Merophy/enzyme/README.md

# enzyme
Enzymes are proteins that help speed up metabolism, or the chemical reactions in our bodies. They build some substances and break others down. All living things have enzymes.
