Merophy/enzyme/kiCad-solids/BallGridArray/CLG484.step

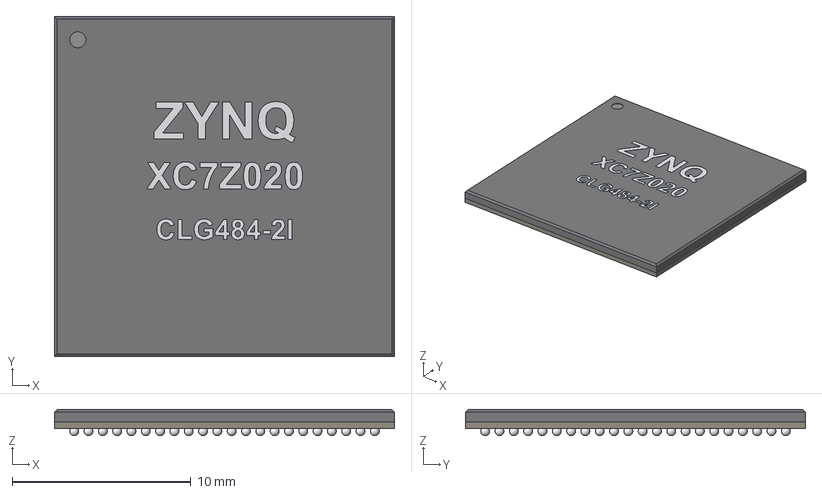
[picture p1: CAD file, 2026-10-07]
kiCad-solids/BallGridArray/CLG484.step
19.0 x 19.0 x 1.47 mm
Substrate
Pin1
Balls
Marking
