Merophy/enzyme/kiCad-solids/Bar/Copper_20x2.5x0.8mm.step

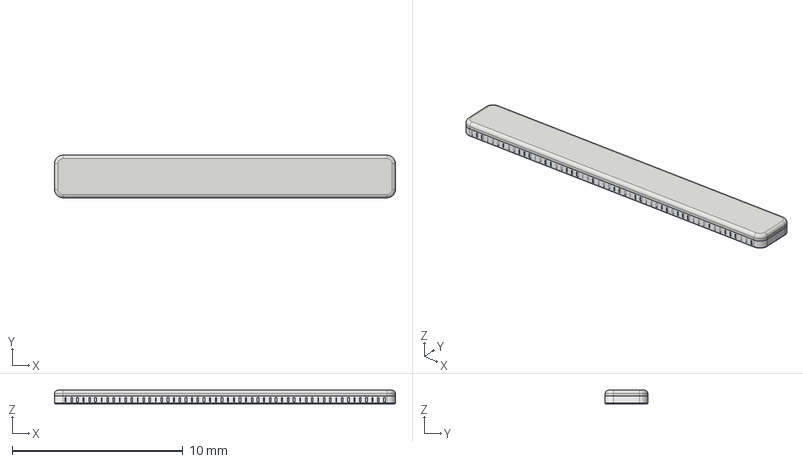
[picture p2: CAD file, 2026-10-09]
kiCad-solids/Bar/Copper_20x2.5x0.8mm.step
20.0 x 2.50 x 0.8 mm
TinTop
TinCut
