Merophy/enzyme/kiCad-solids/Batteries/9VDuracellBattery.step

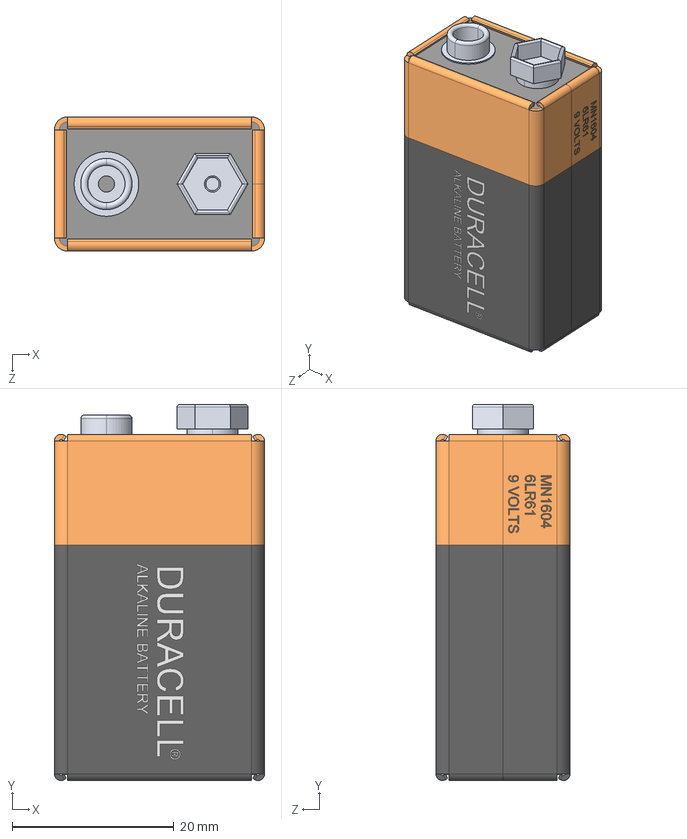
[picture p3: CAD file, 2024-03-21]
kiCad-solids/Batteries/9VDuracellBattery.step
26.0 x 46.5 x 16.6 mm
