Merophy/enzyme/kiCad-solids/Capacitors/C-0201-0603.step

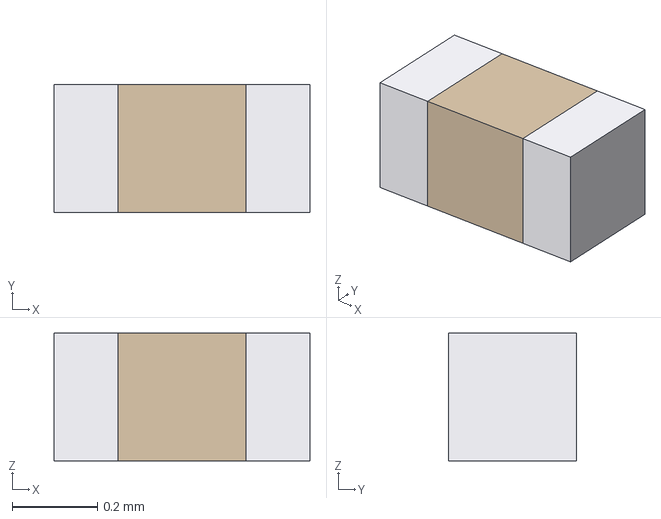
[picture p4: CAD file, 2026-10-22]
kiCad-solids/Capacitors/C-0201-0603.step
0.6 x 0.3 x 0.3 mm
MLCC
Terminals
