Merophy/enzyme/kiCad-solids/Connectors/SMTSO4260.step

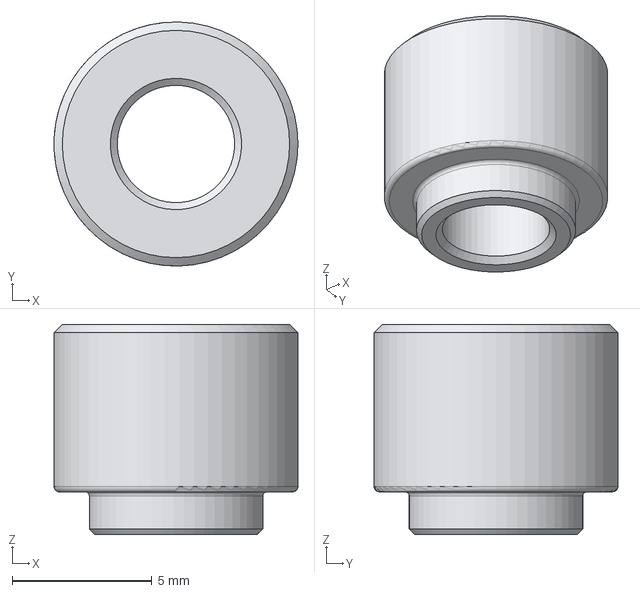
[picture p5: CAD file, 2026-10-24]
kiCad-solids/Connectors/SMTSO4260.step
8.74 x 8.74 x 7.53 mm
