Merophy/enzyme/kiCad-solids/Crystals/Oscillator_SMD_3.2x2.5mm.step

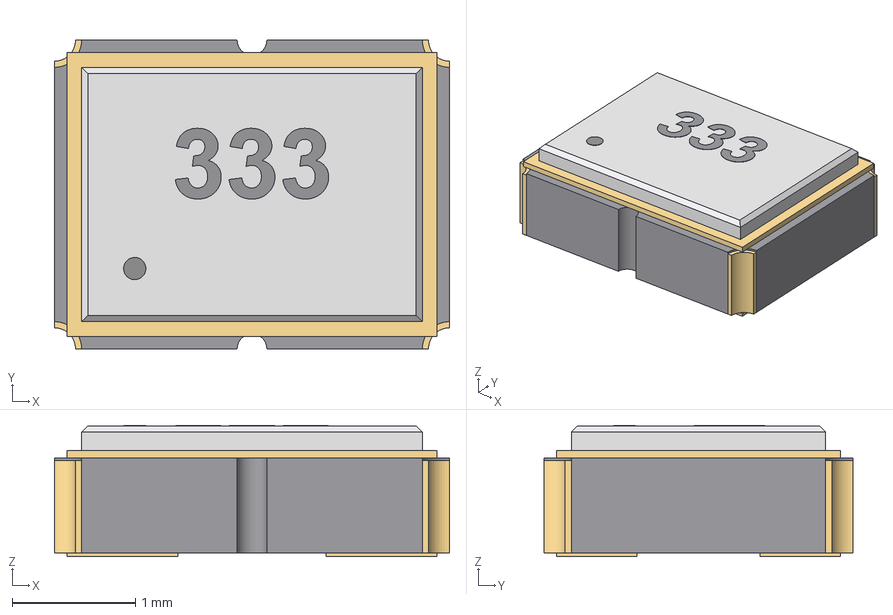
[picture p6: CAD file, 2026-10-09]
kiCad-solids/Crystals/Oscillator_SMD_3.2x2.5mm.step
3.20 x 2.50 x 1.06 mm
Ceramic
Gold
Lid
Pin1
Ink
