Merophy/enzyme/kiCad-solids/Diodes/SOD-523.step

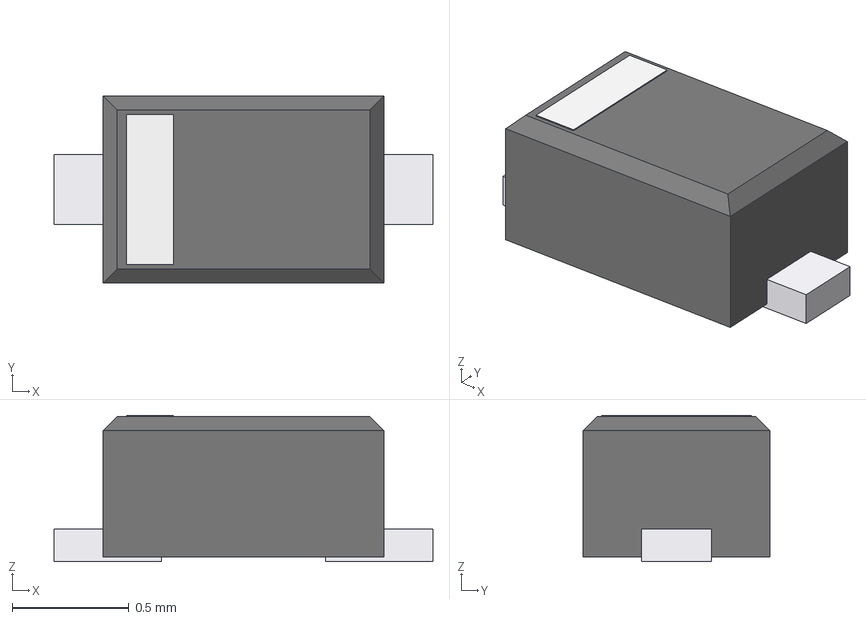
[picture p7: CAD file, 2026-09-24]
kiCad-solids/Diodes/SOD-523.step
1.62 x 0.8 x 0.625 mm
Band
Pin1
Pin2
