Merophy/enzyme/kiCad-solids/DualFlat/PG-TSNP-7-11.step

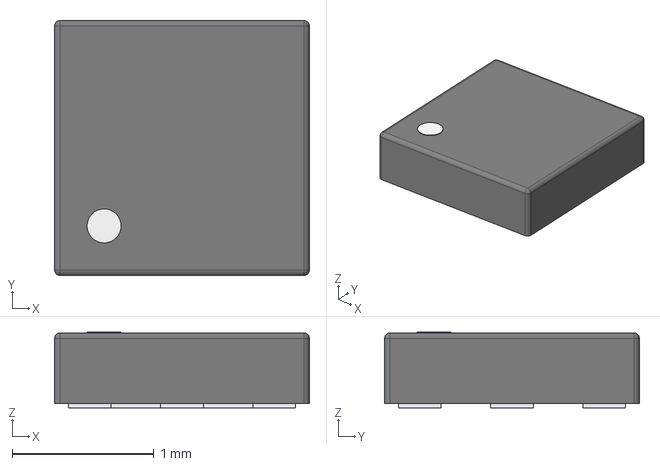
[picture p8: CAD file, 2026-10-24]
kiCad-solids/DualFlat/PG-TSNP-7-11.step
1.80 x 1.80 x 0.535 mm
