Merophy/enzyme/kiCad-solids/Electromechanic/TF-01A.step

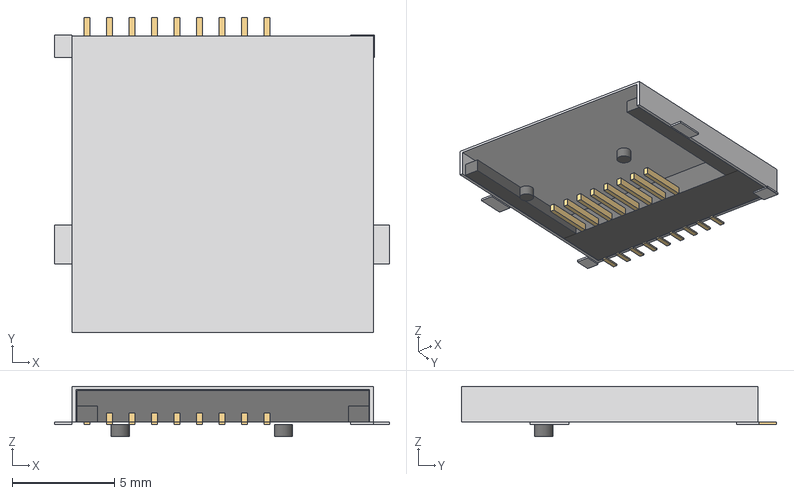
[picture p9: CAD file, 2026-10-22]
kiCad-solids/Electromechanic/TF-01A.step
16.4 x 15.4 x 2.45 mm
Lid
Gold
