Merophy/enzyme/kiCad-solids/Filters/FL-3.2x1.6x1.6mm.step

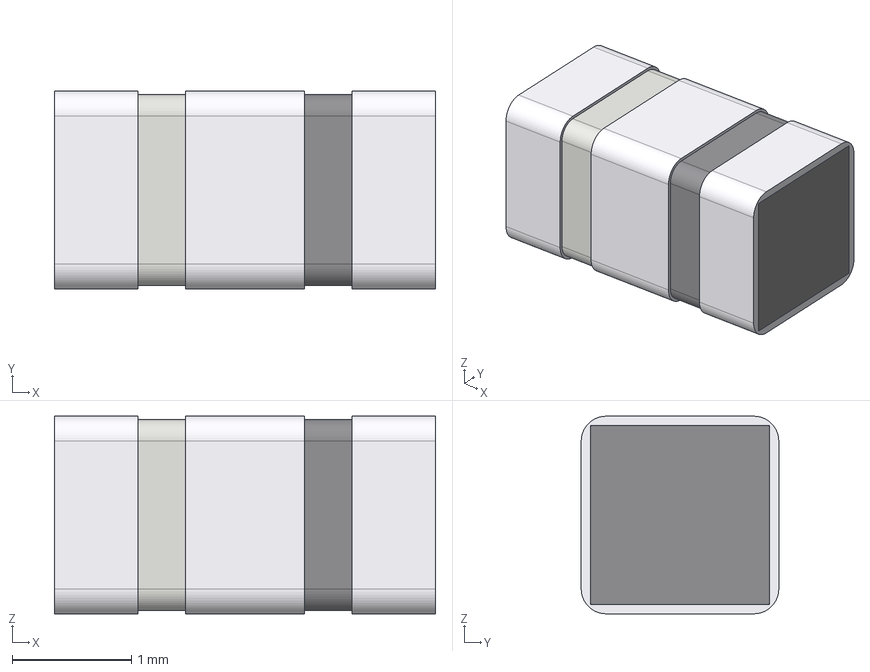
[picture p10: CAD file, 2026-10-22]
kiCad-solids/Filters/FL-3.2x1.6x1.6mm.step
3.20 x 1.66 x 1.66 mm
CeramicLight
Ferrite
Leads
