Merophy/enzyme/kiCad-solids/Inductors/HX5008NL.step

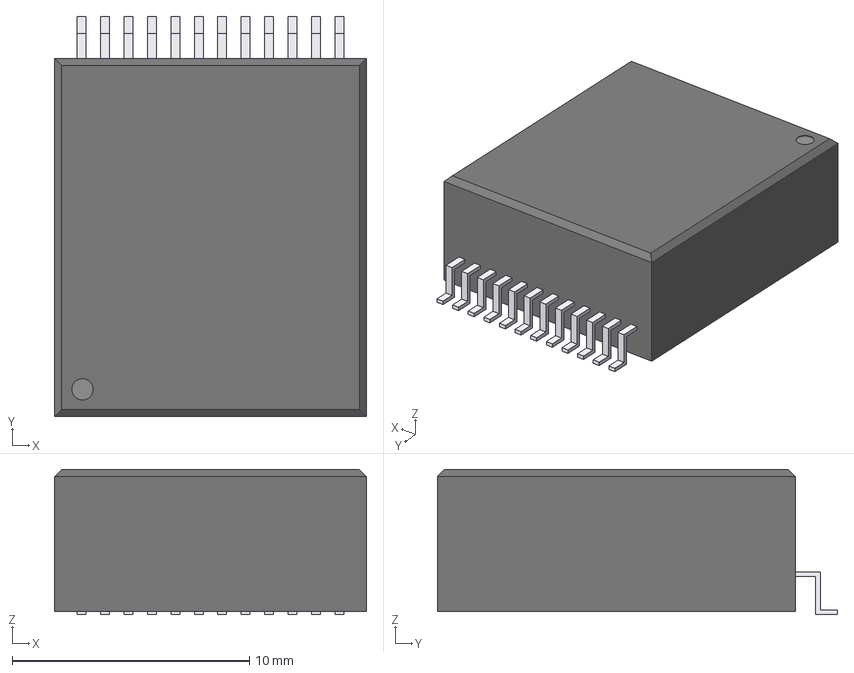
[picture p11: CAD file, 2026-10-22]
kiCad-solids/Inductors/HX5008NL.step
13.2 x 16.9 x 6.12 mm
Leads
Pin1
