Merophy/enzyme/kiCad-solids/LandGridArray/LGA-33_7x7mm.step

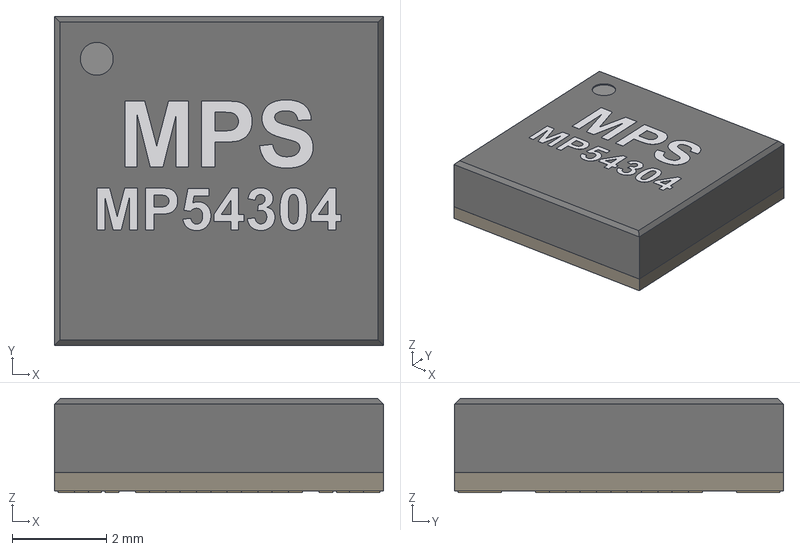
[picture p12: CAD file, 2026-10-09]
kiCad-solids/LandGridArray/LGA-33_7x7mm.step
7.00 x 7.00 x 2.00 mm
Substrate
Gold
Pin1
Marking
