Merophy/enzyme/kiCad-solids/Mechanic/M3_LowHead.step

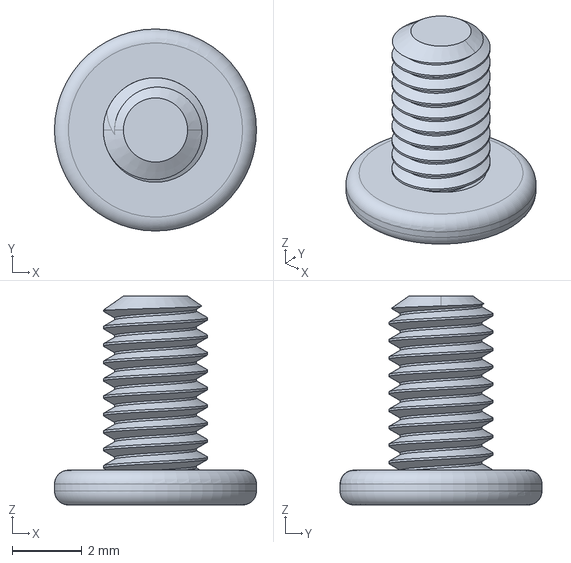
[picture p13: CAD file, 2025-07-31]
kiCad-solids/Mechanic/M3_LowHead.step
5.80 x 5.80 x 6.00 mm
