Merophy/enzyme/kiCad-solids/Modules/MS4525DO.step

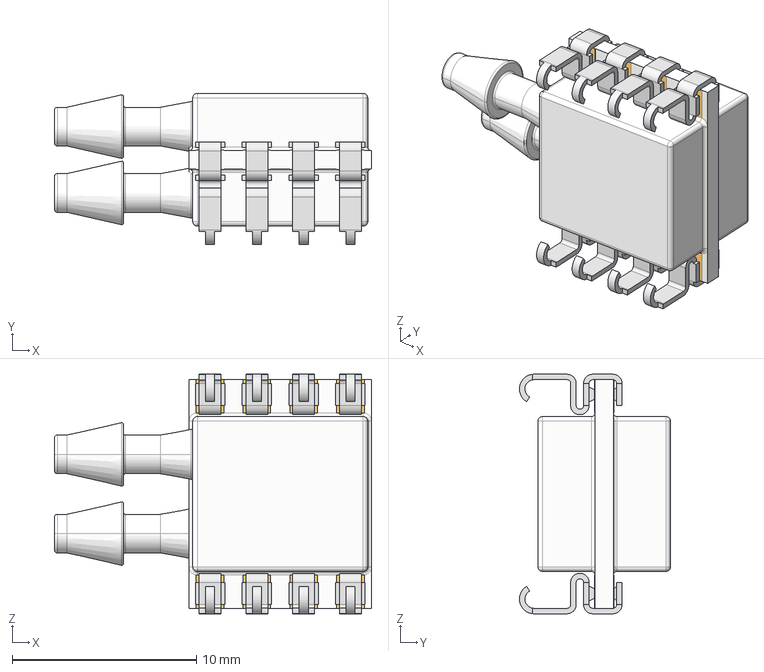
[picture p14: CAD file, 2025-08-16]
kiCad-solids/Modules/MS4525DO.step
17.2 x 8.20 x 13.0 mm
