Merophy/enzyme/kiCad-solids/QuadFlat/VQFN-14-EP_3.5x3.5mm_RGY.step

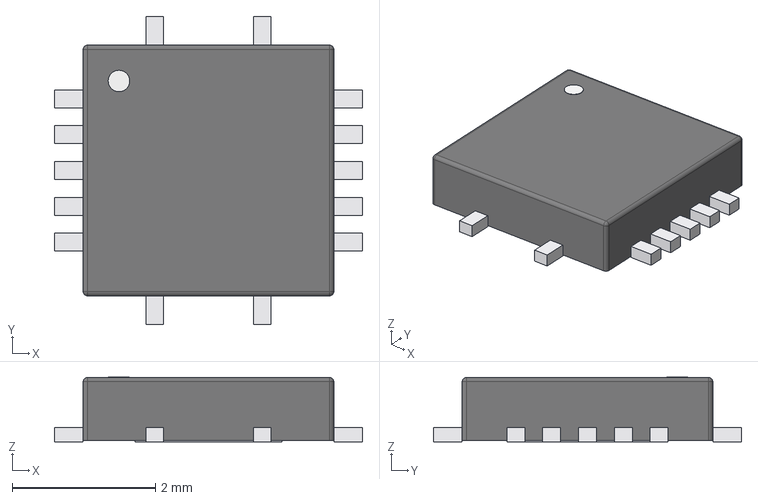
[picture p15: CAD file, 2026-10-29]
kiCad-solids/QuadFlat/VQFN-14-EP_3.5x3.5mm_RGY.step
4.30 x 4.30 x 0.905 mm
