Merophy/enzyme/kiCad-solids/Radio/TAOGLAS_PA.25A.step

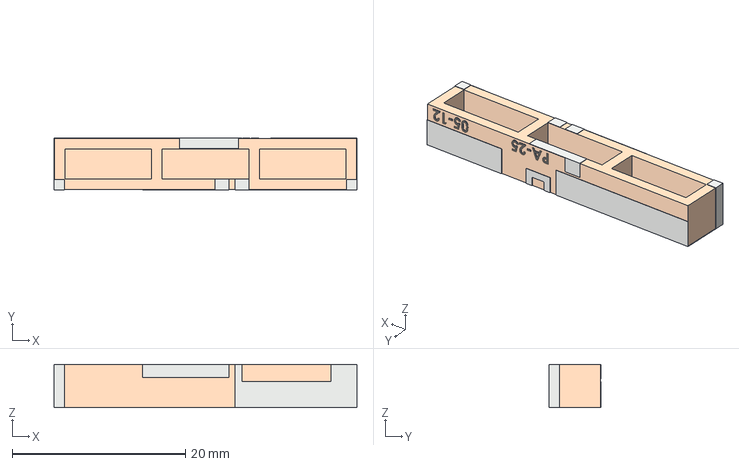
[picture p16: CAD file, 2022-10-01]
kiCad-solids/Radio/TAOGLAS_PA.25A.step
35.0 x 6.00 x 5.00 mm
