Merophy/enzyme/kiCad-solids/Resistors/R-0612-1632.step

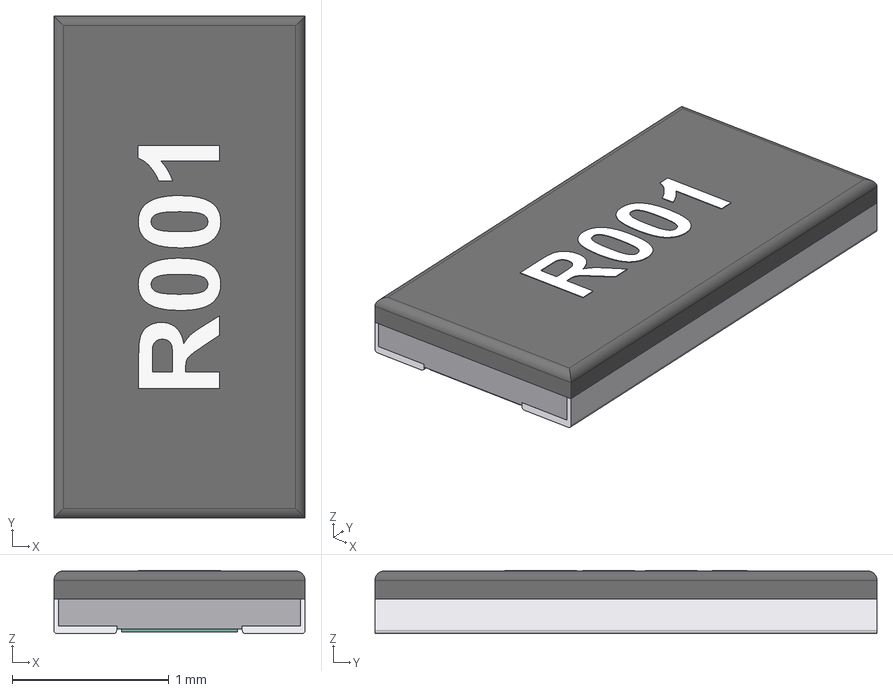
[picture p17: CAD file, 2026-10-07]
kiCad-solids/Resistors/R-0612-1632.step
1.60 x 3.20 x 0.404 mm
Epoxy
Alloy
Coating
Pin1
Pin2
Marking
