Merophy/enzyme/kiCad-solids/SmallOutline/SOT-563.step

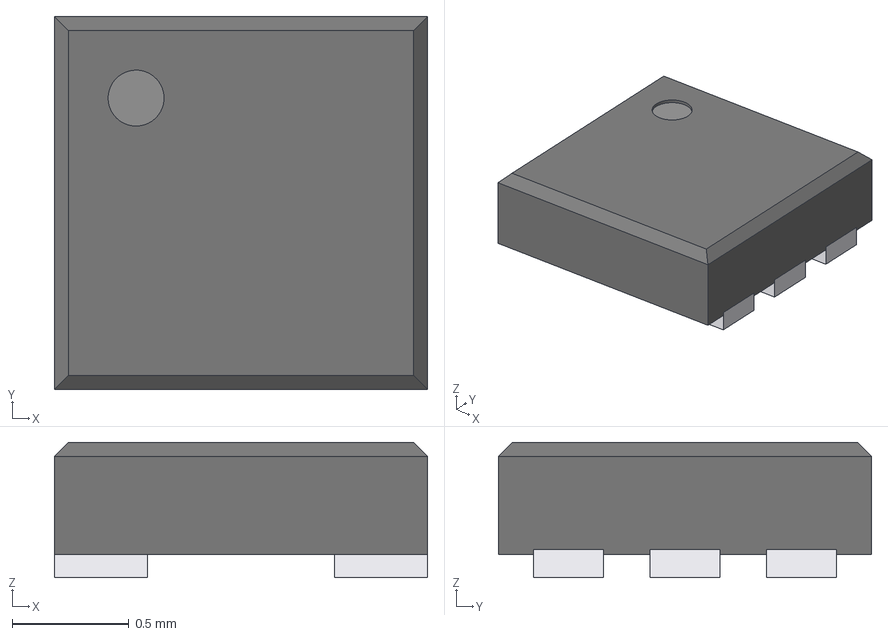
[picture p18: CAD file, 2026-10-16]
kiCad-solids/SmallOutline/SOT-563.step
1.60 x 1.60 x 0.58 mm
Leads
Pin1
