Merophy/enzyme/kiCad-solids/BallGridArray/TFBGA265_14X14.step

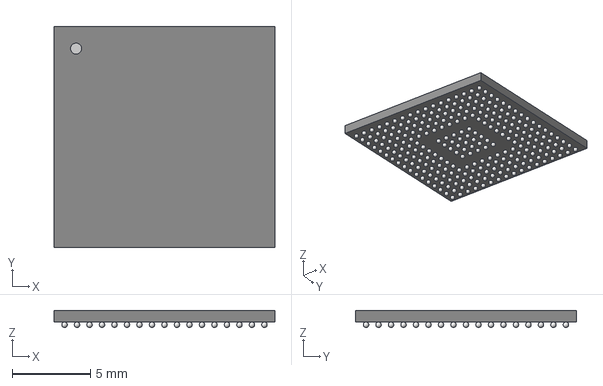
[picture p19: CAD file, 2026-01-16]
kiCad-solids/BallGridArray/TFBGA265_14X14.step
14.1 x 14.1 x 1.09 mm
