Merophy/enzyme/kiCad-solids/Bar/Copper_17x3x2.8mm.step

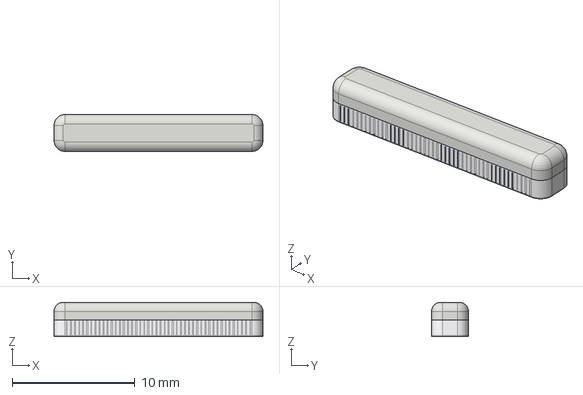
[picture p20: CAD file, 2026-10-09]
kiCad-solids/Bar/Copper_17x3x2.8mm.step
17.0 x 3.00 x 2.80 mm
TinTop
TinCut
