Merophy/enzyme/kiCad-solids/Batteries/MS621FE.step

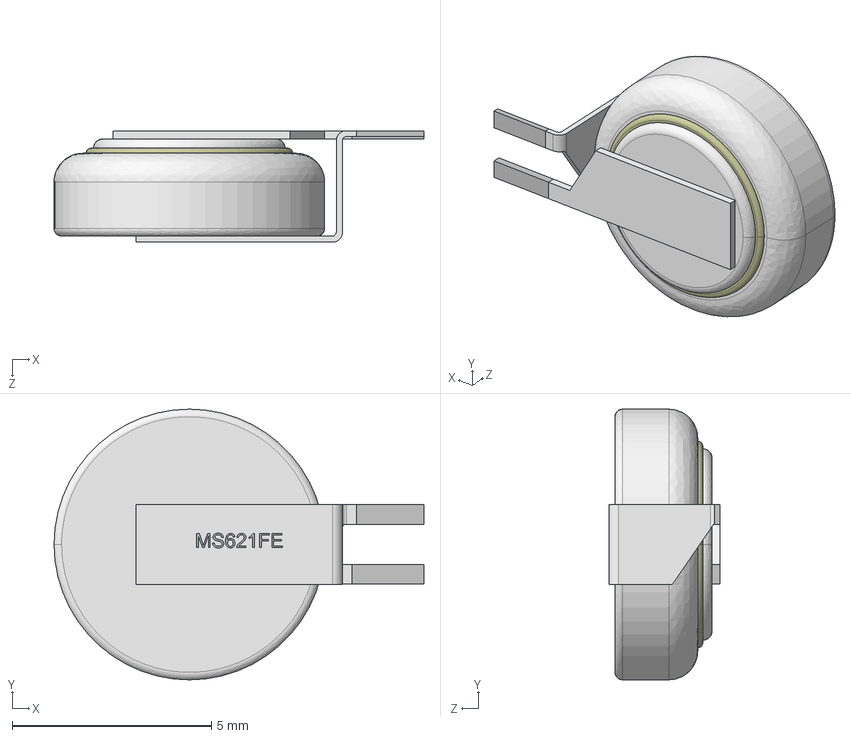
[picture p21: CAD file, 2022-10-01]
kiCad-solids/Batteries/MS621FE.step
9.29 x 6.80 x 2.80 mm
