Merophy/enzyme/kiCad-solids/Capacitors/CP-3528.step

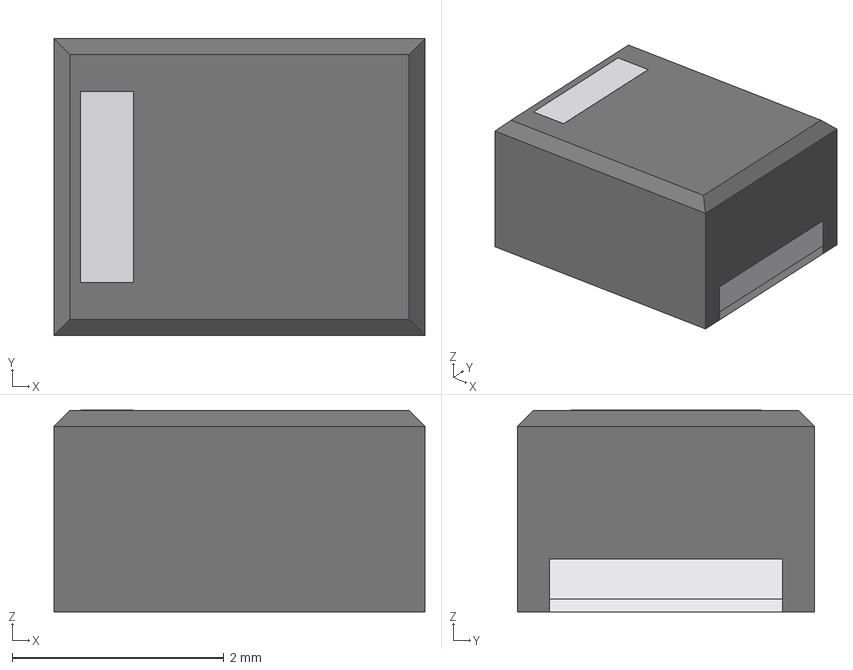
[picture p22: CAD file, 2026-10-22]
kiCad-solids/Capacitors/CP-3528.step
3.50 x 2.80 x 1.90 mm
Leads
Marking
