Merophy/enzyme/kiCad-solids/Crystals/Xtal_SMD_3215.step

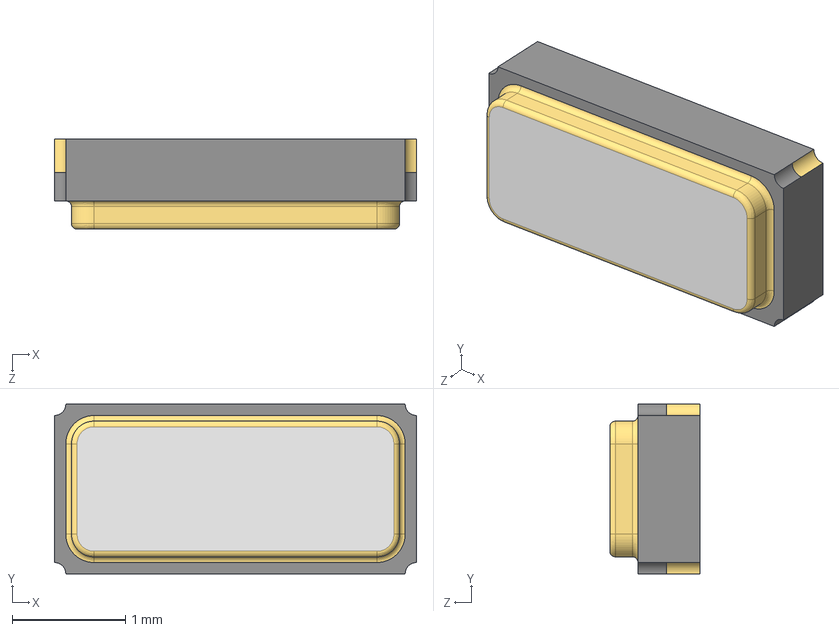
[picture p23: CAD file, 2026-01-16]
kiCad-solids/Crystals/Xtal_SMD_3215.step
3.20 x 1.50 x 0.8 mm
