Merophy/enzyme/kiCad-solids/Diodes/LED-2835.step

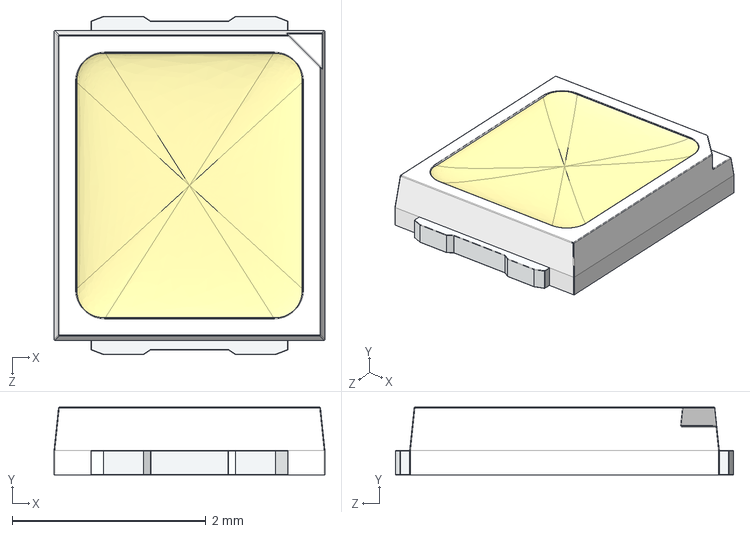
[picture p24: CAD file, 2025-07-24]
kiCad-solids/Diodes/LED-2835.step
2.80 x 0.7 x 3.50 mm
