Merophy/enzyme/kiCad-solids/DualFlat/WSON-10-EP_3x3mm_DSC.step

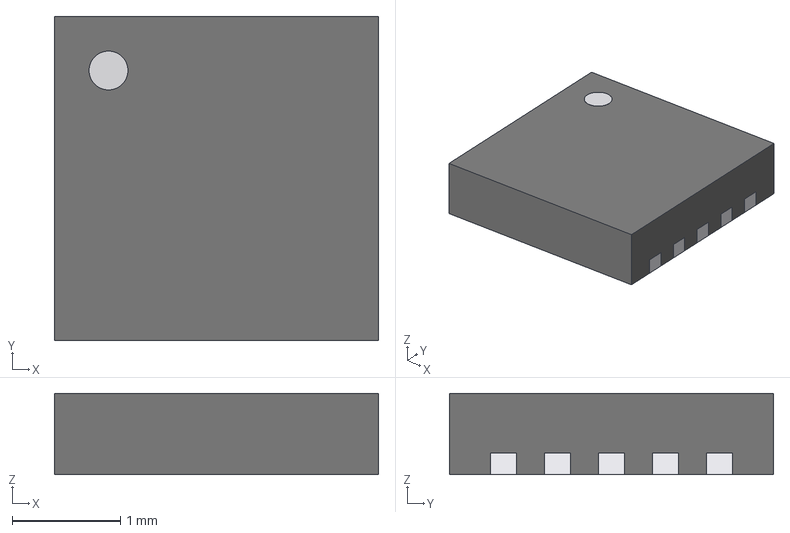
[picture p25: CAD file, 2026-10-22]
kiCad-solids/DualFlat/WSON-10-EP_3x3mm_DSC.step
3.00 x 3.00 x 0.751 mm
Leads
Marking
