Merophy/enzyme/kiCad-solids/Electromechanic/RS08U111Z001.STEP

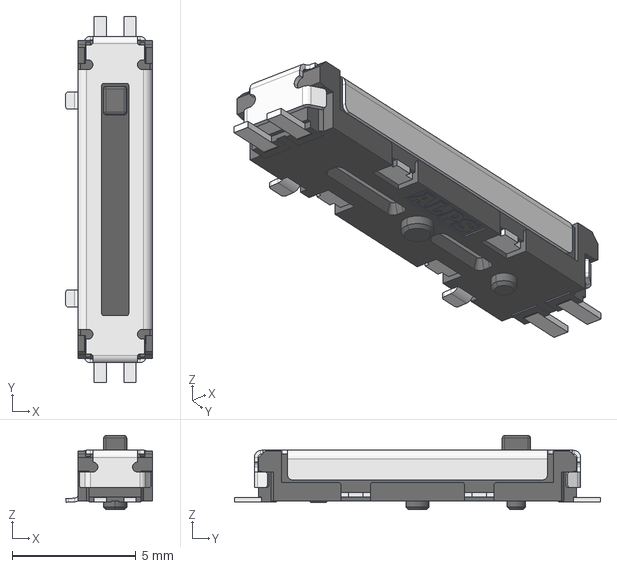
[picture p26: CAD file, 2025-05-27]
kiCad-solids/Electromechanic/RS08U111Z001.STEP
3.50 x 14.8 x 3.00 mm
