Merophy/enzyme/kiCad-solids/Inductors/L-2.5x2.0x1.2mm.step

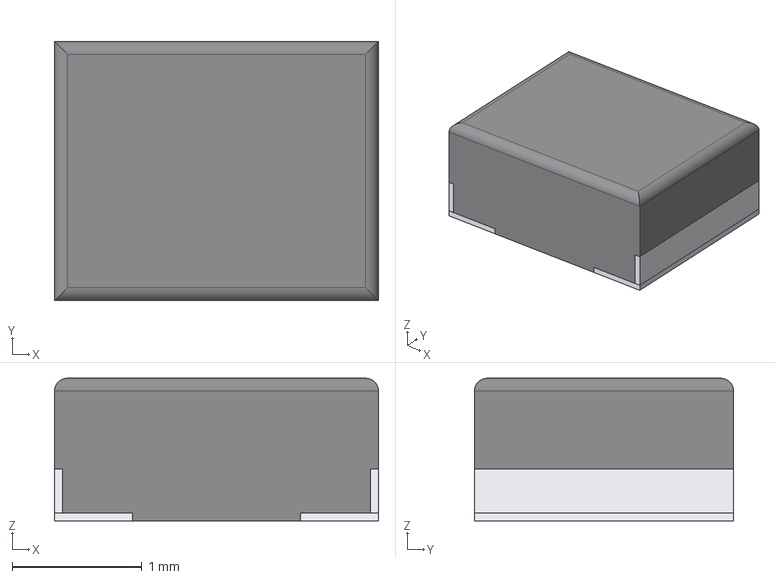
[picture p27: CAD file, 2026-10-22]
kiCad-solids/Inductors/L-2.5x2.0x1.2mm.step
2.50 x 2.00 x 1.10 mm
Ferrite
Leads
