Merophy/enzyme/kiCad-solids/Mechanic/M3 x 0.5mm Thread 35mm.STEP

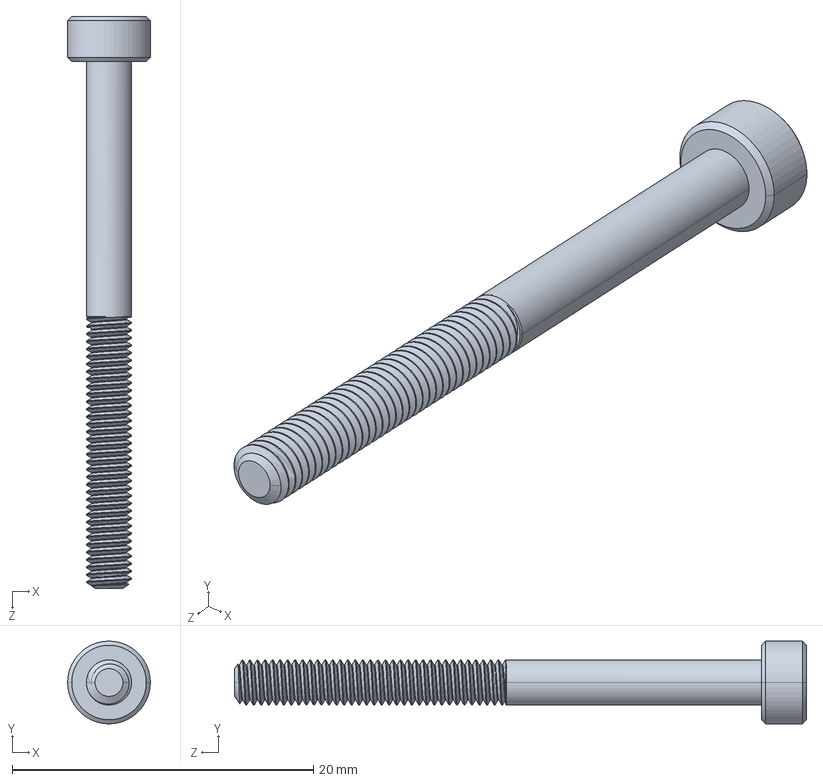
[picture p28: CAD file, 2025-02-19]
kiCad-solids/Mechanic/M3 x 0.5mm Thread 35mm.STEP
5.50 x 5.50 x 38.0 mm
