Merophy/enzyme/kiCad-solids/Modules/fan_40_40_28_coloured.step

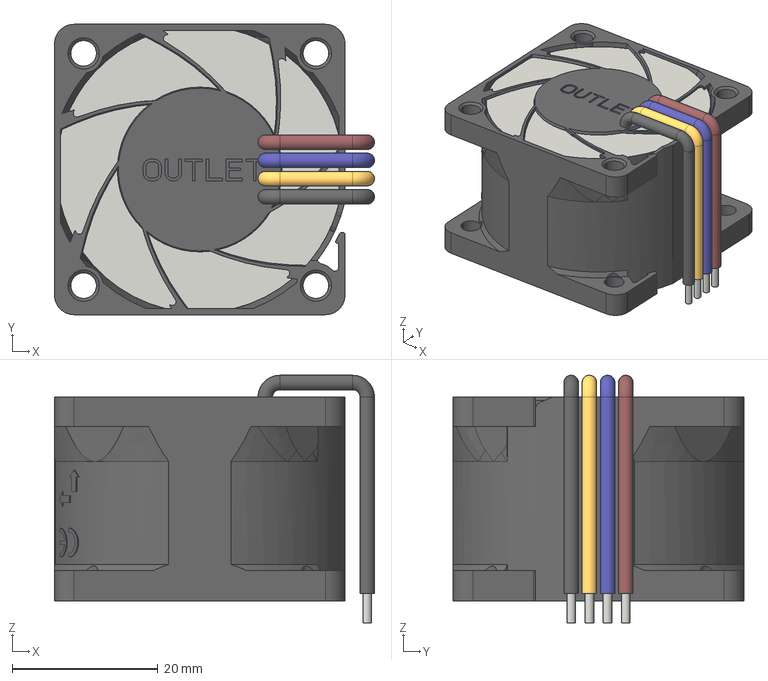
[picture p29: CAD file, 2025-02-14]
kiCad-solids/Modules/fan_40_40_28_coloured.step
43.9 x 39.9 x 34.0 mm
_K201001120G-3_
