Merophy/enzyme/kiCad-solids/QuadFlat/WQFN-24-EP_4x4mm_RTW.step

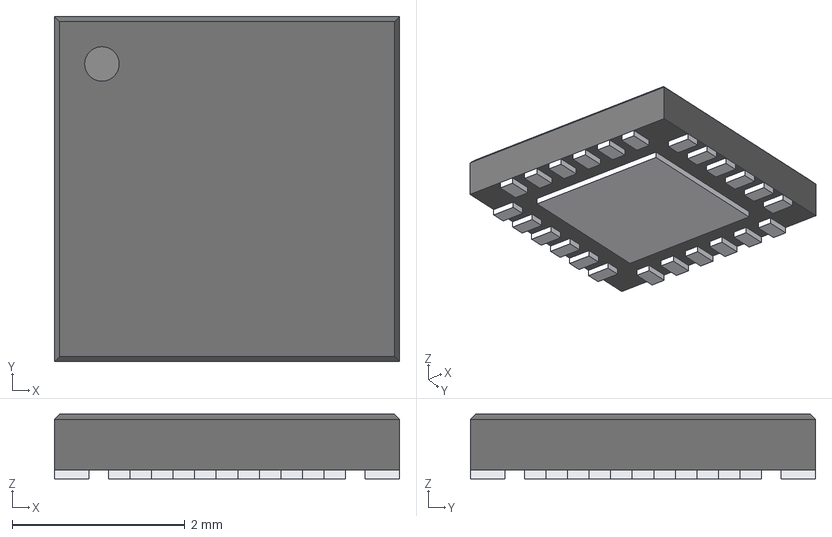
[picture p30: CAD file, 2026-10-22]
kiCad-solids/QuadFlat/WQFN-24-EP_4x4mm_RTW.step
4.00 x 4.00 x 0.75 mm
Leads
Pin1
