Merophy/enzyme/kiCad-solids/Resistors/R-0402-1005.step

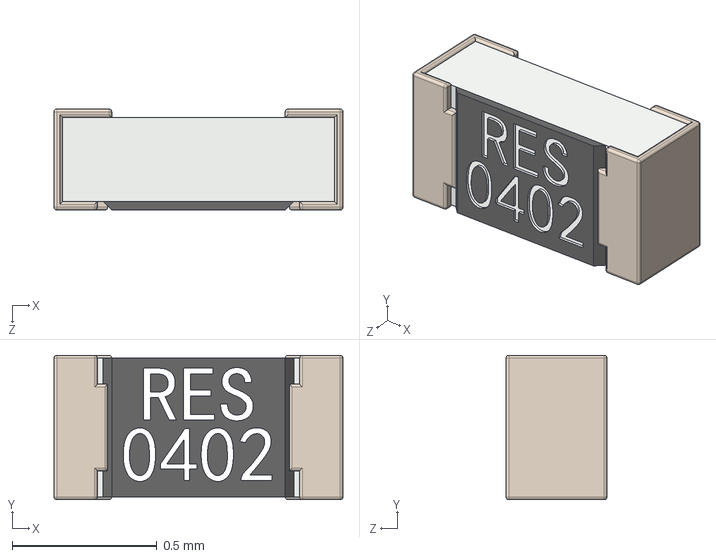
[picture p31: CAD file, 2026-01-05]
kiCad-solids/Resistors/R-0402-1005.step
1.00 x 0.5 x 0.35 mm
