Merophy/enzyme/kiCad-solids/SmallOutline/VSSOP-10_3x3mm.step

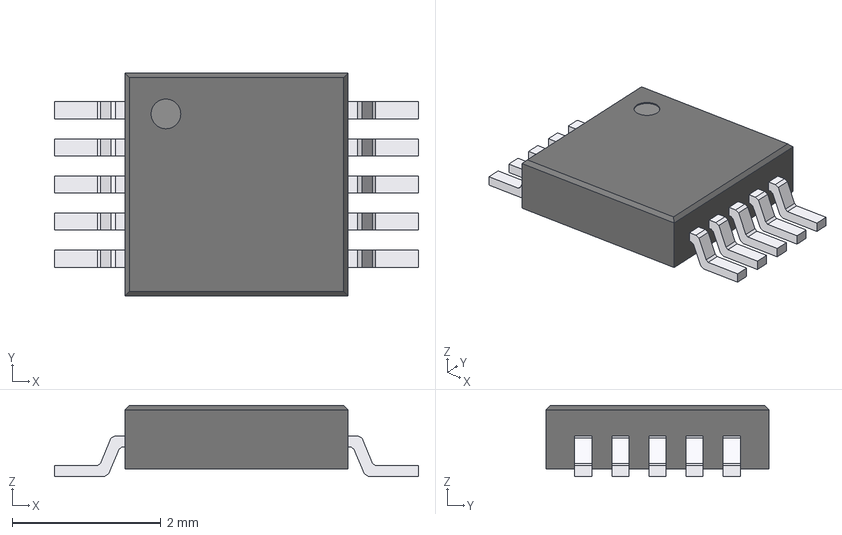
[picture p32: CAD file, 2026-10-14]
kiCad-solids/SmallOutline/VSSOP-10_3x3mm.step
4.90 x 3.00 x 0.96 mm
Leads
Pin1
