Merophy/enzyme/kiCad-solids/Capacitors/C-1210.STEP

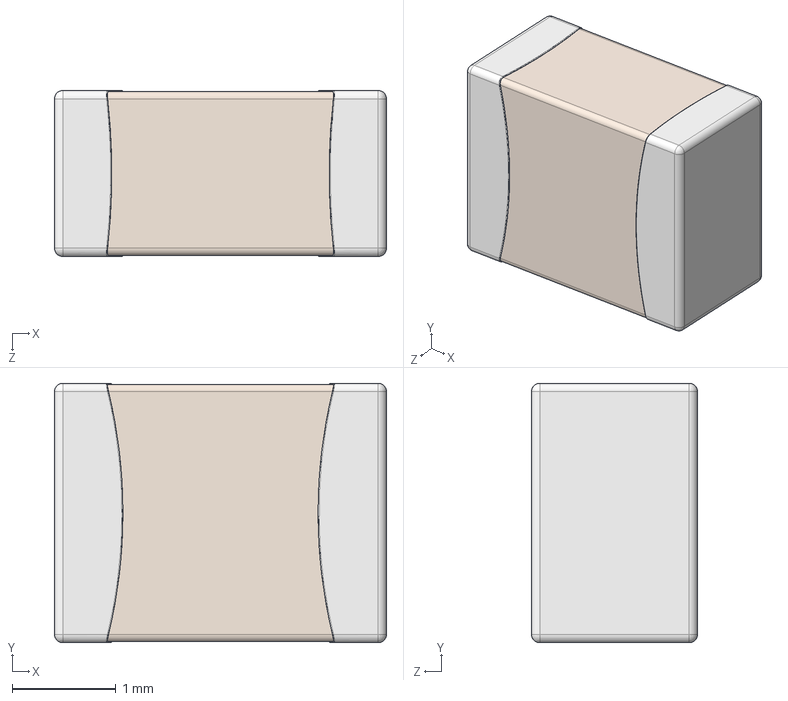
[picture p33: CAD file, 2026-01-05]
kiCad-solids/Capacitors/C-1210.STEP
3.20 x 2.50 x 1.60 mm
Pin1
Pin2
CeramicBody
