Merophy/enzyme/kiCad-solids/Connectors/RJHSE-5381.step

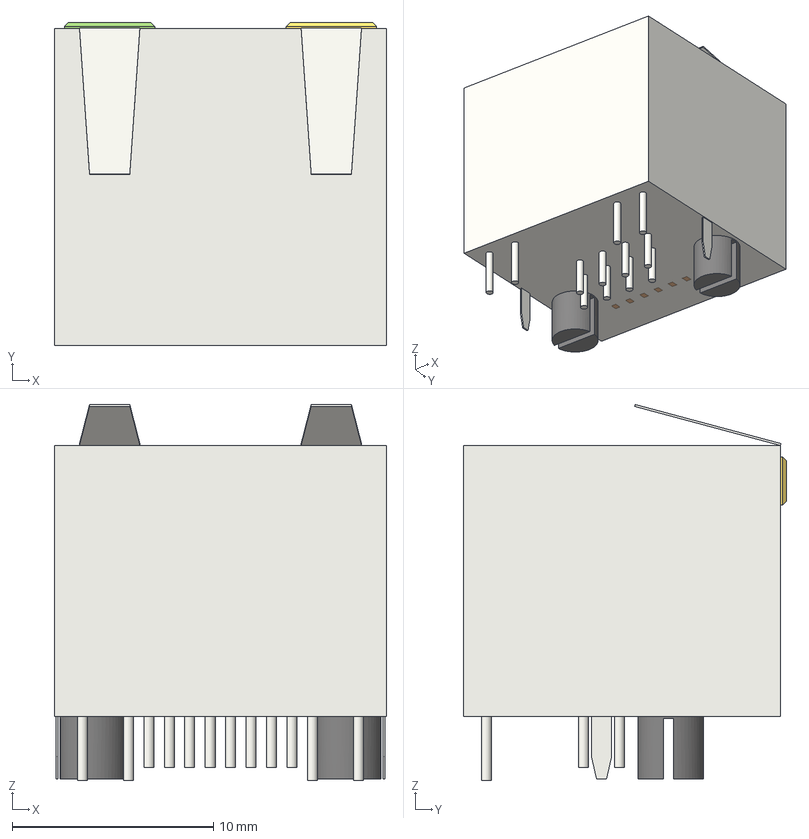
[picture p34: CAD file, 2026-10-22]
kiCad-solids/Connectors/RJHSE-5381.step
16.5 x 16.1 x 18.7 mm
