Merophy/enzyme/kiCad-solids/Crystals/CSTNE.step

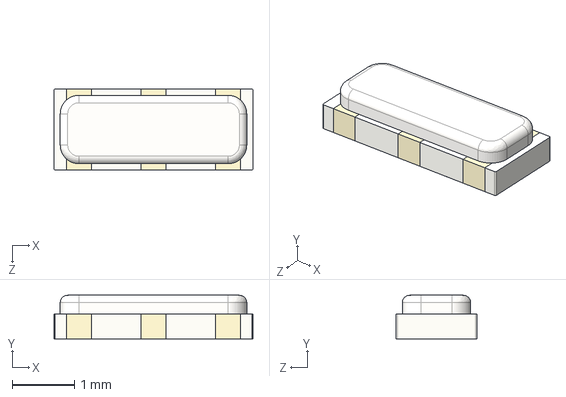
[picture p35: CAD file, 2022-03-06]
kiCad-solids/Crystals/CSTNE.step
3.20 x 0.7 x 1.30 mm
