Merophy/enzyme/kiCad-solids/Diodes/WS2812-2020.STEP

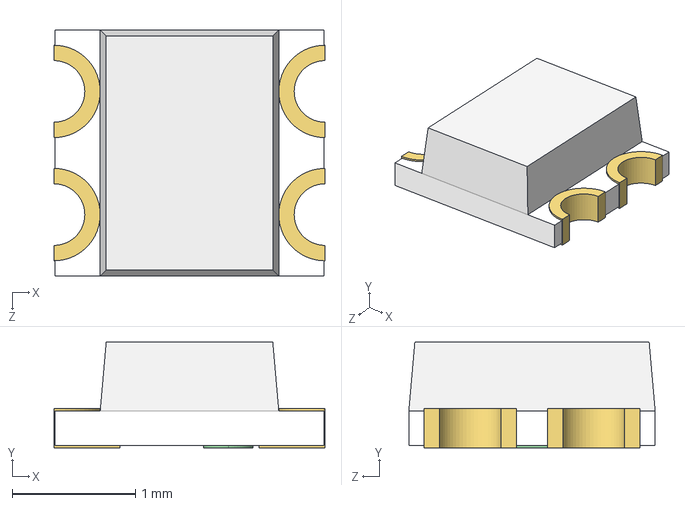
[picture p36: CAD file, 2025-03-19]
kiCad-solids/Diodes/WS2812-2020.STEP
2.20 x 0.86 x 2.00 mm
