Merophy/enzyme/kiCad-solids/DualFlat/VSON-6_1.5x1.5mm_DMQ.step

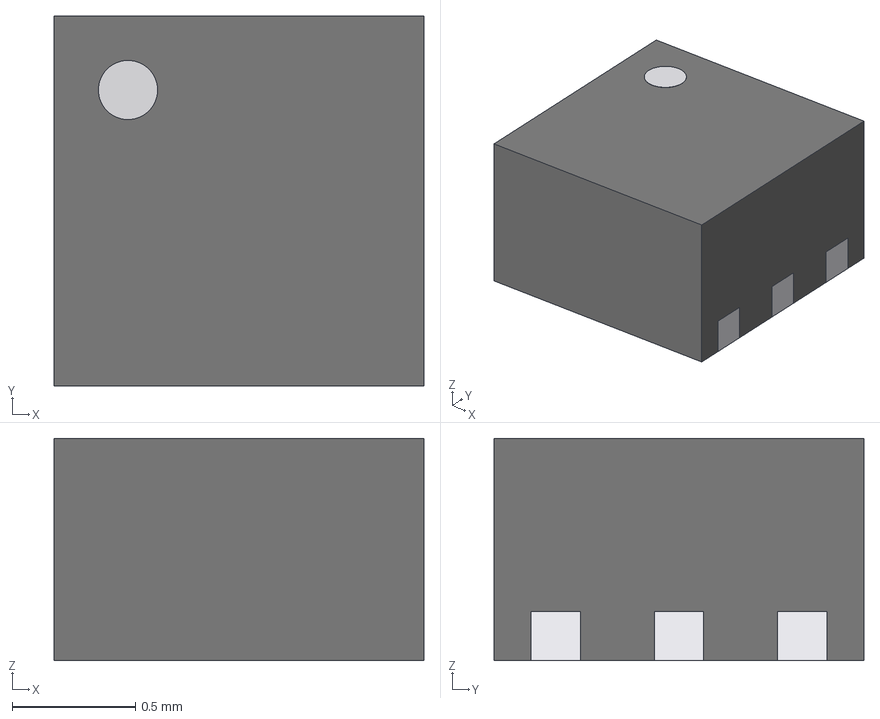
[picture p37: CAD file, 2026-10-22]
kiCad-solids/DualFlat/VSON-6_1.5x1.5mm_DMQ.step
1.50 x 1.50 x 0.901 mm
Leads
Marking
