Merophy/enzyme/kiCad-solids/Inductors/L-1206.step

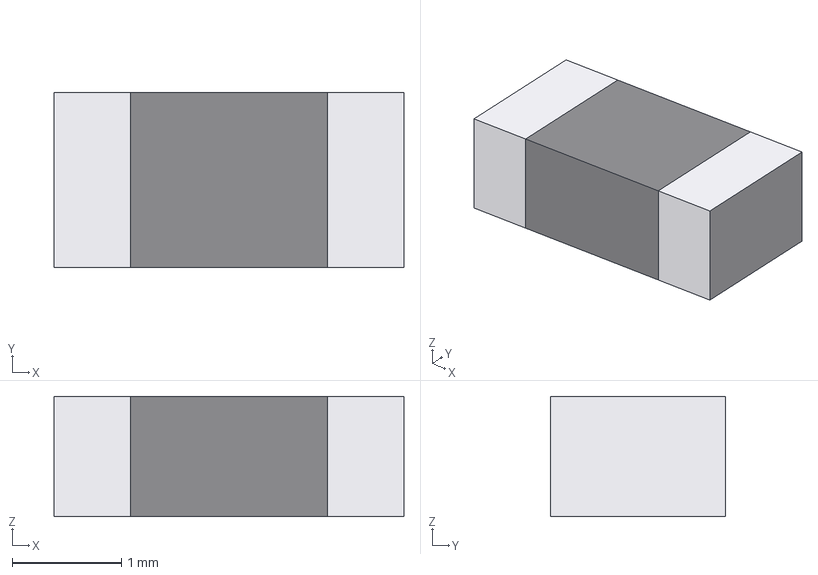
[picture p38: CAD file, 2026-10-22]
kiCad-solids/Inductors/L-1206.step
3.20 x 1.60 x 1.10 mm
Ferrite
Leads
