Merophy/enzyme/kiCad-solids/Mechanic/M2 x 0.4mm Thread 5mm.STEP

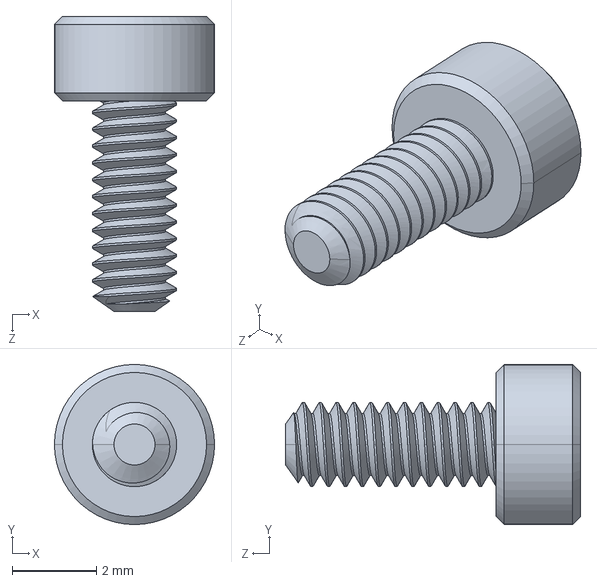
[picture p39: CAD file, 2025-02-19]
kiCad-solids/Mechanic/M2 x 0.4mm Thread 5mm.STEP
3.80 x 3.80 x 7.00 mm
