Merophy/enzyme/kiCad-solids/Modules/ESC_FLAME_80A_Coloured.step

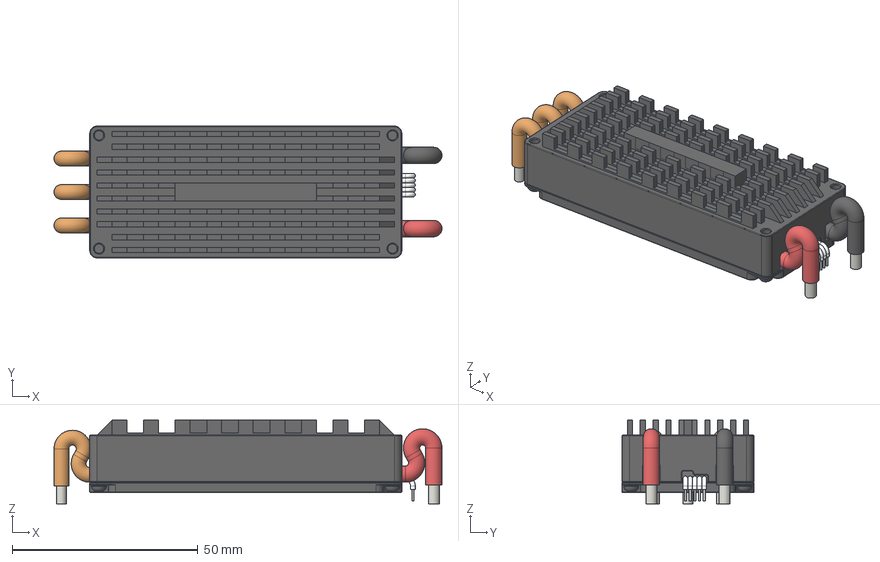
[picture p40: CAD file, 2025-02-14]
kiCad-solids/Modules/ESC_FLAME_80A_Coloured.step
104.4 x 35.5 x 22.5 mm
