Merophy/enzyme/kiCad-solids/QuadFlat/QFN-36-EP_6x6mm.step

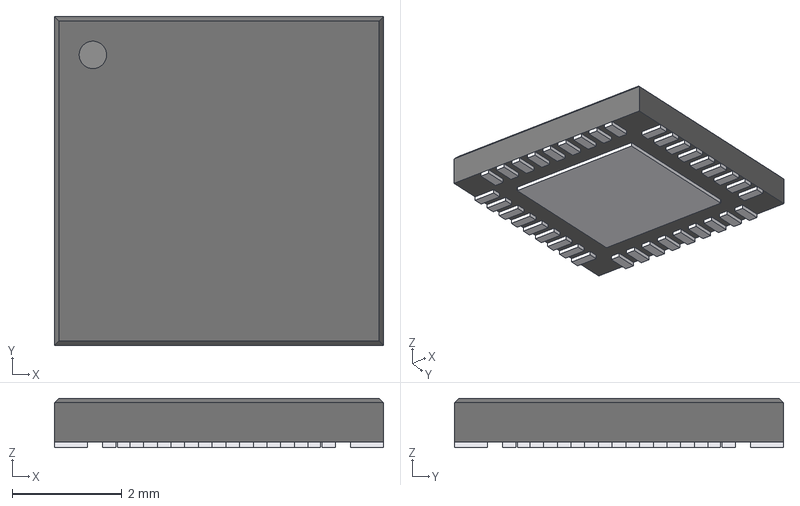
[picture p41: CAD file, 2026-10-22]
kiCad-solids/QuadFlat/QFN-36-EP_6x6mm.step
6.00 x 6.00 x 0.9 mm
Leads
Pin1
