Merophy/enzyme/kiCad-solids/Resistors/R-0805-1608.step

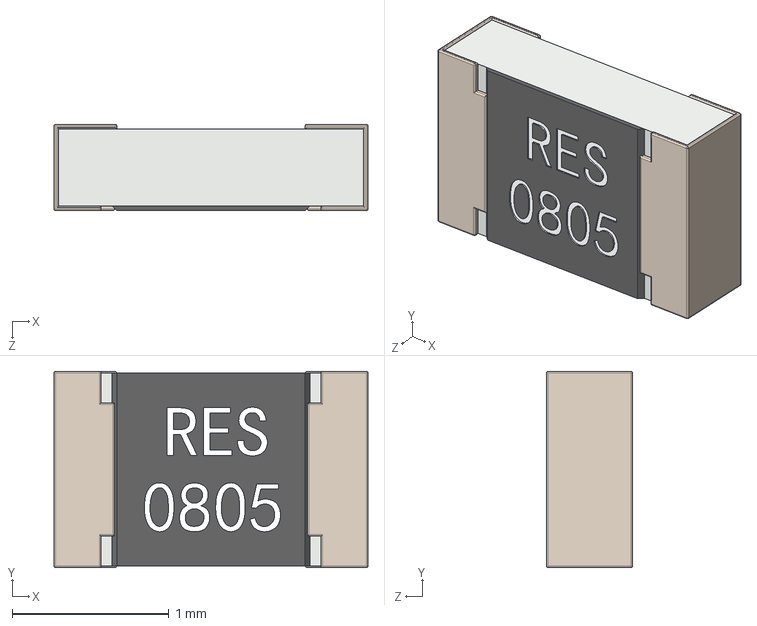
[picture p42: CAD file, 2026-01-05]
kiCad-solids/Resistors/R-0805-1608.step
2.00 x 1.25 x 0.55 mm
