Merophy/enzyme/kiCad-solids/SmallOutline/MSE16.step

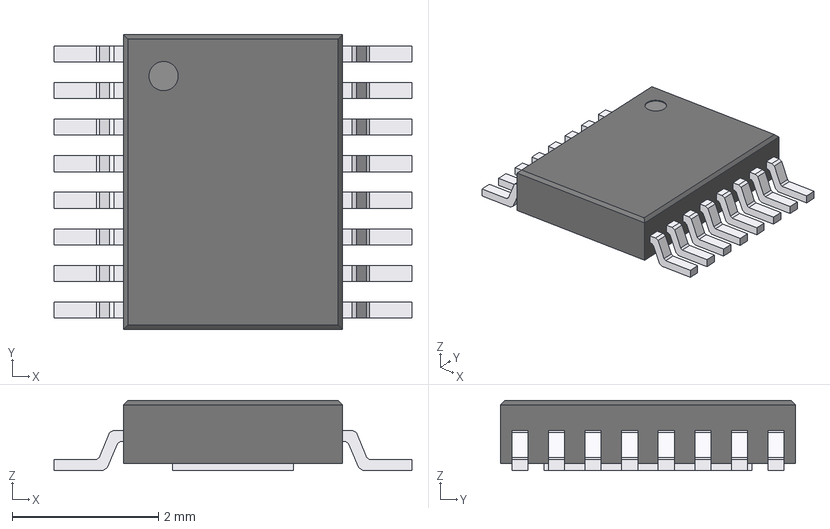
[picture p43: CAD file, 2026-10-13]
kiCad-solids/SmallOutline/MSE16.step
4.90 x 4.04 x 0.96 mm
Leads
Pin1
