Merophy/enzyme/kiCad-solids/Capacitors/C-0805-2012.step

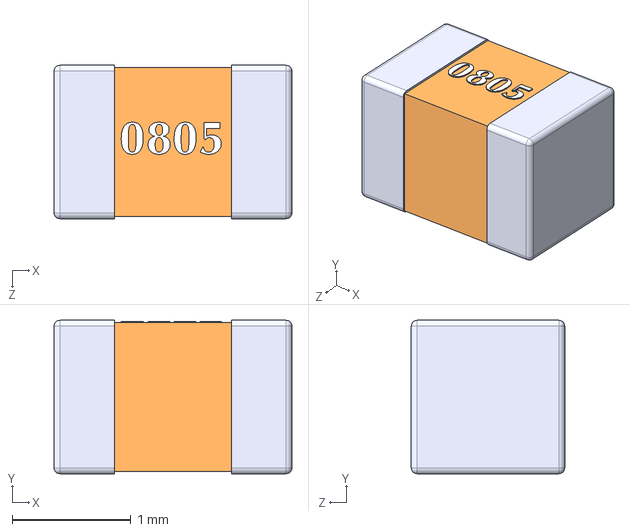
[picture p44: CAD file, 2026-01-05]
kiCad-solids/Capacitors/C-0805-2012.step
2.00 x 1.29 x 1.29 mm
