Merophy/enzyme/kiCad-solids/Connectors/JXD1-0001NL.step

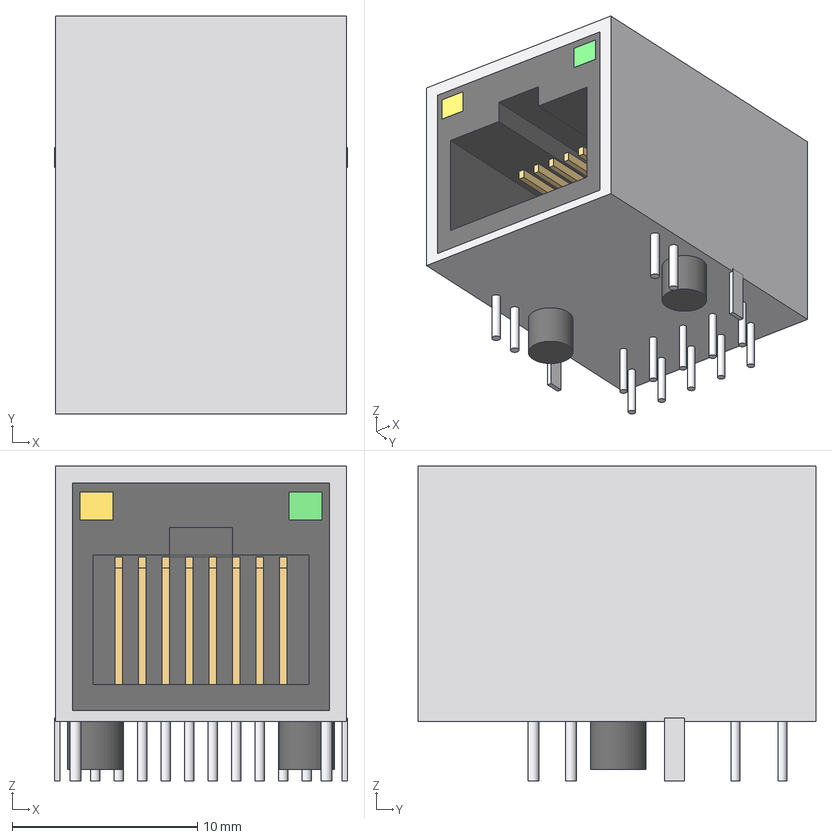
[picture p45: CAD file, 2026-10-22]
kiCad-solids/Connectors/JXD1-0001NL.step
15.8 x 21.5 x 17.0 mm
Shield
Gold
Pins
LEDYellow
LEDGreen
