Merophy/enzyme/kiCad-solids/Diodes/WS2812-0807.STEP

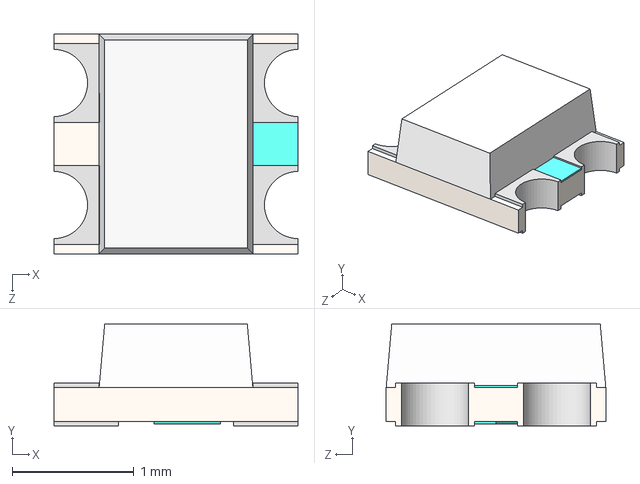
[picture p46: CAD file, 2025-03-19]
kiCad-solids/Diodes/WS2812-0807.STEP
2.00 x 0.835 x 1.80 mm
