Merophy/enzyme/kiCad-solids/DualFlat/WSON-6-2EP_2x2mm_DQK.step

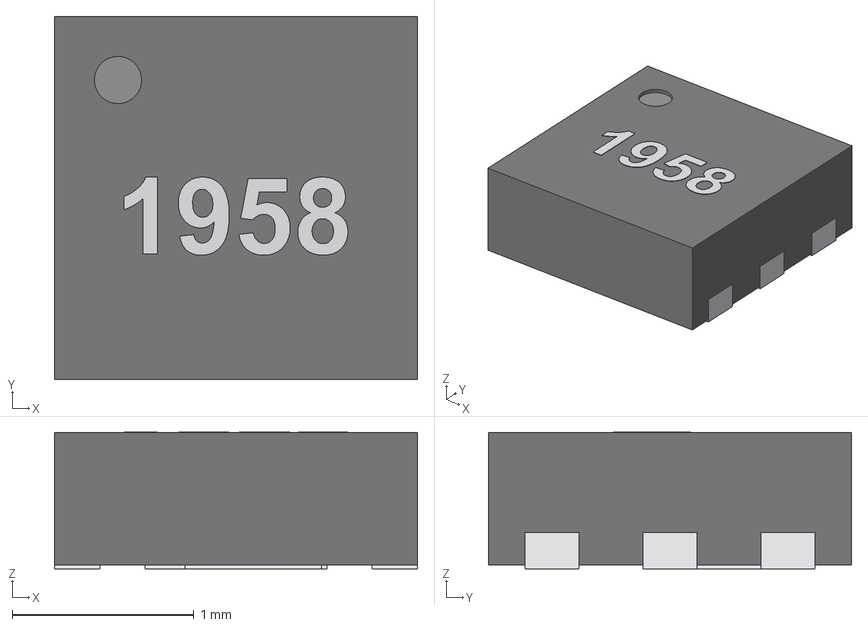
[picture p47: CAD file, 2026-10-13]
kiCad-solids/DualFlat/WSON-6-2EP_2x2mm_DQK.step
2.00 x 2.00 x 0.753 mm
Balls
Pin1
Marking
