Merophy/enzyme/kiCad-solids/Electromechanic/CR1220_Holder.step

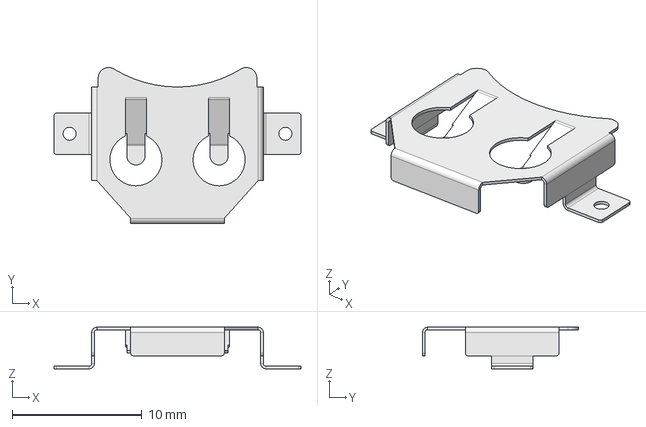
[picture p48: CAD file, 2025-05-27]
kiCad-solids/Electromechanic/CR1220_Holder.step
19.0 x 12.0 x 3.20 mm
