Merophy/enzyme/kiCad-solids/Inductors/L-3.2x2.5x1.0mm.step

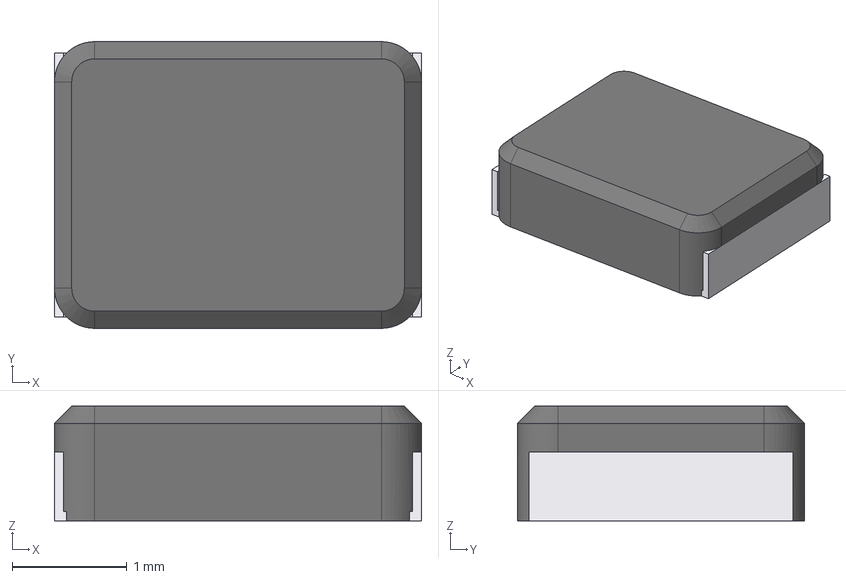
[picture p49: CAD file, 2026-10-16]
kiCad-solids/Inductors/L-3.2x2.5x1.0mm.step
3.20 x 2.50 x 1.00 mm
Leads
