Merophy/enzyme/kiCad-solids/Mechanic/M3 x 0.5mm Thread 30mm.STEP

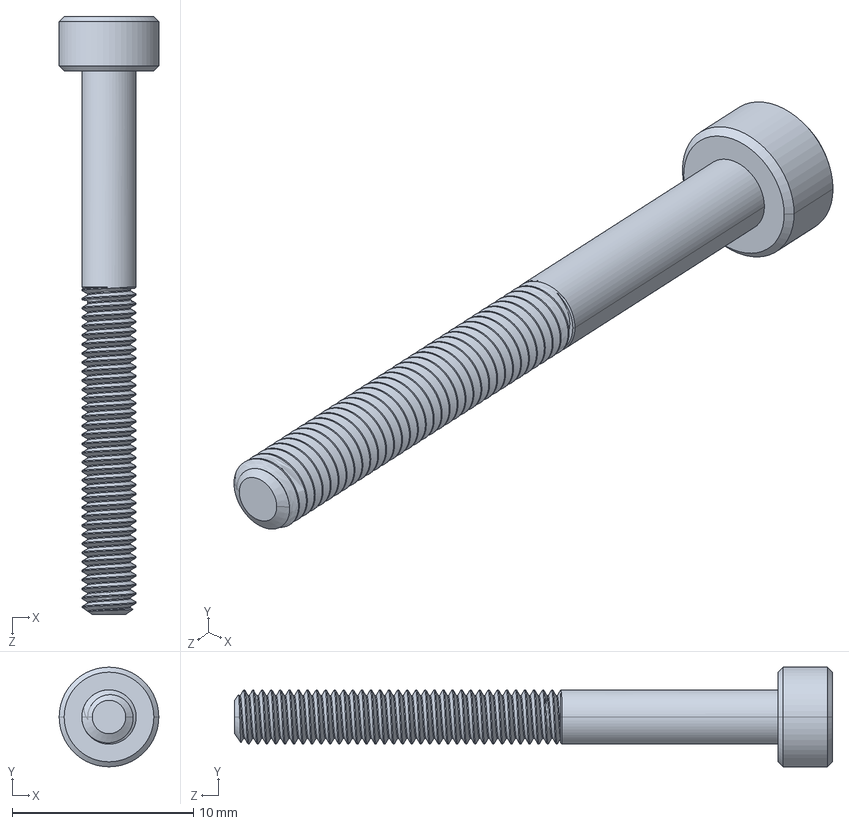
[picture p50: CAD file, 2025-02-19]
kiCad-solids/Mechanic/M3 x 0.5mm Thread 30mm.STEP
5.50 x 5.50 x 33.0 mm
