Merophy/enzyme/kiCad-solids/Modules/ESC_AT115A_Coloured.step

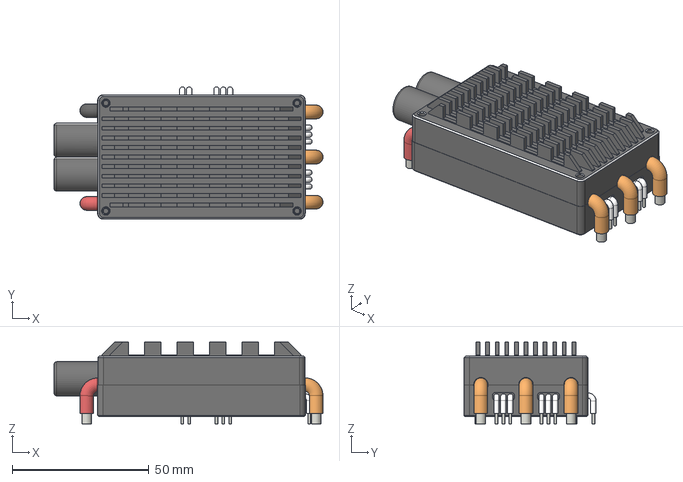
[picture p51: CAD file, 2025-02-04]
kiCad-solids/Modules/ESC_AT115A_Coloured.step
98.5 x 48.5 x 29.9 mm
