Merophy/enzyme/kiCad-solids/QuadFlat/VQFN-24-EP_3.5x5.5mm_RGY.step

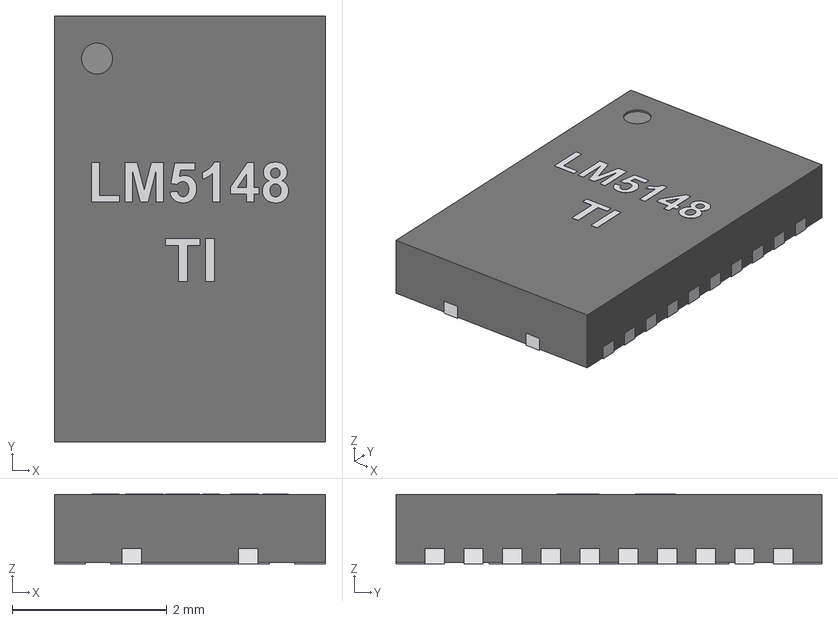
[picture p52: CAD file, 2026-10-13]
kiCad-solids/QuadFlat/VQFN-24-EP_3.5x5.5mm_RGY.step
3.50 x 5.50 x 0.903 mm
Balls
Pin1
Marking
