Merophy/enzyme/kiCad-solids/Resistors/R-0603-1609.step

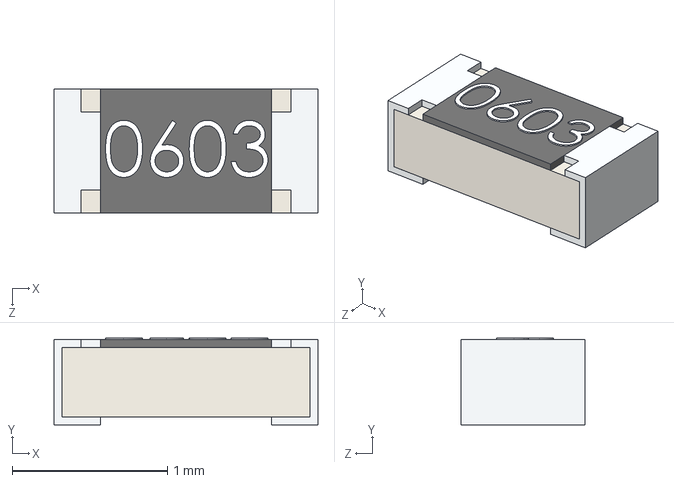
[picture p53: CAD file, 2026-01-02]
kiCad-solids/Resistors/R-0603-1609.step
1.70 x 0.56 x 0.8 mm
