Merophy/enzyme/kiCad-solids/SmallOutline/SOT-363.step

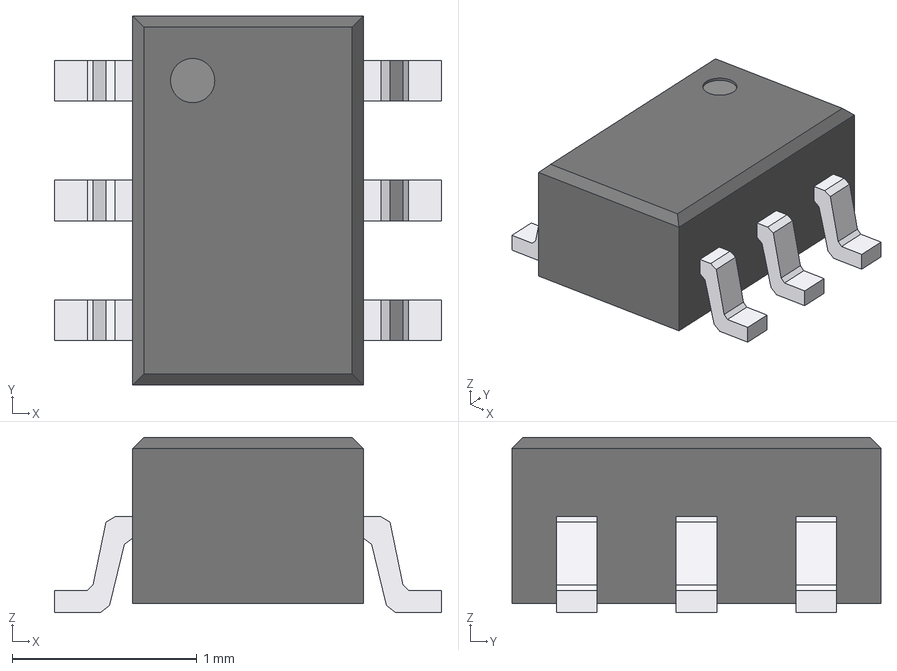
[picture p54: CAD file, 2026-10-09]
kiCad-solids/SmallOutline/SOT-363.step
2.10 x 2.00 x 0.95 mm
Leads
Pin1
