Merophy/enzyme/kiCad-solids/Capacitors/C-0402-1005.step

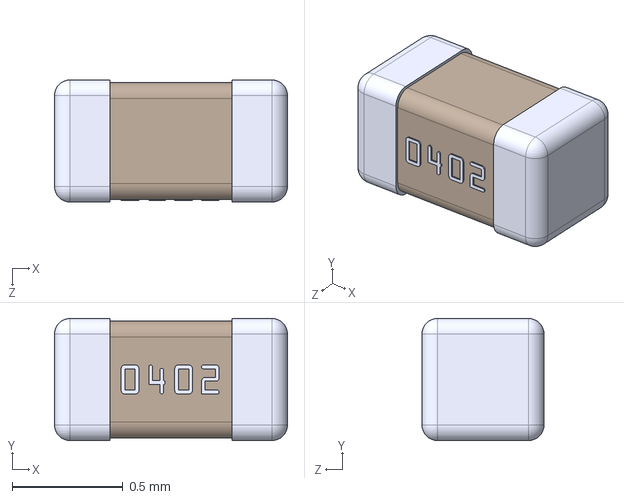
[picture p55: CAD file, 2026-01-05]
kiCad-solids/Capacitors/C-0402-1005.step
1.05 x 0.55 x 0.55 mm
