Merophy/enzyme/kiCad-solids/Connectors/Header_female_2x5_1.27mm_SMD.step

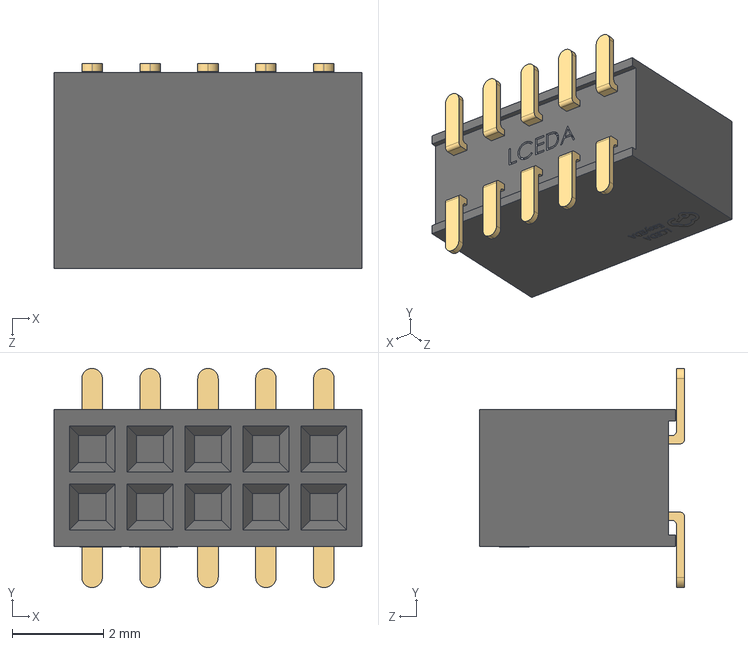
[picture p56: CAD file, 2026-10-07]
kiCad-solids/Connectors/Header_female_2x5_1.27mm_SMD.step
6.75 x 4.80 x 4.50 mm
