Merophy/enzyme/kiCad-solids/Diodes/LED-1206_btm.step

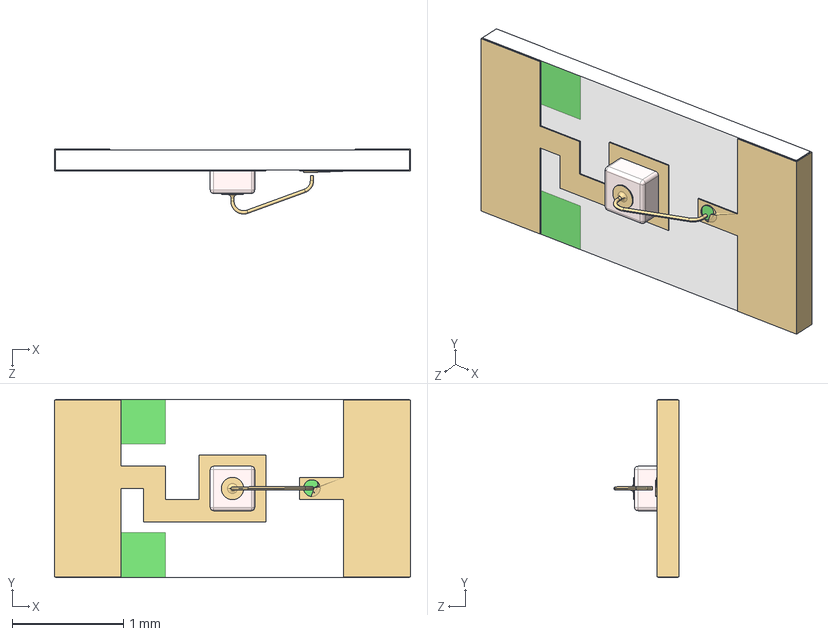
[picture p57: CAD file, 2024-12-12]
kiCad-solids/Diodes/LED-1206_btm.step
3.20 x 1.60 x 0.585 mm
