Merophy/enzyme/kiCad-solids/DualFlat/PDFN-8_3.3x3.3mm.step

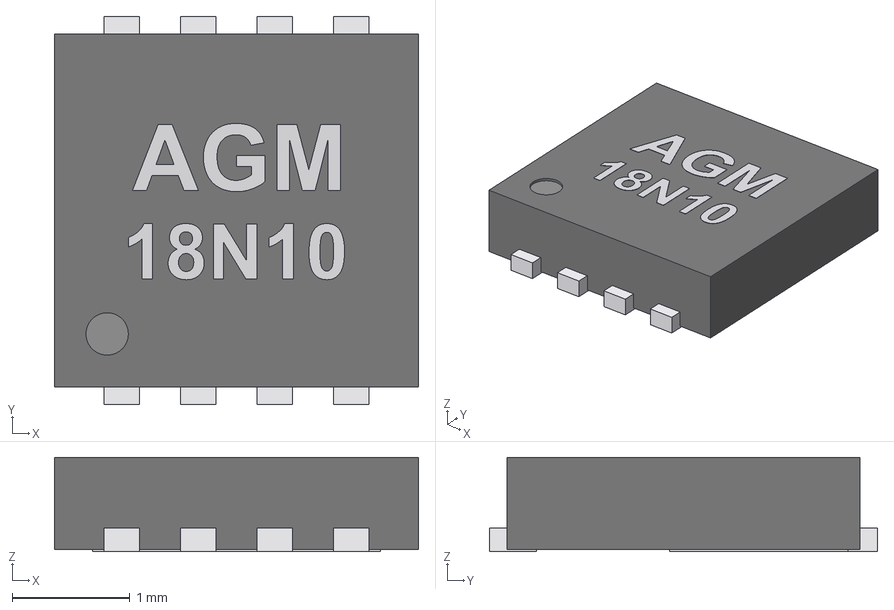
[picture p58: CAD file, 2026-10-13]
kiCad-solids/DualFlat/PDFN-8_3.3x3.3mm.step
3.10 x 3.30 x 0.803 mm
Balls
Pin1
Marking
