Merophy/enzyme/kiCad-solids/Electromechanic/Tactile_4x4.step

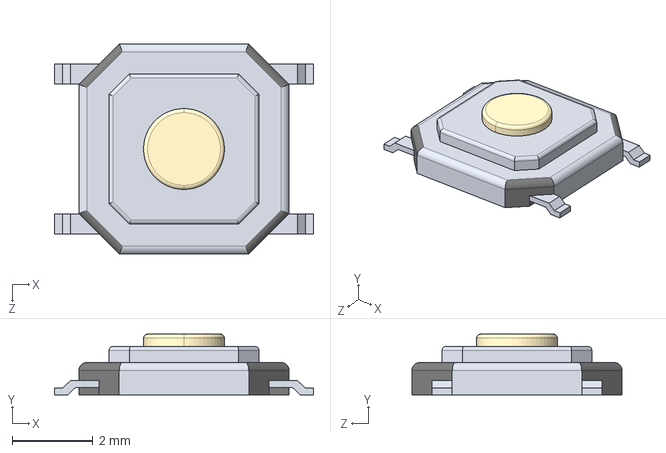
[picture p59: CAD file, 2022-08-27]
kiCad-solids/Electromechanic/Tactile_4x4.step
6.40 x 1.50 x 5.20 mm
