Merophy/enzyme/kiCad-solids/Inductors/L-5.4x5.2x2.8mm.step

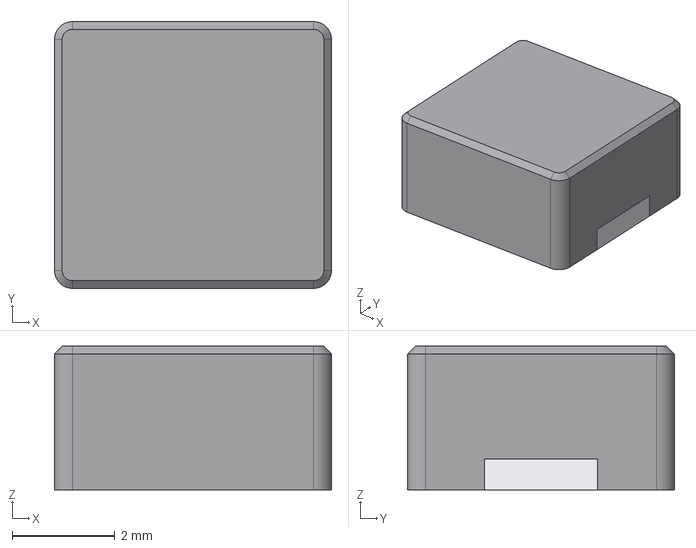
[picture p60: CAD file, 2026-10-16]
kiCad-solids/Inductors/L-5.4x5.2x2.8mm.step
5.40 x 5.20 x 2.80 mm
Powder
Leads
