Merophy/enzyme/kiCad-solids/Mechanic/M3 x 0.5mm Thread 12mm.STEP

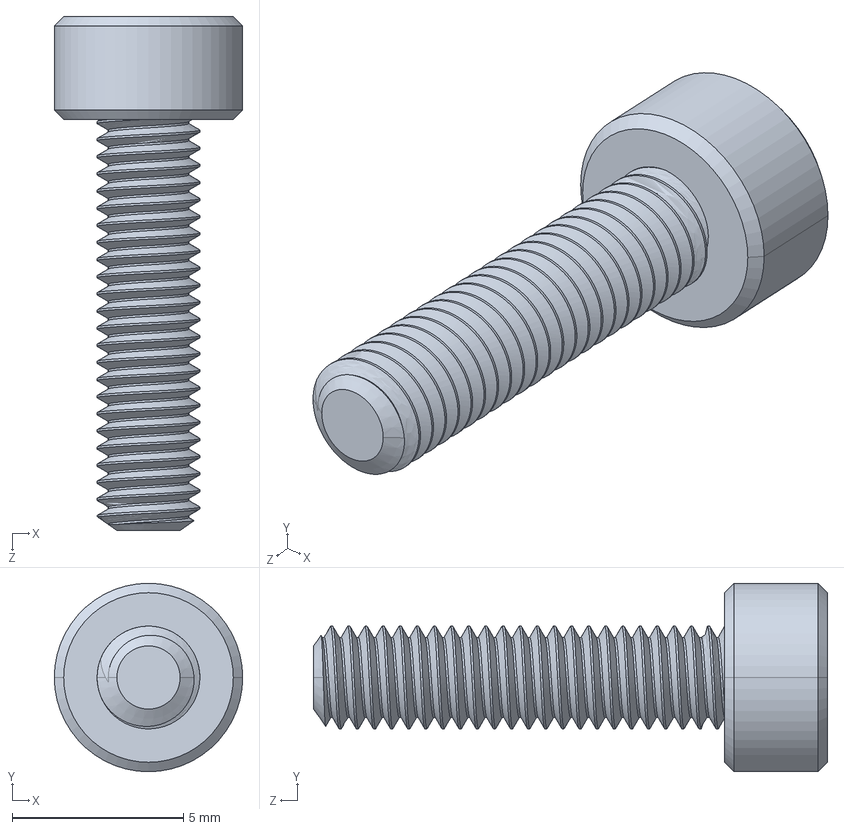
[picture p61: CAD file, 2025-01-31]
kiCad-solids/Mechanic/M3 x 0.5mm Thread 12mm.STEP
5.50 x 5.50 x 15.0 mm
