Merophy/enzyme/kiCad-solids/Modules/Same_Sky_CPE-420.step

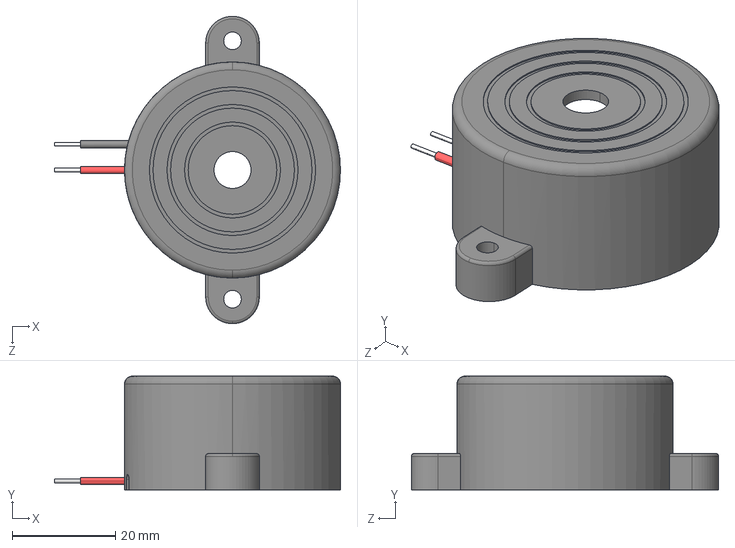
[picture p62: CAD file, 2025-01-31]
kiCad-solids/Modules/Same_Sky_CPE-420.step
55.4 x 22.0 x 59.5 mm
