Merophy/enzyme/kiCad-solids/QuadFlat/QFN-32-EP_5x5mm.step

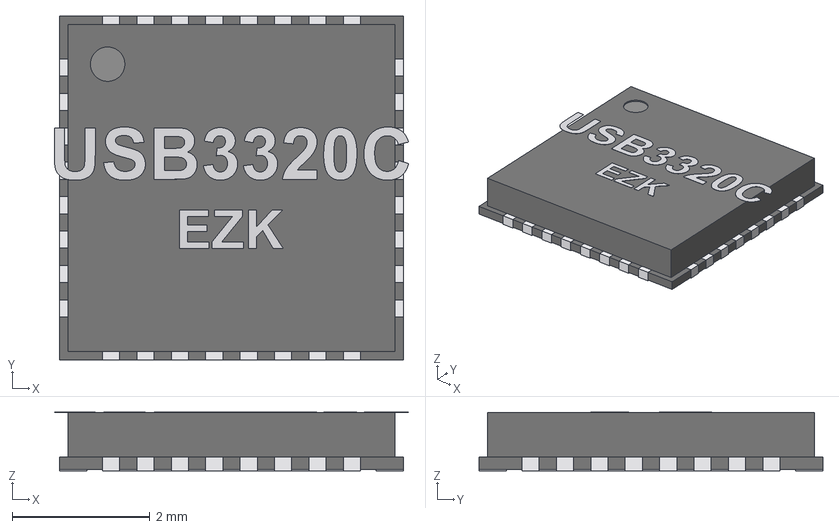
[picture p63: CAD file, 2026-10-09]
kiCad-solids/QuadFlat/QFN-32-EP_5x5mm.step
5.15 x 5.00 x 0.853 mm
Balls
Pin1
Marking
