Merophy/enzyme/kiCad-solids/Resistors/R-15-7.6mm.step

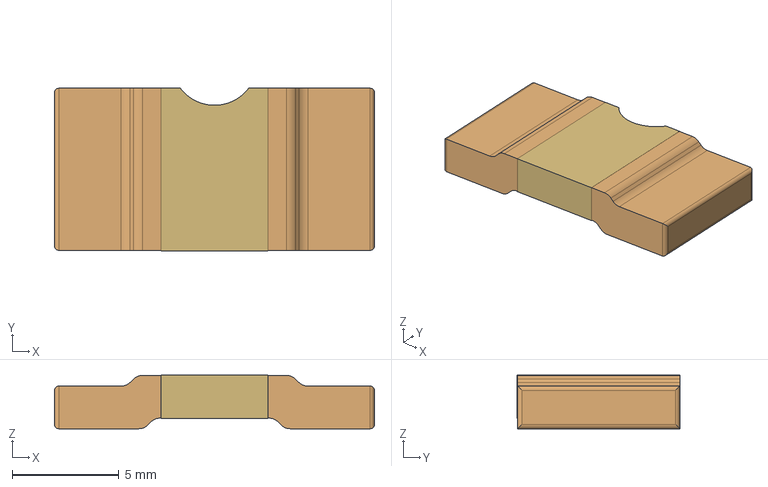
[picture p64: CAD file, 2023-10-01]
kiCad-solids/Resistors/R-15-7.6mm.step
15.0 x 7.62 x 2.51 mm
