Merophy/enzyme/kiCad-solids/SmallOutline/WSON8-8x6.step

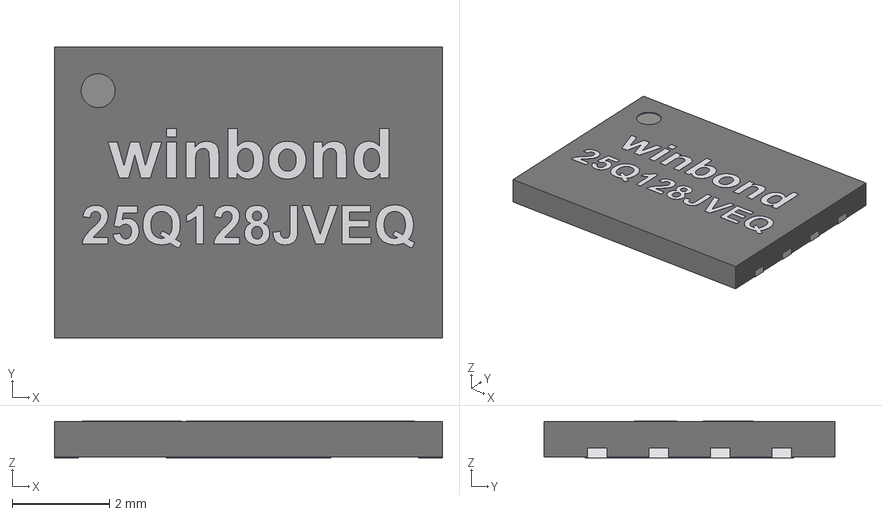
[picture p65: CAD file, 2026-10-08]
kiCad-solids/SmallOutline/WSON8-8x6.step
8.00 x 6.00 x 0.753 mm
Balls
Pin1
Marking
