Merophy/enzyme/kiCad-solids/Capacitors/C-1206-3216.step

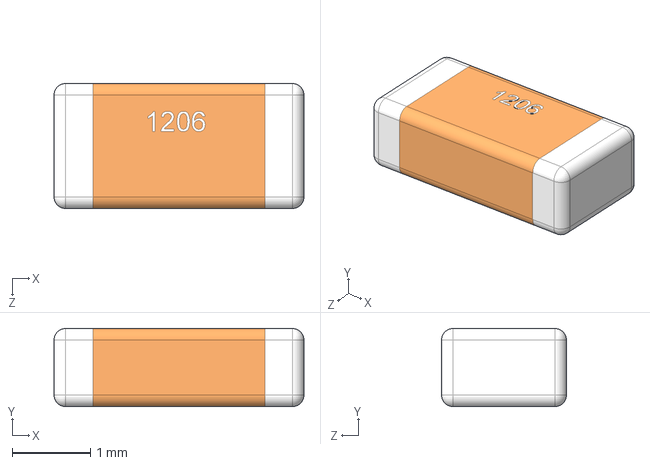
[picture p66: CAD file, 2026-01-05]
kiCad-solids/Capacitors/C-1206-3216.step
3.20 x 1.00 x 1.60 mm
