Merophy/enzyme/kiCad-solids/Connectors/Header_female_2x4_1.27mm_SMD.step

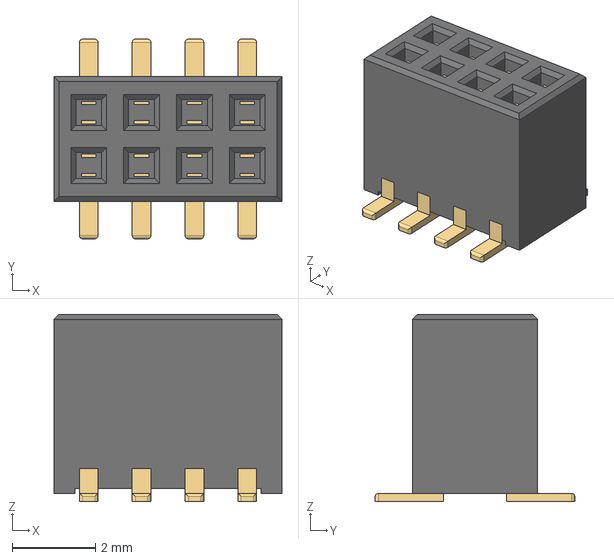
[picture p67: CAD file, 2026-10-07]
kiCad-solids/Connectors/Header_female_2x4_1.27mm_SMD.step
5.48 x 4.80 x 4.50 mm
Gold
