Merophy/enzyme/kiCad-solids/Diodes/LED-1206_top_R.step

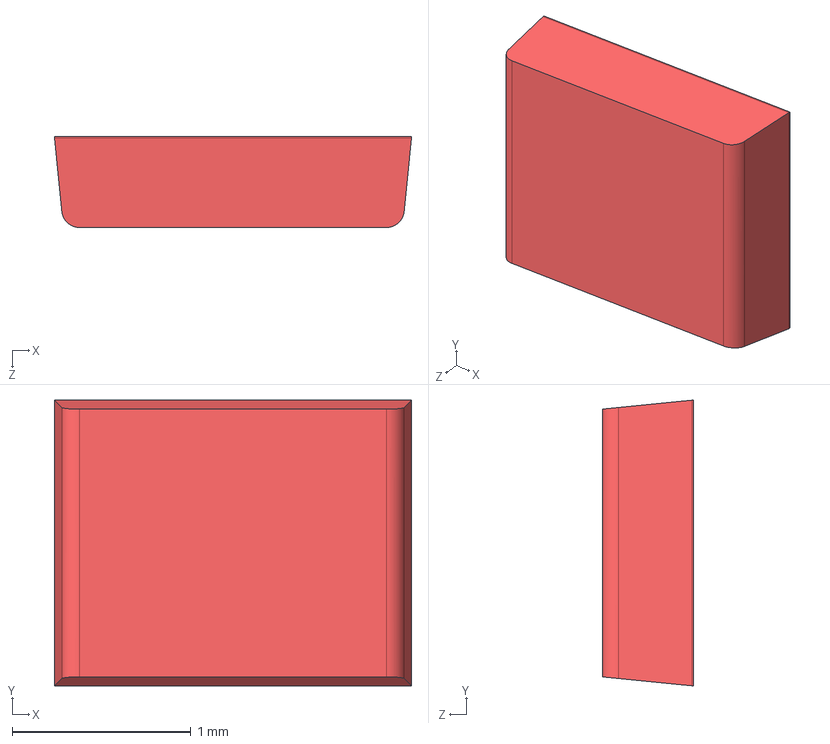
[picture p68: CAD file, 2024-12-12]
kiCad-solids/Diodes/LED-1206_top_R.step
2.00 x 1.60 x 0.51 mm
