Merophy/enzyme/kiCad-solids/DualFlat/VSON-8-EP_3x3mm_DRB.step

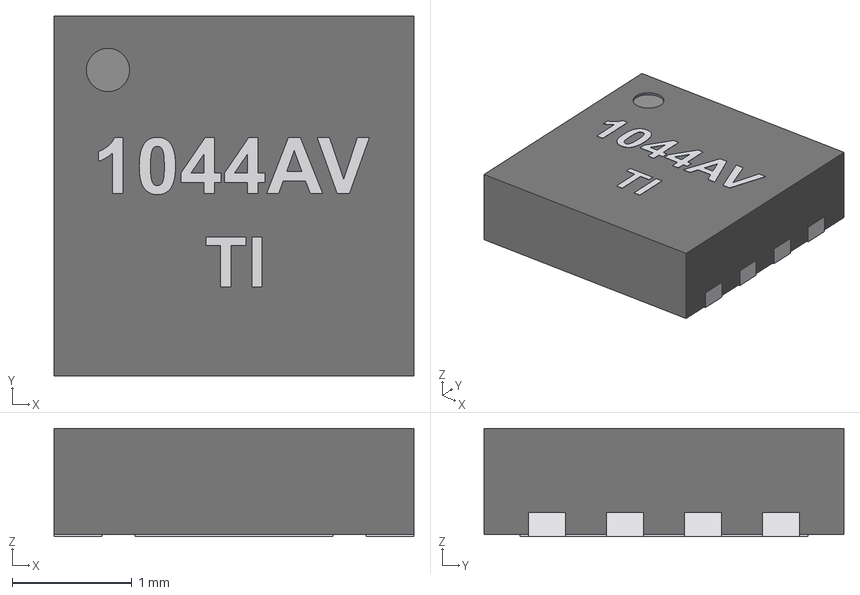
[picture p69: CAD file, 2026-10-09]
kiCad-solids/DualFlat/VSON-8-EP_3x3mm_DRB.step
3.00 x 3.00 x 0.903 mm
Balls
Pin1
Marking
