Merophy/enzyme/kiCad-solids/Inductors/L-7.0x6.6x2.8mm.step

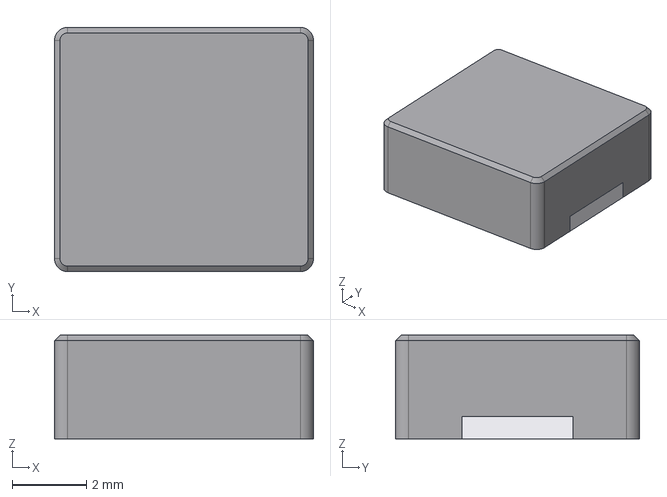
[picture p70: CAD file, 2026-10-16]
kiCad-solids/Inductors/L-7.0x6.6x2.8mm.step
7.00 x 6.60 x 2.80 mm
Powder
Leads
