Merophy/enzyme/kiCad-solids/Mechanic/M3 x 0.5mm Thread 5mm.STEP

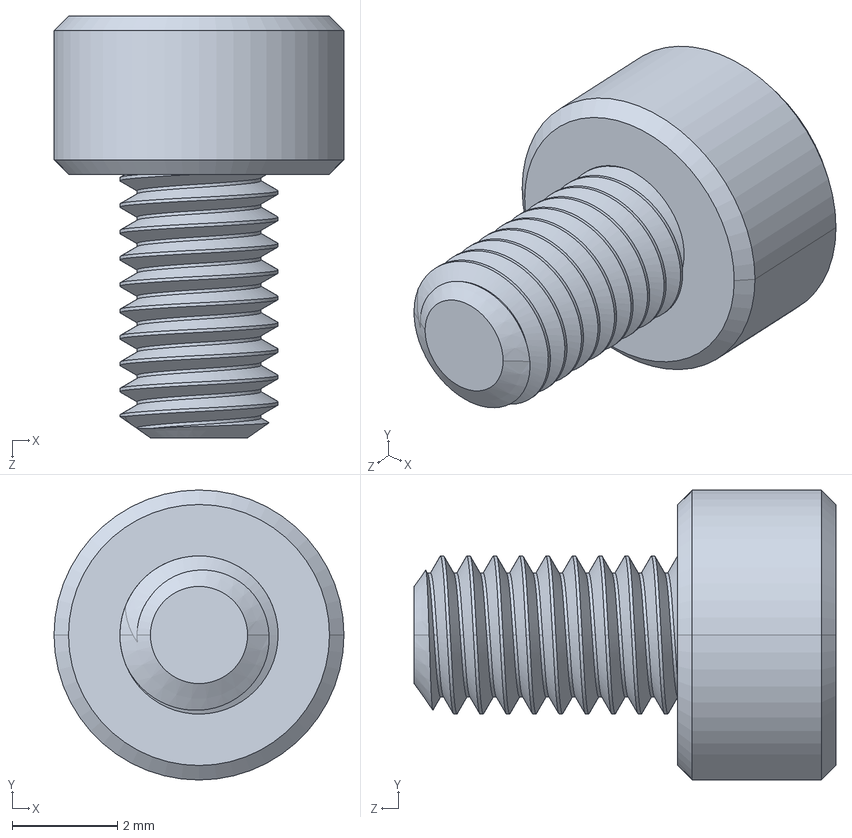
[picture p71: CAD file, 2025-01-16]
kiCad-solids/Mechanic/M3 x 0.5mm Thread 5mm.STEP
5.50 x 5.50 x 8.00 mm
