Merophy/enzyme/kiCad-solids/Modules/ZED-F9P.step

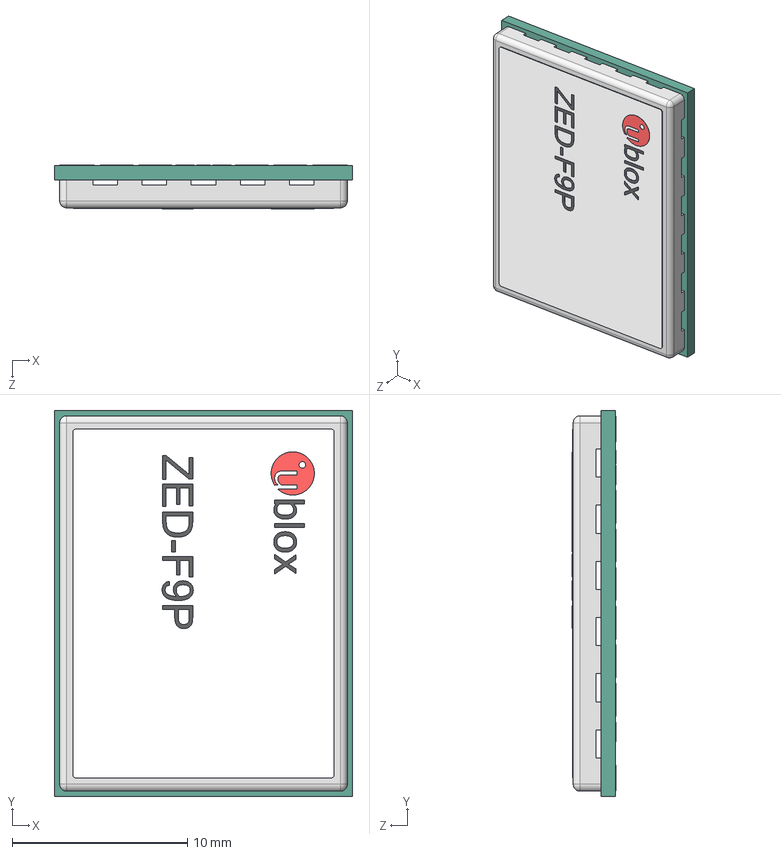
[picture p72: CAD file, 2022-10-01]
kiCad-solids/Modules/ZED-F9P.step
17.0 x 22.0 x 2.50 mm
Imported
Imported_2
Imported_3
Imported_4
Imported_5
Imported_6
