Merophy/enzyme/kiCad-solids/QuadFlat/QFN-48-EP_7x7mm.step

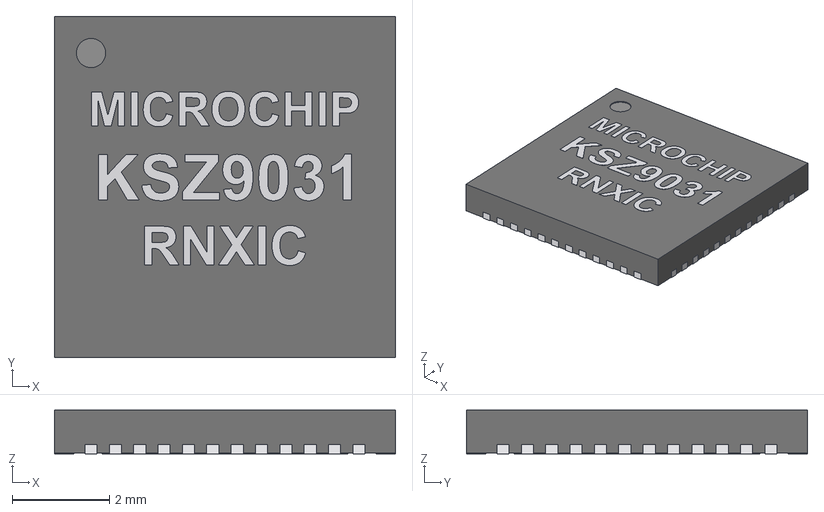
[picture p73: CAD file, 2026-10-09]
kiCad-solids/QuadFlat/QFN-48-EP_7x7mm.step
7.00 x 7.00 x 0.903 mm
Balls
Pin1
Marking
