Merophy/enzyme/kiCad-solids/Resistors/R-1206-3216.step

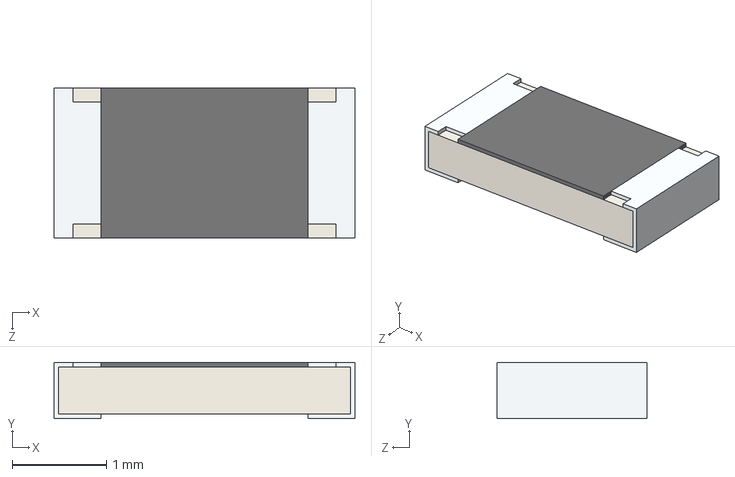
[picture p74: CAD file, 2022-03-01]
kiCad-solids/Resistors/R-1206-3216.step
3.20 x 0.6 x 1.60 mm
