Merophy/enzyme/kiCad-solids/SmallOutline/SOT-23-THIN-8_DDF.step

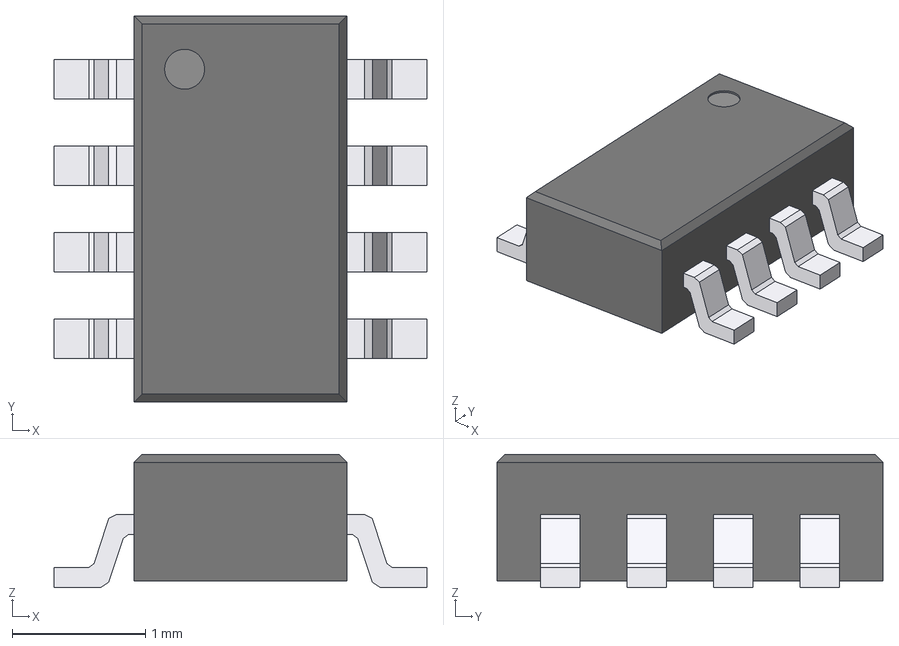
[picture p75: CAD file, 2026-10-08]
kiCad-solids/SmallOutline/SOT-23-THIN-8_DDF.step
2.80 x 2.90 x 1.00 mm
Leads
Pin1
