Merophy/enzyme/kiCad-solids/Capacitors/CP-d8-p3.50.step

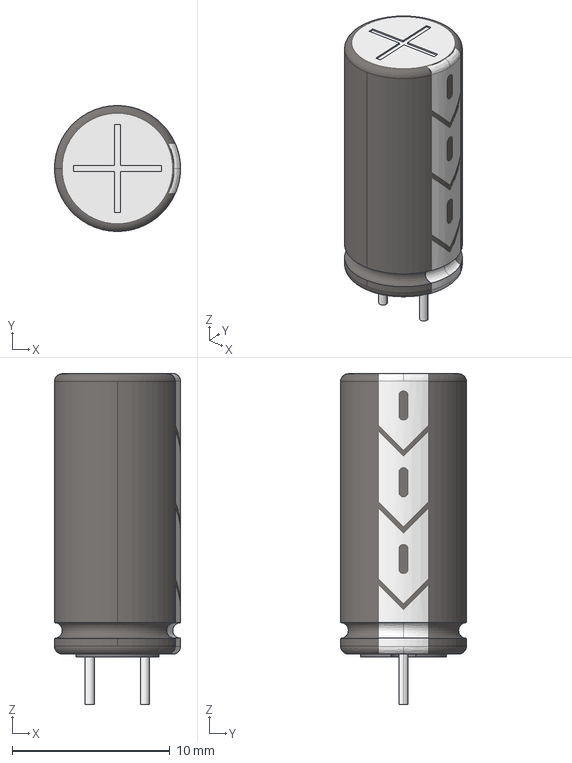
[picture p76: CAD file, 2025-04-20]
kiCad-solids/Capacitors/CP-d8-p3.50.step
8.01 x 8.00 x 21.0 mm
