Merophy/enzyme/kiCad-solids/Connectors/Header_male_2x5_1.27mm_SMD.step

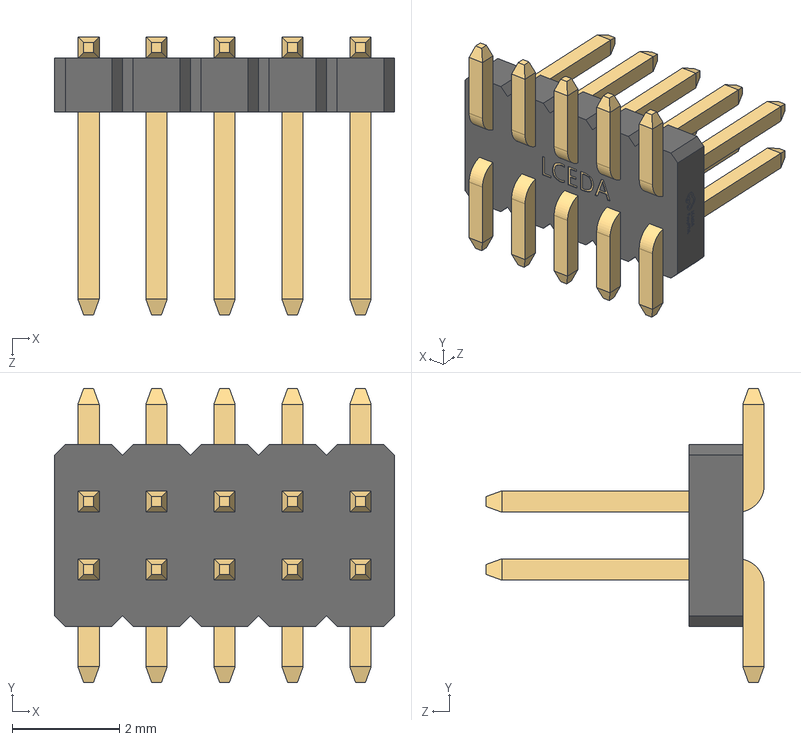
[picture p77: CAD file, 2026-10-06]
kiCad-solids/Connectors/Header_male_2x5_1.27mm_SMD.step
6.35 x 5.50 x 5.20 mm
