Merophy/enzyme/kiCad-solids/Diodes/LED-0805-2512.step

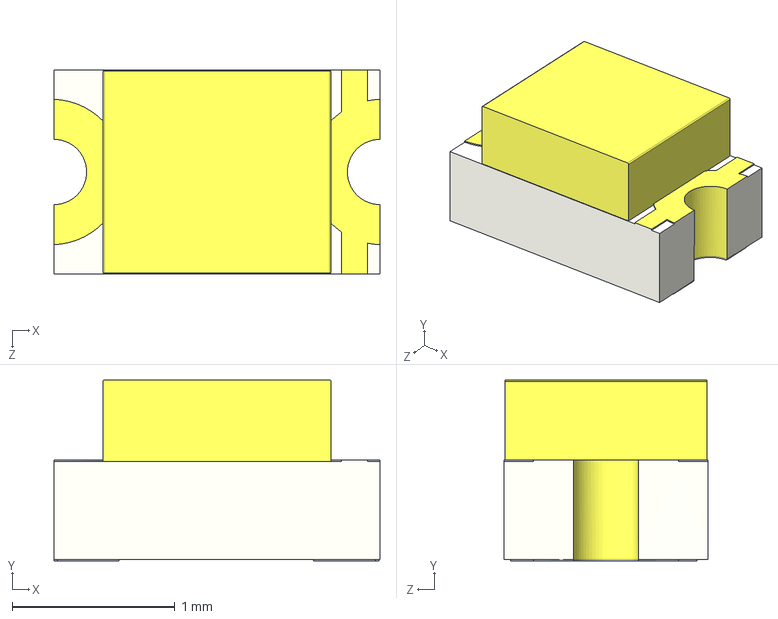
[picture p78: CAD file, 2022-12-30]
kiCad-solids/Diodes/LED-0805-2512.step
2.00 x 1.11 x 1.25 mm
