Merophy/enzyme/kiCad-solids/DualFlat/DFN-8.step

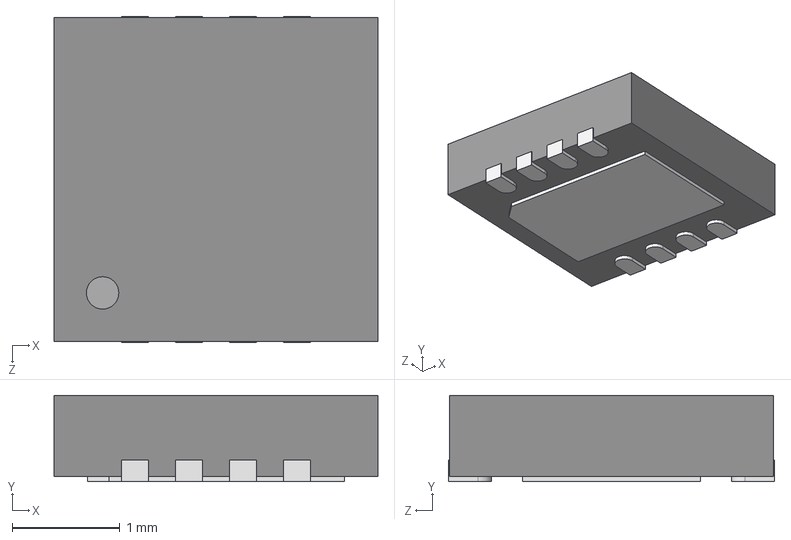
[picture p79: CAD file, 2025-03-25]
kiCad-solids/DualFlat/DFN-8.step
3.00 x 0.8 x 3.02 mm
