Merophy/enzyme/kiCad-solids/Inductors/L-0603.step

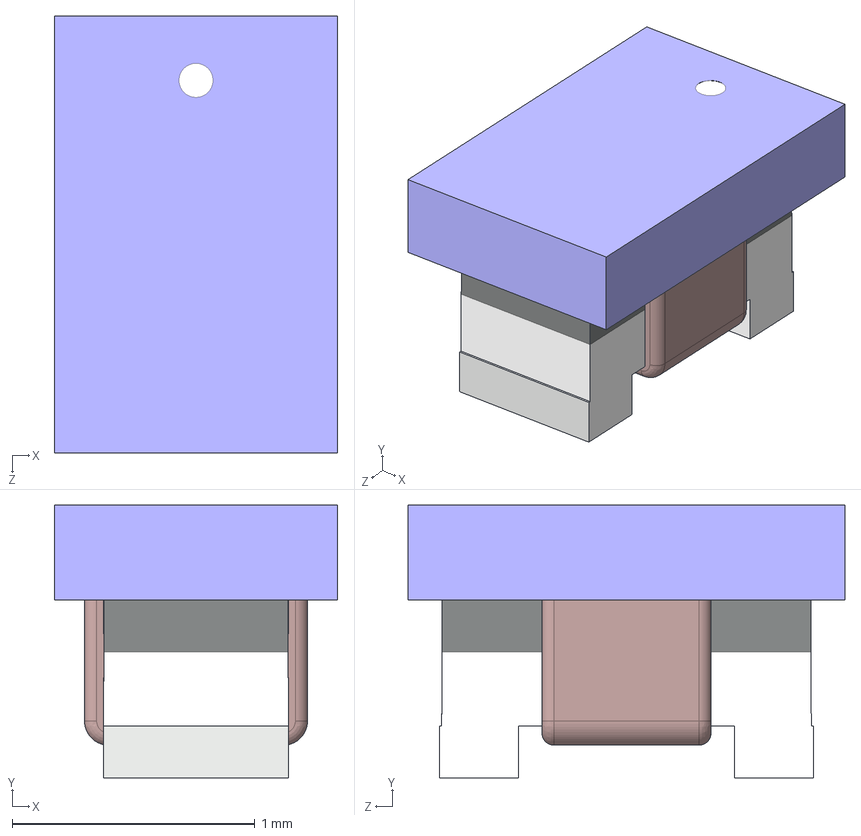
[picture p80: CAD file, 2022-10-01]
kiCad-solids/Inductors/L-0603.step
1.17 x 1.12 x 1.80 mm
