Merophy/enzyme/kiCad-solids/QuadFlat/RVR0019A.stp

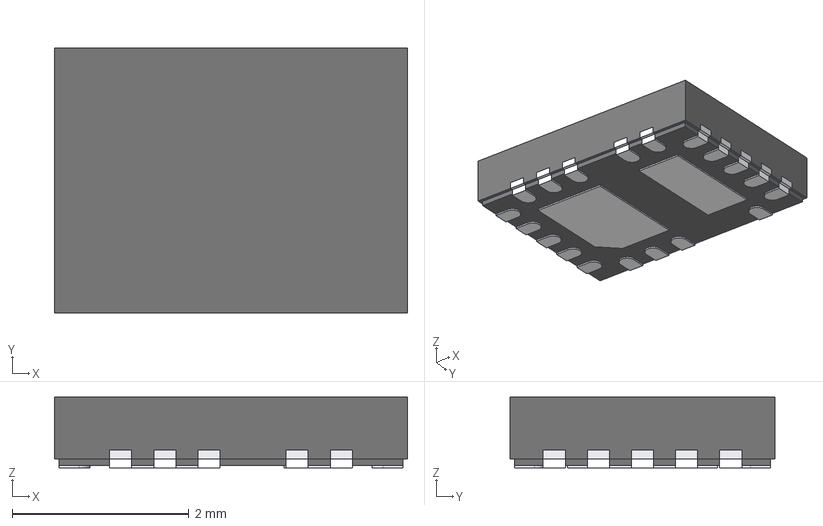
[picture p81: CAD file, 2026-09-24]
kiCad-solids/QuadFlat/RVR0019A.stp
4.00 x 3.00 x 0.8 mm
BODY-QFN_AF0
FRAME-RVR0019A_AF0
PIN1-ID
