Merophy/enzyme/kiCad-solids/SmallOutline/MSE16-12.step

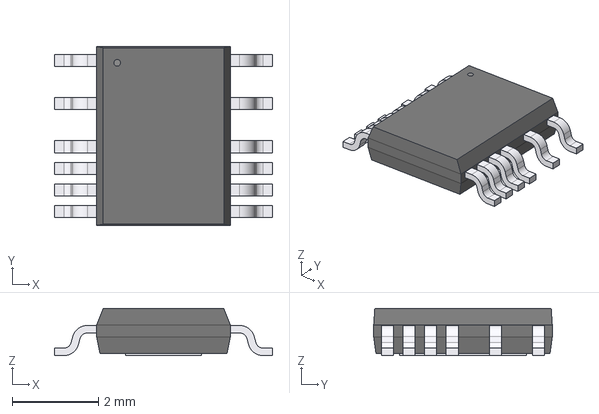
[picture p82: CAD file, 2026-10-07]
kiCad-solids/SmallOutline/MSE16-12.step
5.05 x 4.14 x 1.09 mm
