Merophy/enzyme/kiCad-solids/Capacitors/C-0603-1608.step

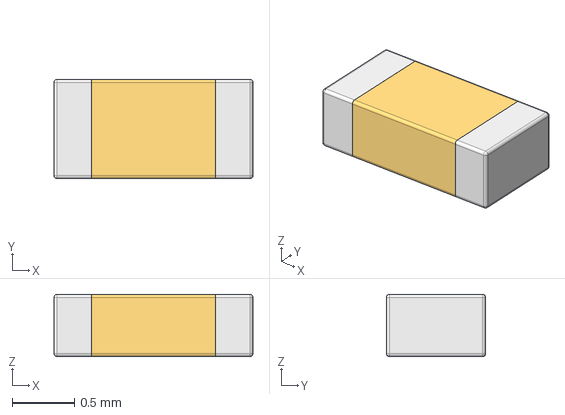
[picture p83: CAD file, 2022-10-01]
kiCad-solids/Capacitors/C-0603-1608.step
1.60 x 0.8 x 0.5 mm
