Merophy/enzyme/kiCad-solids/Connectors/SMTSO42100.step

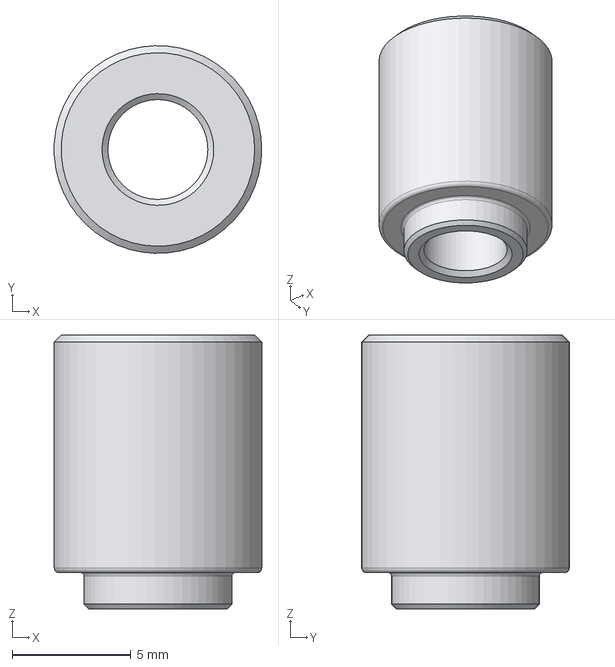
[picture p84: CAD file, 2026-09-24]
kiCad-solids/Connectors/SMTSO42100.step
8.73 x 8.74 x 11.5 mm
