Merophy/enzyme/kiCad-solids/Diodes/SOD-128.step

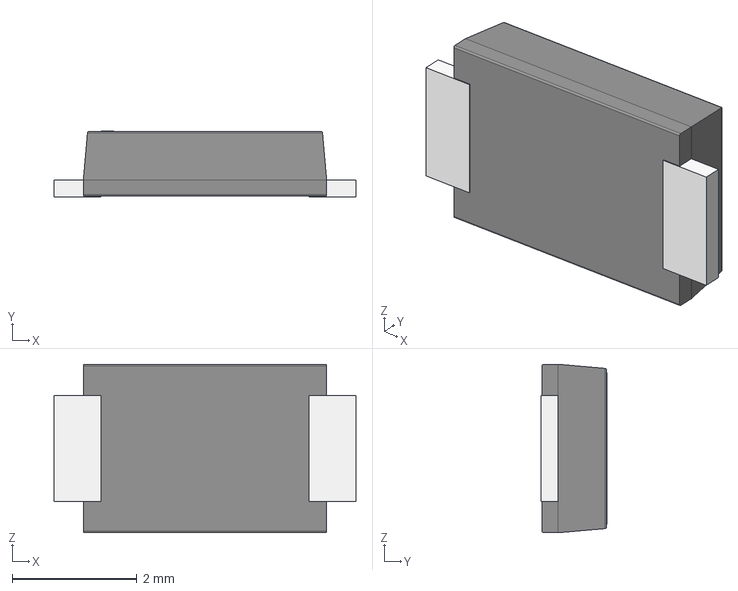
[picture p85: CAD file, 2022-10-01]
kiCad-solids/Diodes/SOD-128.step
4.84 x 1.05 x 2.70 mm
