Merophy/enzyme/kiCad-solids/Inductors/L-0402.step

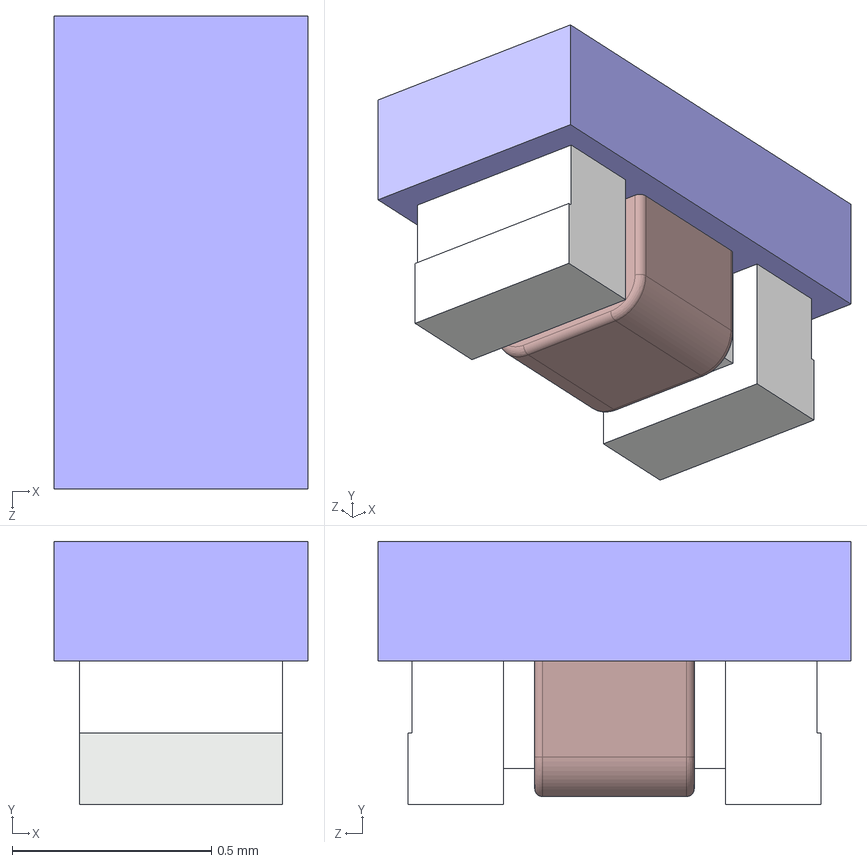
[picture p86: CAD file, 2022-10-01]
kiCad-solids/Inductors/L-0402.step
0.636 x 0.66 x 1.19 mm
