Merophy/enzyme/kiCad-solids/QuadFlat/RHL0024A.stp

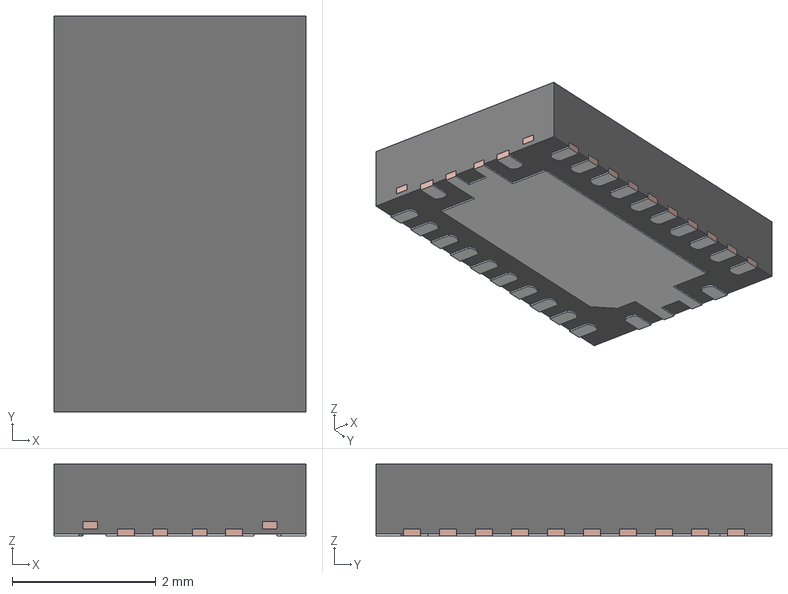
[picture p87: CAD file, 2026-01-16]
kiCad-solids/QuadFlat/RHL0024A.stp
3.50 x 5.50 x 1.00 mm
FRAME
MOLD
