Merophy/enzyme/kiCad-solids/SmallOutline/TSON-6.step

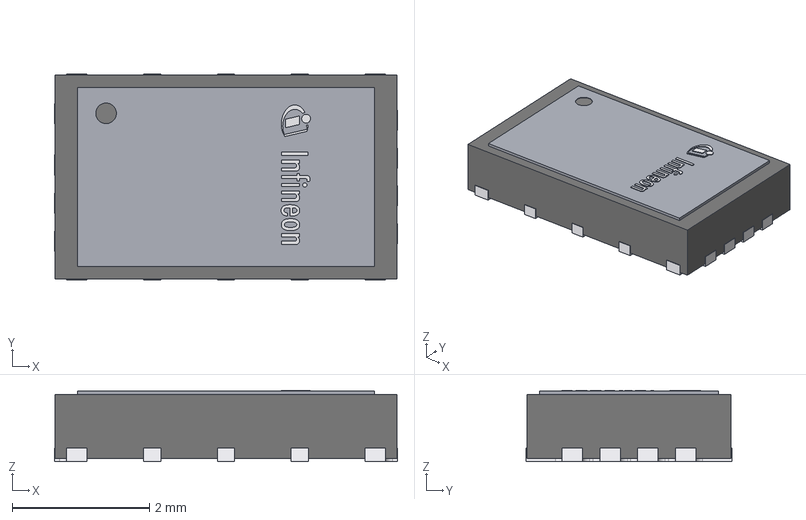
[picture p88: CAD file, 2026-09-24]
kiCad-solids/SmallOutline/TSON-6.step
5.00 x 3.00 x 1.04 mm
