Merophy/enzyme/kiCad-solids/Diodes/LED-0603-1608.step

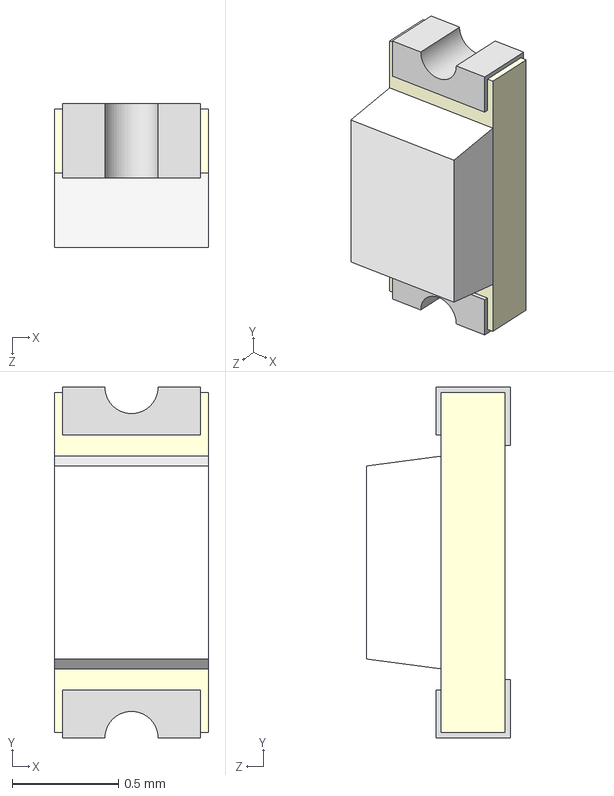
[picture p89: CAD file, 2022-03-01]
kiCad-solids/Diodes/LED-0603-1608.step
0.725 x 1.65 x 0.675 mm
