Merophy/enzyme/kiCad-solids/Inductors/L-13.5x12.5x6.4mm.step

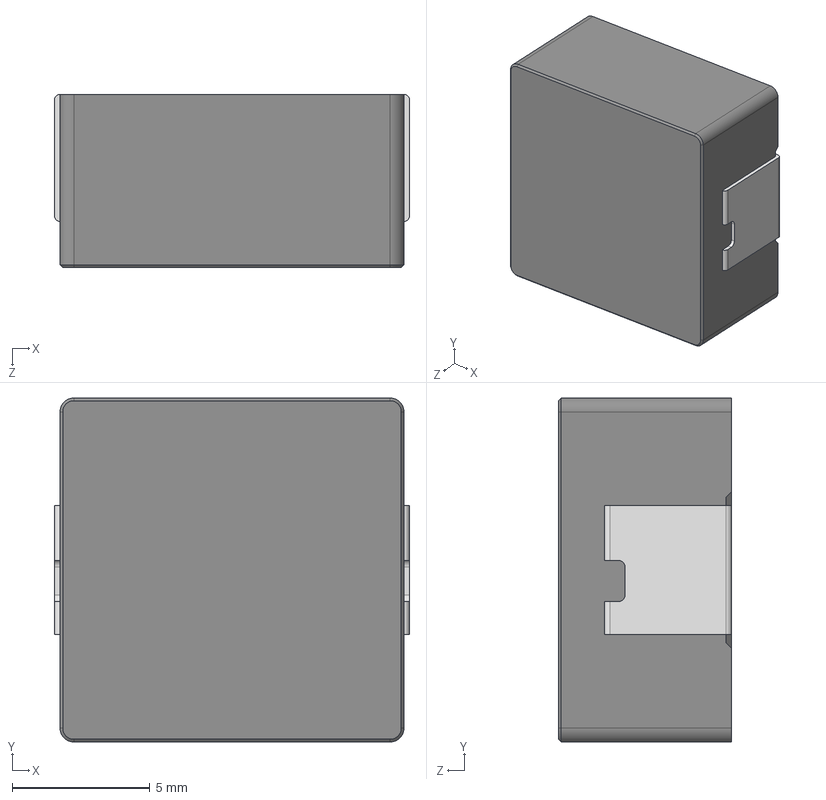
[picture p90: CAD file, 2022-03-06]
kiCad-solids/Inductors/L-13.5x12.5x6.4mm.step
12.9 x 12.5 x 6.30 mm
