Merophy/enzyme/kiCad-solids/QuadFlat/RTE0016C.stp

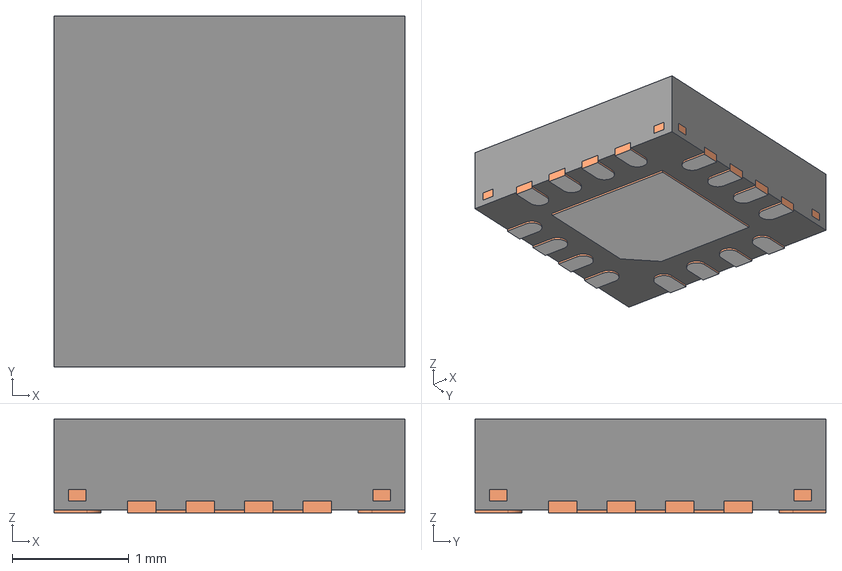
[picture p91: CAD file, 2026-01-16]
kiCad-solids/QuadFlat/RTE0016C.stp
3.00 x 3.00 x 0.8 mm
BODY-QFN
FRAME-RTE0016C
PIN1-ID
