Merophy/enzyme/kiCad-solids/SmallOutline/SOT-89.step

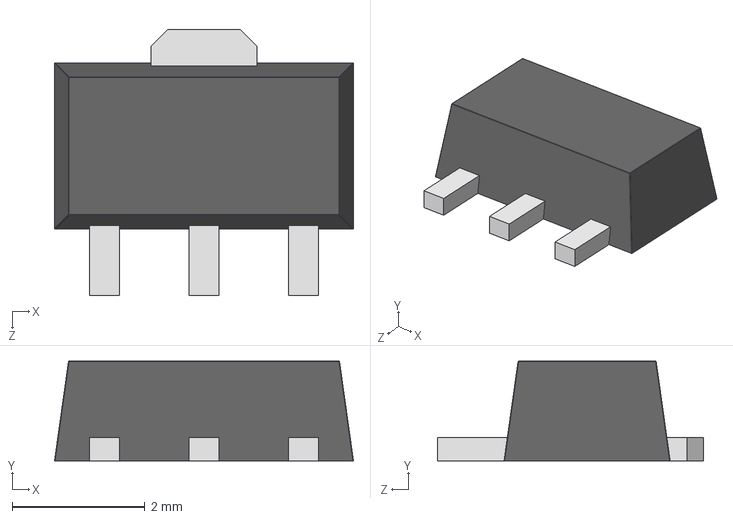
[picture p92: CAD file, 2025-03-25]
kiCad-solids/SmallOutline/SOT-89.step
4.50 x 1.50 x 4.00 mm
