Merophy/enzyme/kiCad-solids/Connectors/SM08B-GHS-TB.stp

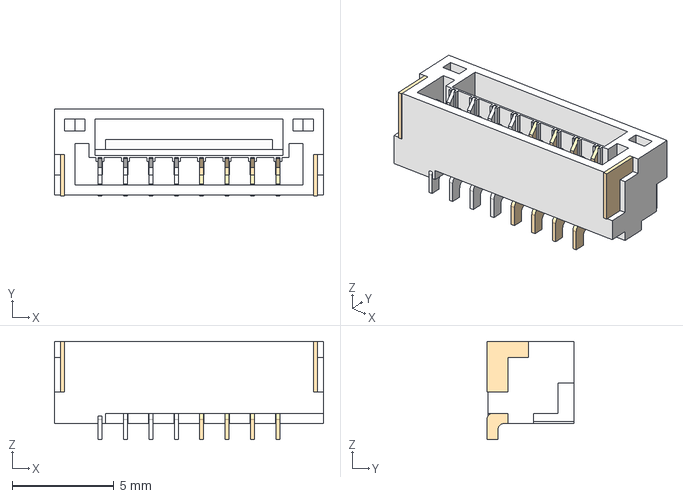
[picture p93: CAD file, 2026-01-16]
kiCad-solids/Connectors/SM08B-GHS-TB.stp
13.2 x 4.30 x 4.85 mm
