Merophy/enzyme/kiCad-solids/QuadFlat/QFN-32.STEP

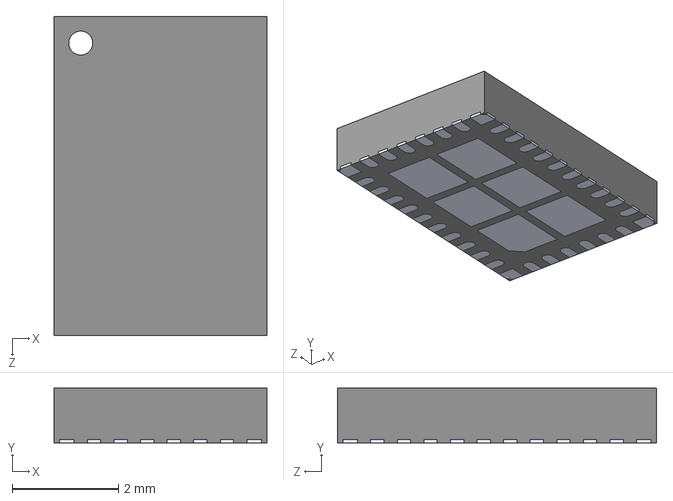
[picture p94: CAD file, 2026-01-16]
kiCad-solids/QuadFlat/QFN-32.STEP
4.00 x 1.03 x 6.00 mm
