Merophy/enzyme/kiCad-solids/SmallOutline/TDSON-8.step

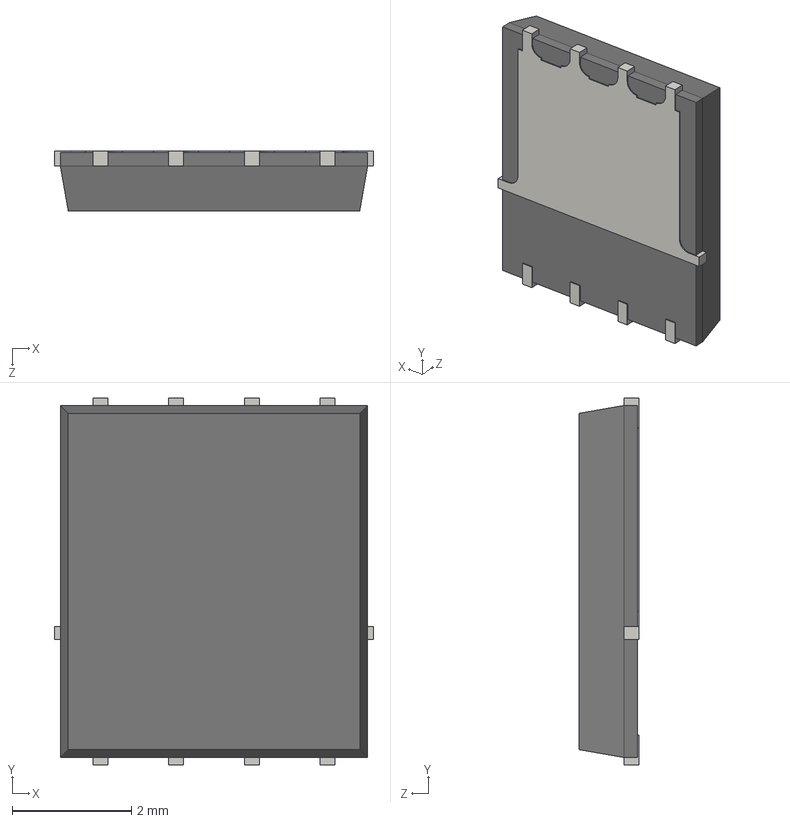
[picture p95: CAD file, 2025-03-25]
kiCad-solids/SmallOutline/TDSON-8.step
5.35 x 6.15 x 1.00 mm
