Merophy/enzyme/kiCad-solids/Connectors/SM09B-GHS-TB.stp

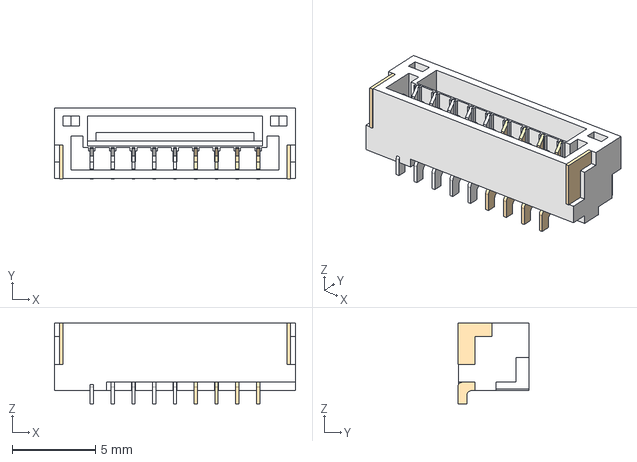
[picture p96: CAD file, 2026-01-16]
kiCad-solids/Connectors/SM09B-GHS-TB.stp
14.5 x 4.30 x 4.85 mm
