Merophy/enzyme/kiCad-solids/QuadFlat/QFN-16.step

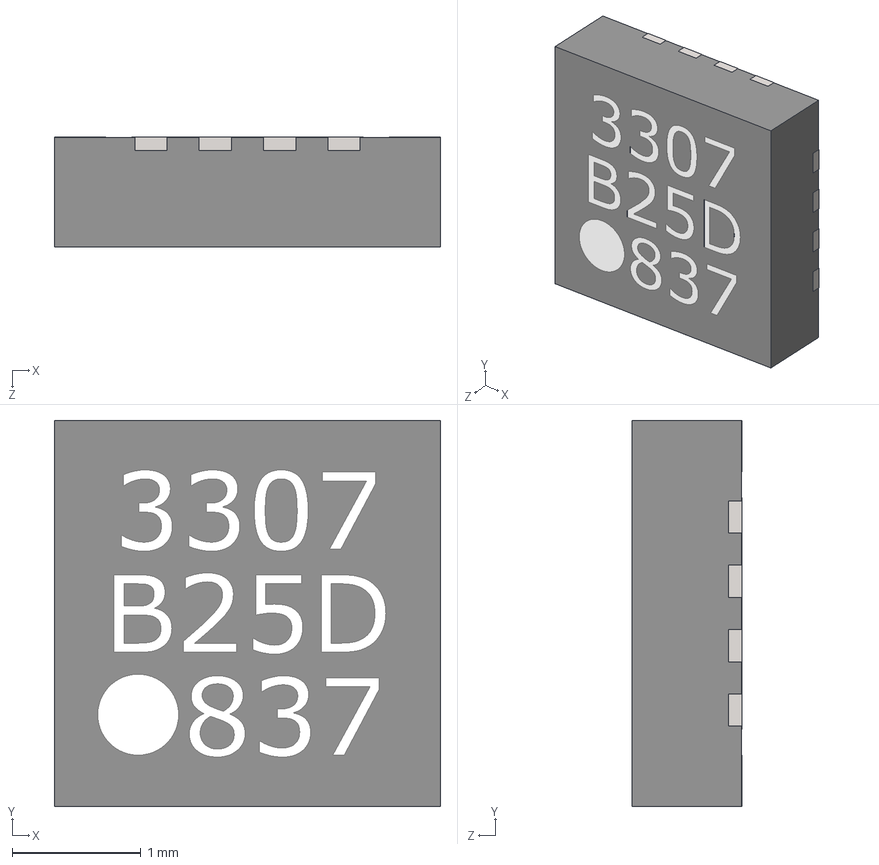
[picture p97: CAD file, 2022-08-27]
kiCad-solids/QuadFlat/QFN-16.step
3.00 x 3.00 x 0.855 mm
