Merophy/enzyme/kiCad-solids/SmallOutline/R-PDSO-G8.step

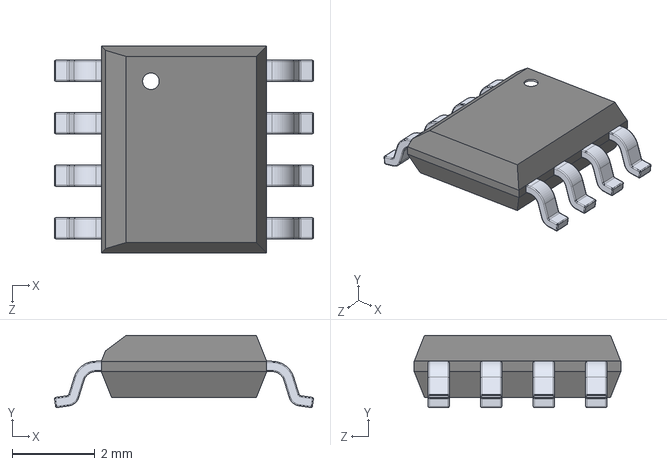
[picture p98: CAD file, 2023-10-01]
kiCad-solids/SmallOutline/R-PDSO-G8.step
6.26 x 1.75 x 5.00 mm
