Merophy/enzyme/kiCad-solids/SmallOutline/SOT-23-6.step

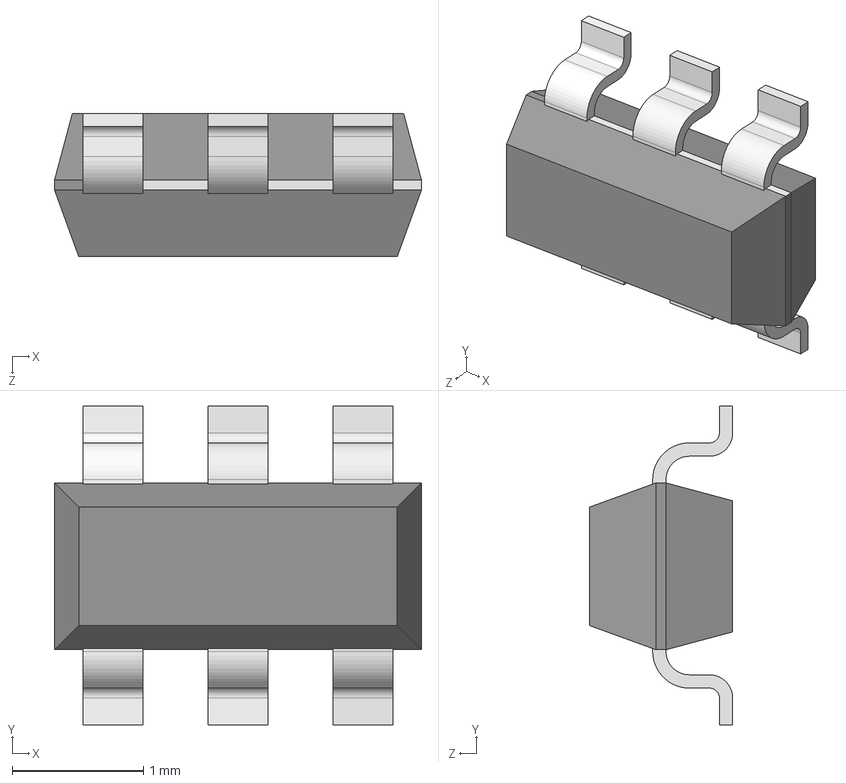
[picture p100: CAD file, 2022-10-01]
kiCad-solids/SmallOutline/SOT-23-6.step
2.79 x 2.43 x 1.09 mm
