Merophy/enzyme/kiCad-solids/Connectors/SM04B-GHS-TB.stp

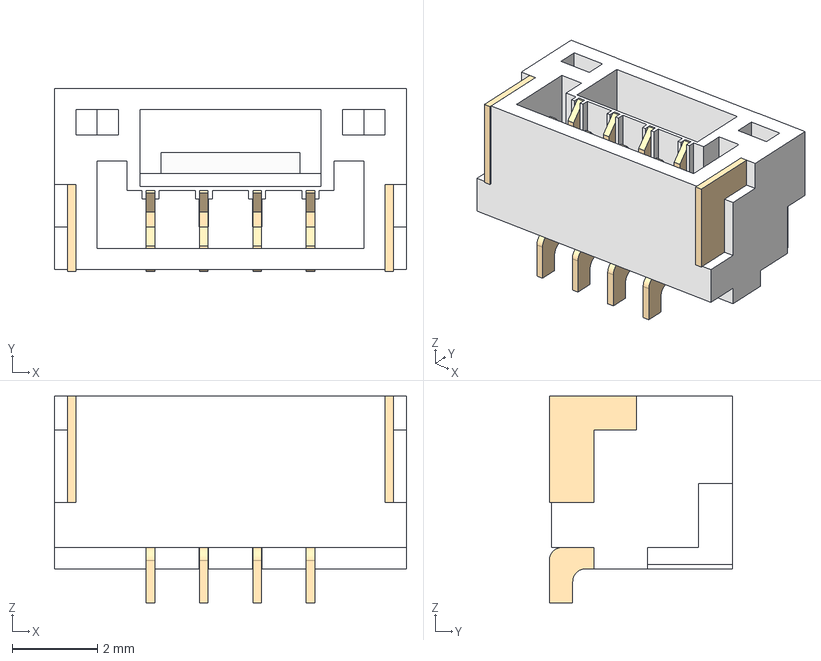
[picture p101: CAD file, 2026-01-16]
kiCad-solids/Connectors/SM04B-GHS-TB.stp
8.25 x 4.30 x 4.85 mm
