Merophy/enzyme/kiCad-solids/QuadFlat/RP2040_QFN.STEP

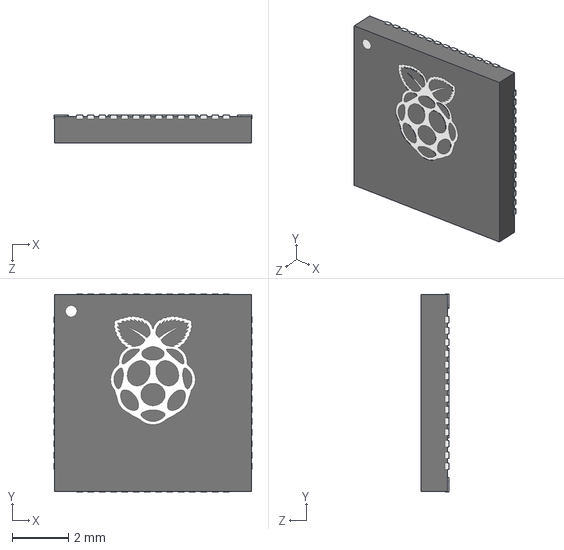
[picture p102: CAD file, 2022-08-24]
kiCad-solids/QuadFlat/RP2040_QFN.STEP
7.02 x 7.02 x 1.00 mm
