Merophy/enzyme/kiCad-solids/SmallOutline/VSSOP-8.step

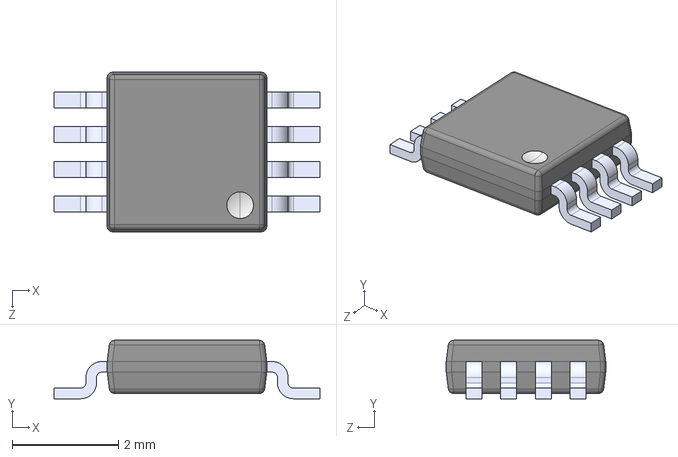
[picture p103: CAD file, 2022-10-01]
kiCad-solids/SmallOutline/VSSOP-8.step
5.00 x 1.10 x 3.00 mm
