Merophy/enzyme/kiCad-solids/Connectors/SM10B-GHS-TB.stp

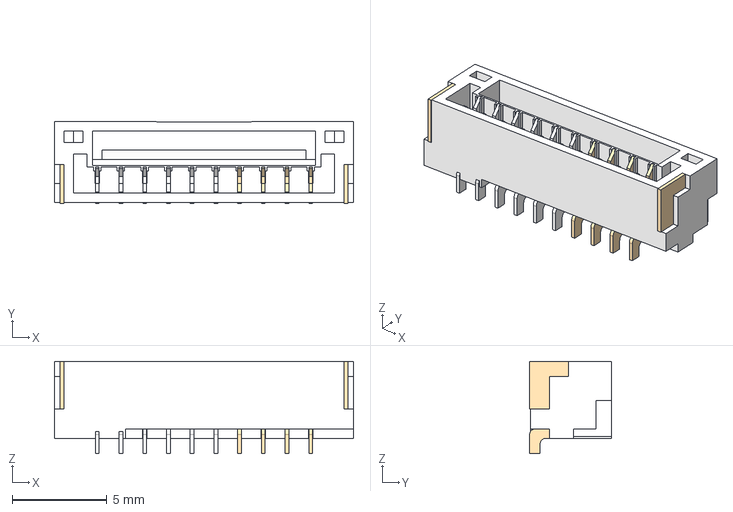
[picture p104: CAD file, 2026-01-16]
kiCad-solids/Connectors/SM10B-GHS-TB.stp
15.8 x 4.30 x 4.85 mm
