Merophy/enzyme/kiCad-solids/SmallOutline/WSON8-6x5.step

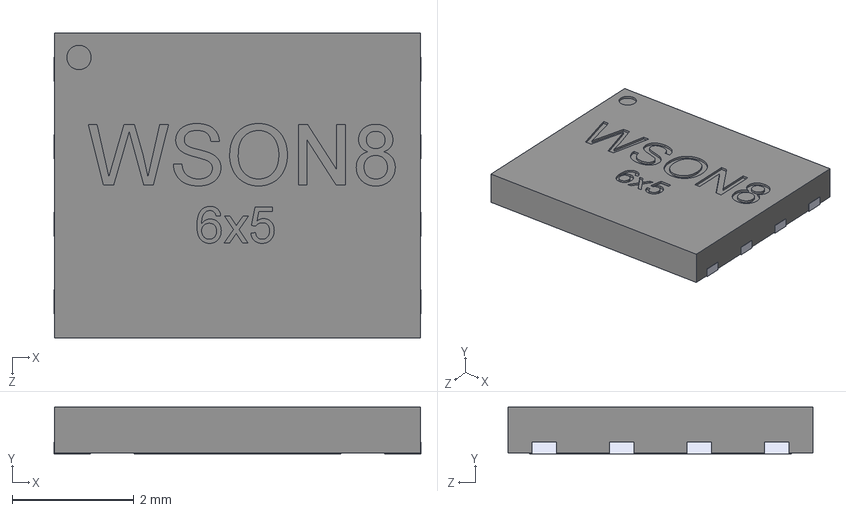
[picture p105: CAD file, 2022-08-27]
kiCad-solids/SmallOutline/WSON8-6x5.step
6.02 x 0.77 x 5.00 mm
