Merophy/enzyme/kiCad-solids/Connectors/SM12B-GHS-TB.stp

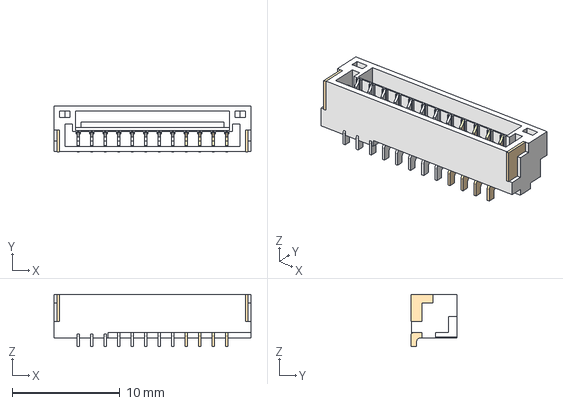
[picture p106: CAD file, 2026-01-16]
kiCad-solids/Connectors/SM12B-GHS-TB.stp
18.2 x 4.30 x 4.85 mm
