Merophy/enzyme/kiCad-solids/SmallOutline/SOT1205.step

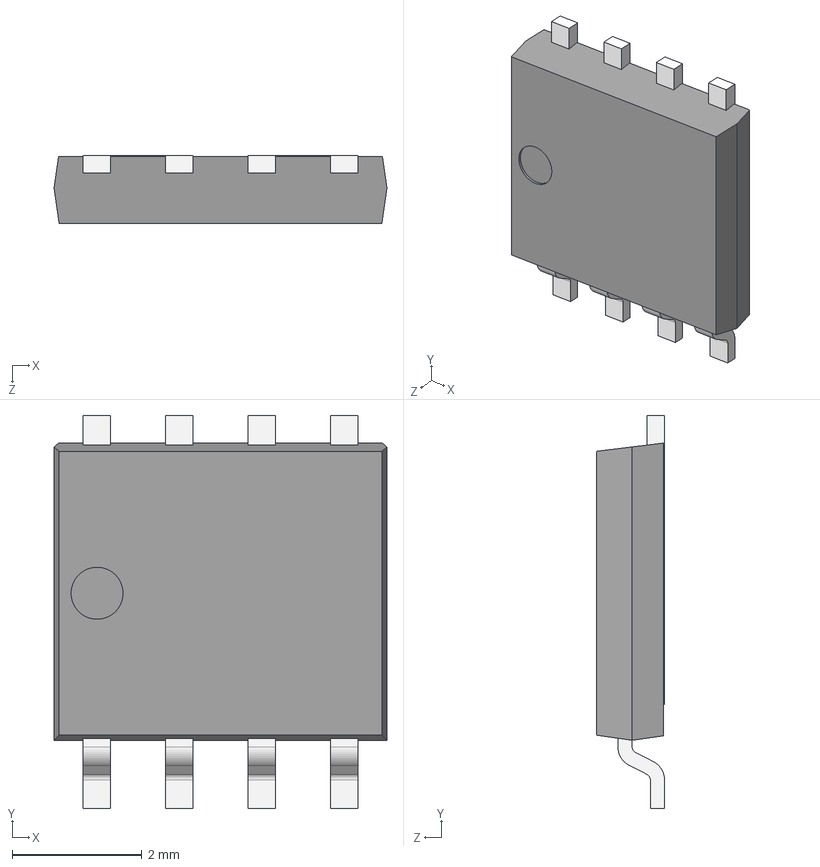
[picture p107: CAD file, 2022-03-06]
kiCad-solids/SmallOutline/SOT1205.step
5.12 x 6.05 x 1.05 mm
