Merophy/enzyme/kiCad-solids/Connectors/SM07B-GHS-TB.stp

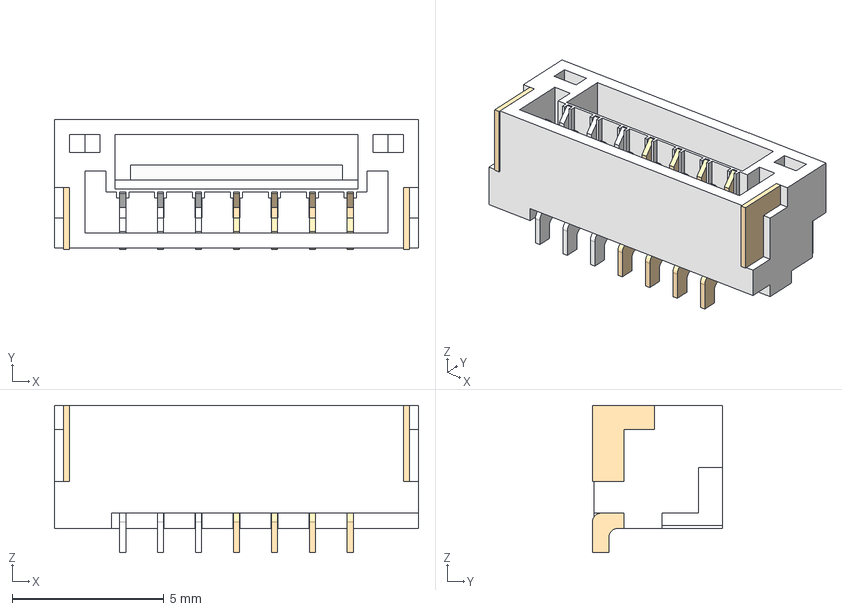
[picture p108: CAD file, 2026-01-16]
kiCad-solids/Connectors/SM07B-GHS-TB.stp
12.0 x 4.30 x 4.85 mm
