Merophy/enzyme/kiCad-solids/SmallOutline/TSSOP-14.step

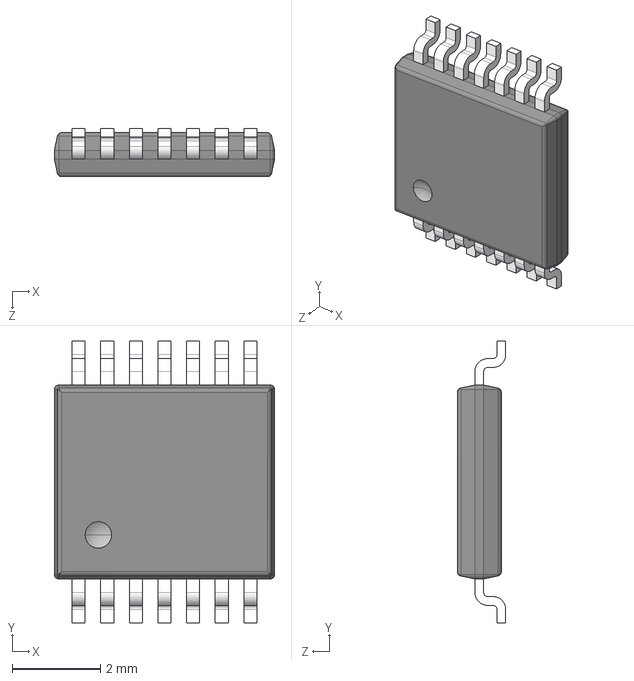
[picture p109: CAD file, 2022-03-05]
kiCad-solids/SmallOutline/TSSOP-14.step
5.00 x 6.40 x 1.10 mm
