Merophy/enzyme/kiCad-solids/Connectors/SM14B-GHS-TB.stp

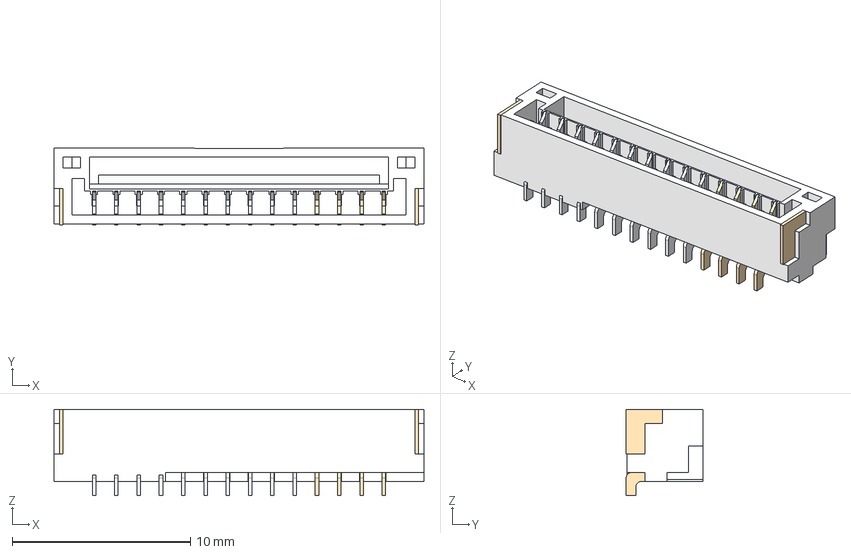
[picture p110: CAD file, 2026-01-16]
kiCad-solids/Connectors/SM14B-GHS-TB.stp
20.8 x 4.30 x 4.85 mm
