Merophy/enzyme/kiCad-solids/SmallOutline/TSSOP-56-EP.step

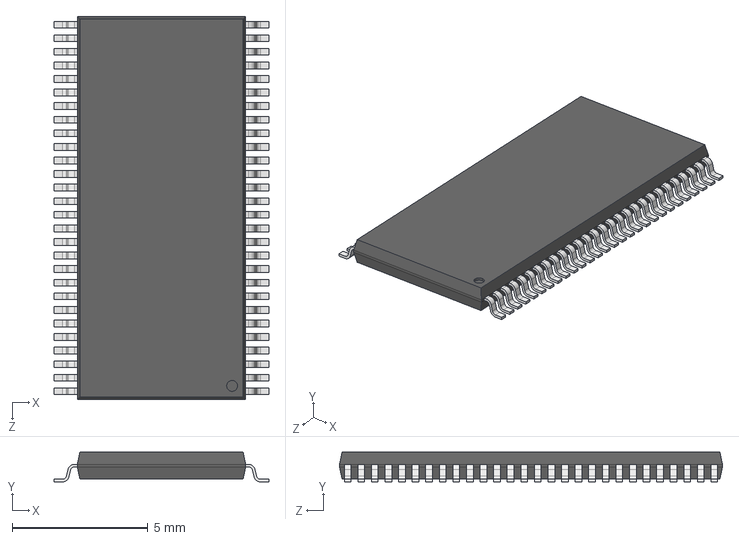
[picture p111: CAD file, 2022-03-04]
kiCad-solids/SmallOutline/TSSOP-56-EP.step
7.90 x 1.10 x 14.1 mm
pin_TSSOP_tsop_1 x 56
body_TSSOP_TSSOP_14.1x6.2_1
