Merophy/enzyme/kiCad-solids/Connectors/SM11B-GHS-TB.stp

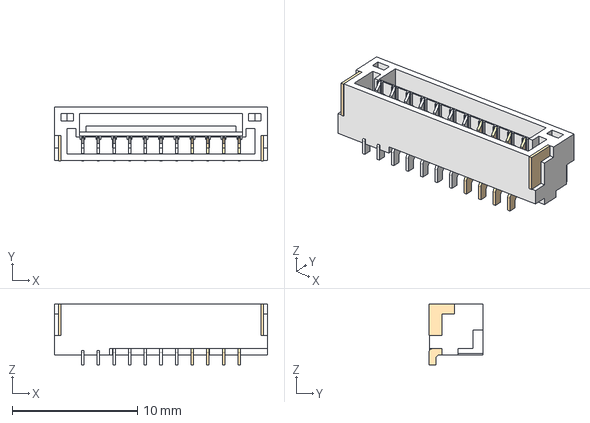
[picture p112: CAD file, 2026-01-16]
kiCad-solids/Connectors/SM11B-GHS-TB.stp
17.0 x 4.30 x 4.85 mm
