Merophy/enzyme/kiCad-solids/SmallOutline/SOT-23.step

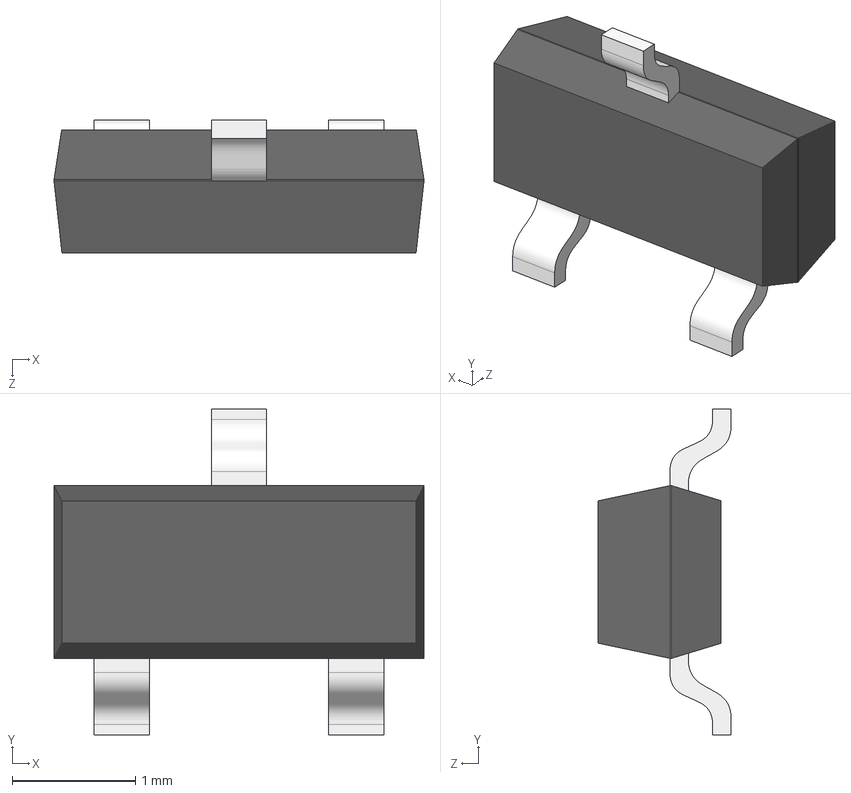
[picture p113: CAD file, 2022-03-04]
kiCad-solids/SmallOutline/SOT-23.step
3.00 x 2.64 x 1.08 mm
