Merophy/enzyme/kiCad-solids/Connectors/SM15B-GHS-TB.stp

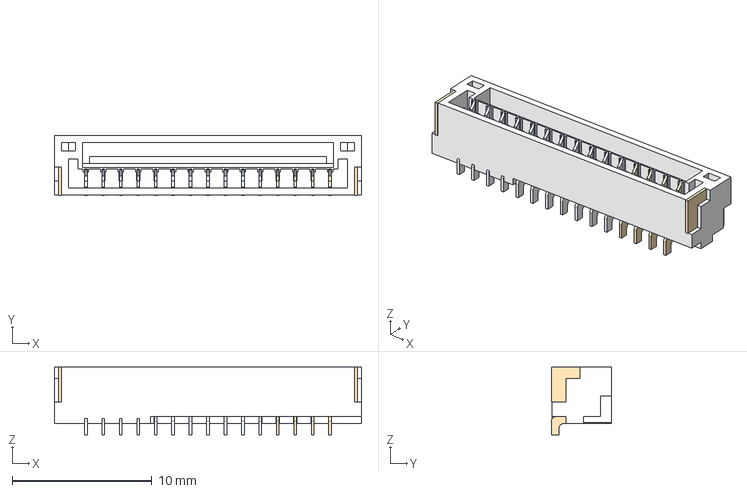
[picture p114: CAD file, 2026-01-16]
kiCad-solids/Connectors/SM15B-GHS-TB.stp
22.0 x 4.30 x 4.85 mm
