Merophy/enzyme/kiCad-solids/SmallOutline/SOT-23-5.step

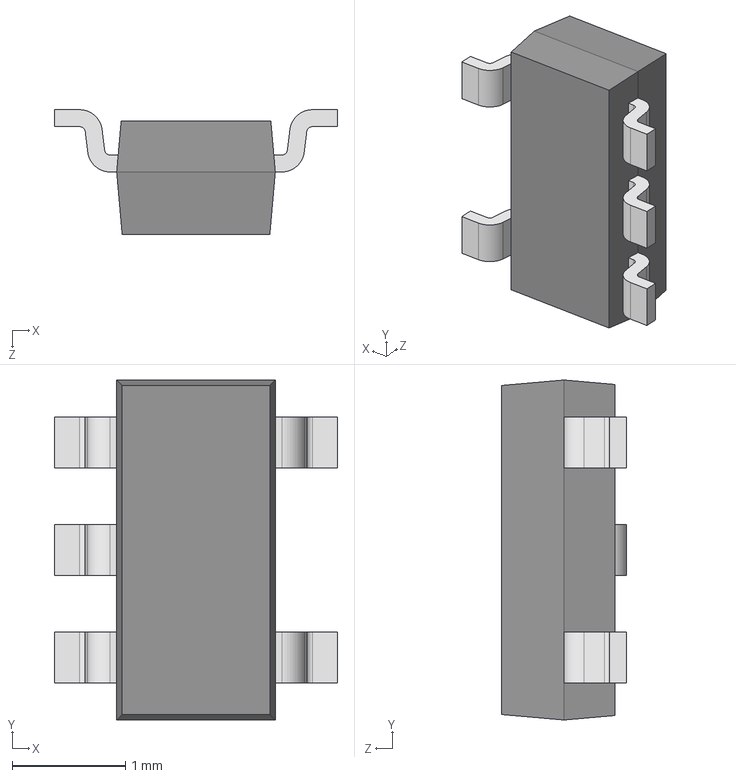
[picture p115: CAD file, 2022-03-03]
kiCad-solids/SmallOutline/SOT-23-5.step
2.50 x 3.00 x 1.10 mm
