Merophy/enzyme/kiCad-solids/Connectors/SM05B-GHS-TB.stp

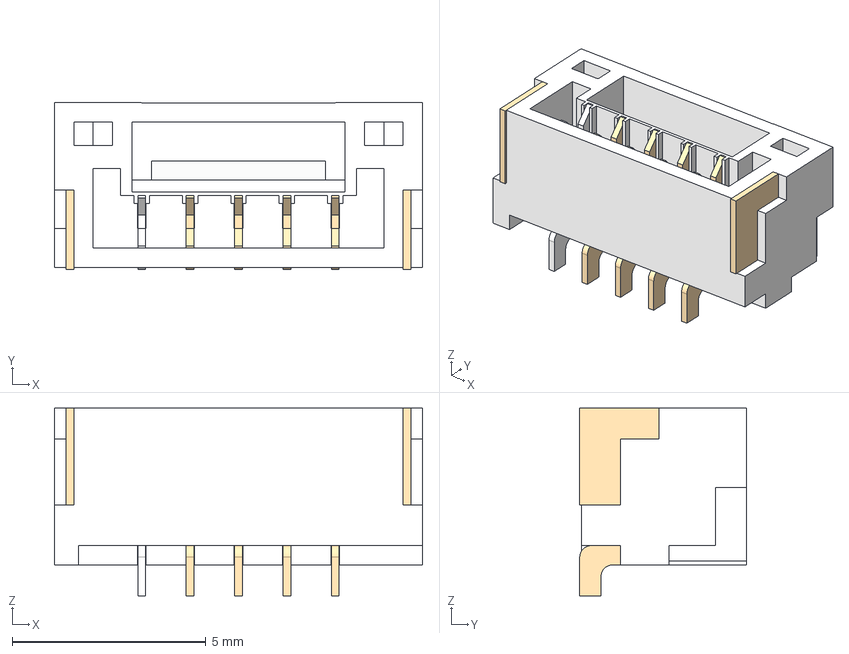
[picture p116: CAD file, 2026-01-16]
kiCad-solids/Connectors/SM05B-GHS-TB.stp
9.50 x 4.30 x 4.85 mm
