Merophy/enzyme/kiCad-solids/Connectors/SM13B-GHS-TB.stp

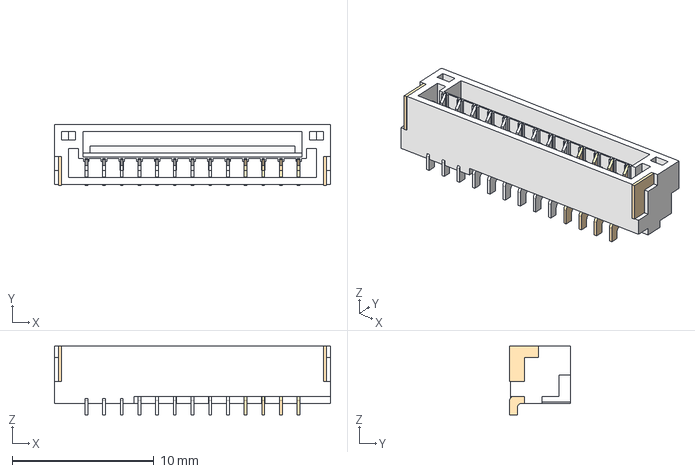
[picture p117: CAD file, 2026-01-16]
kiCad-solids/Connectors/SM13B-GHS-TB.stp
19.5 x 4.30 x 4.85 mm
