Merophy/enzyme/kiCad-solids/Connectors/BM11B-GHS-TBT.step

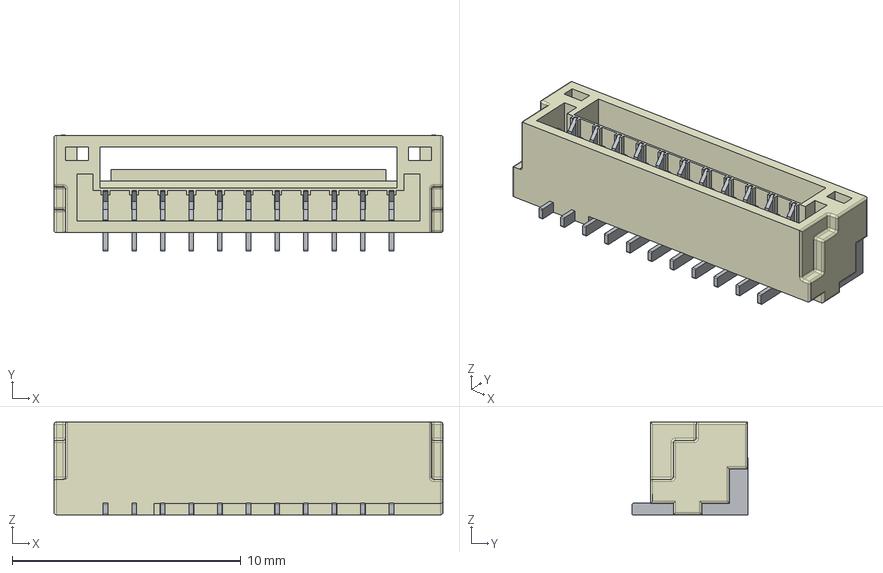
[picture p118: CAD file, 2026-01-16]
kiCad-solids/Connectors/BM11B-GHS-TBT.step
17.0 x 5.06 x 4.05 mm
SM11B-GHS-TB011
SM11B-GHS-TB012
