Merophy/enzyme/kiCad-solids/Connectors/SM06B-GHS-TB.stp

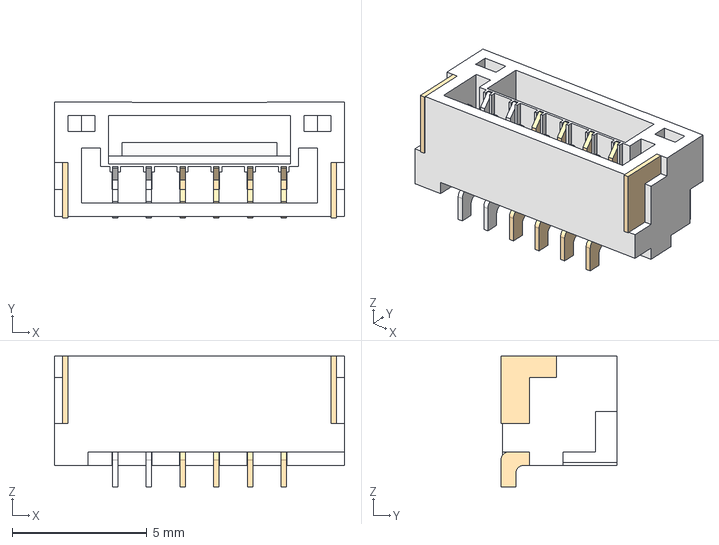
[picture p119: CAD file, 2026-01-16]
kiCad-solids/Connectors/SM06B-GHS-TB.stp
10.8 x 4.30 x 4.85 mm
