Merophy/enzyme/kiCad-solids/Connectors/SMTSO3060.step

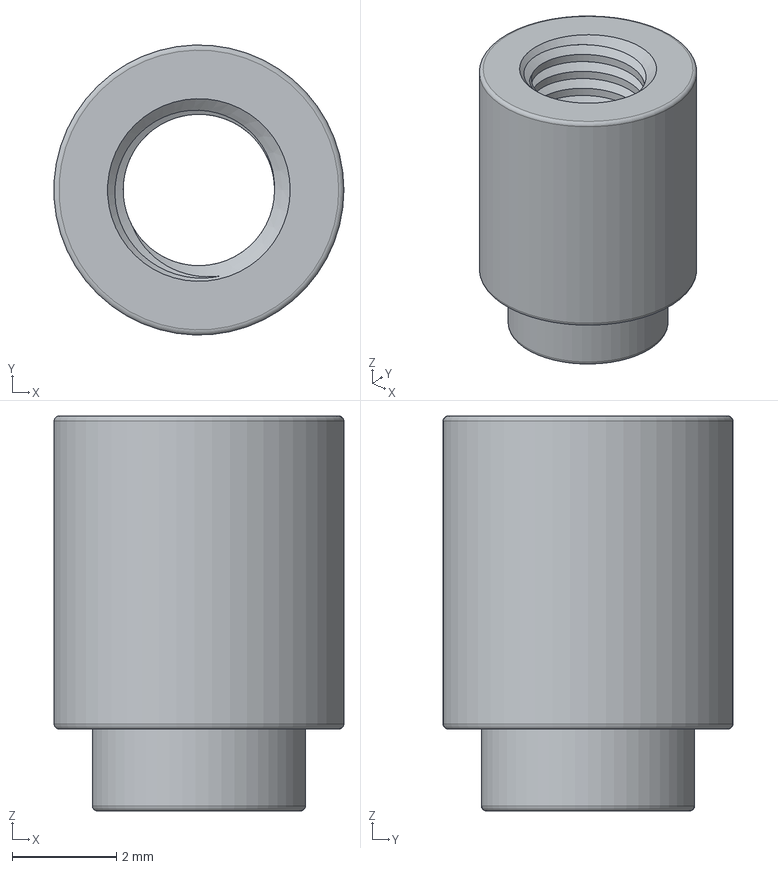
[picture p120: CAD file, 2025-07-31]
kiCad-solids/Connectors/SMTSO3060.step
5.55 x 5.56 x 7.57 mm
