Merophy/enzyme/kiCad-solids/Connectors/SMTSO3220.step

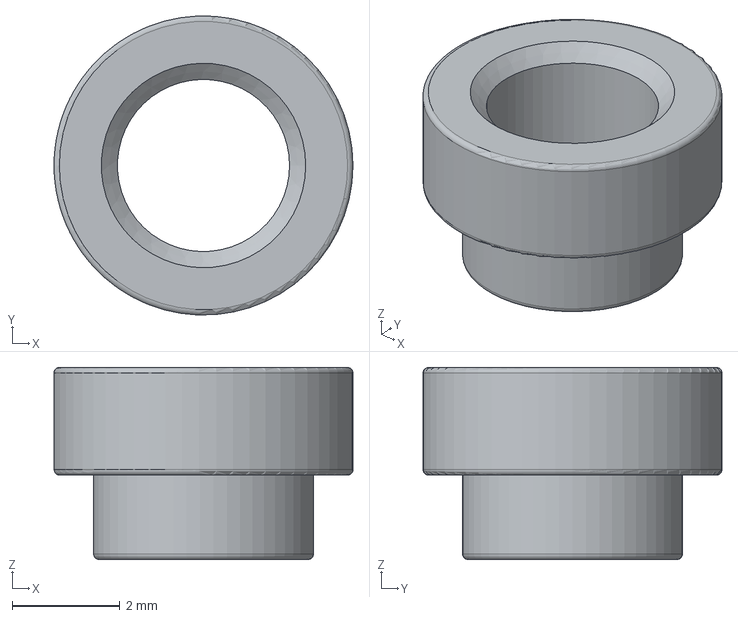
[picture p121: CAD file, 2025-07-31]
kiCad-solids/Connectors/SMTSO3220.step
5.56 x 5.56 x 3.57 mm
