Merophy/enzyme/kiCad-solids/Connectors/SMTSO3080.step

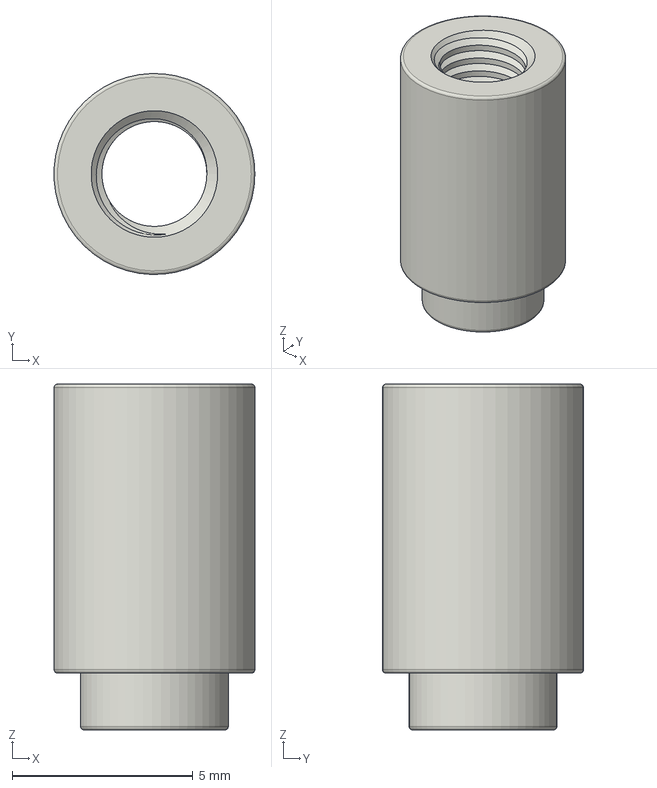
[picture p122: CAD file, 2025-04-30]
kiCad-solids/Connectors/SMTSO3080.step
5.55 x 5.56 x 9.57 mm
