Merophy/enzyme/kiCad-solids/Connectors/SMTSO30120.step

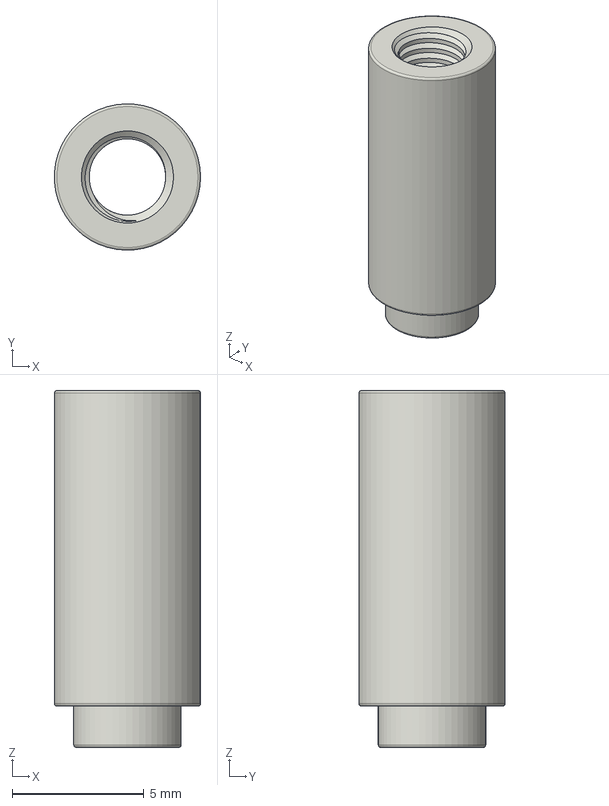
[picture p123: CAD file, 2025-04-30]
kiCad-solids/Connectors/SMTSO30120.step
5.55 x 5.56 x 13.6 mm
