Merophy/enzyme/kiCad-solids/Connectors/M2.5_5mm_Round_Standoff.step

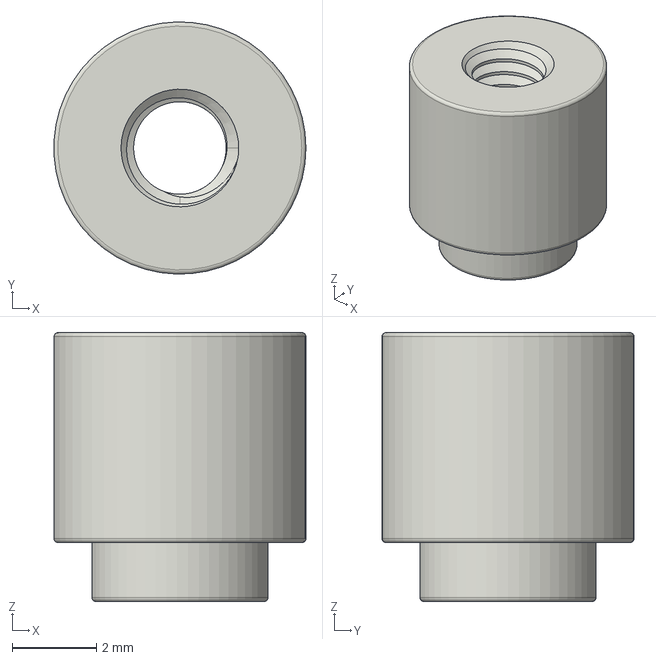
[picture p124: CAD file, 2025-04-30]
kiCad-solids/Connectors/M2.5_5mm_Round_Standoff.step
5.99 x 6.00 x 6.40 mm
