Merophy/enzyme/kiCad-solids/Connectors/Header_female_2x10_2mm.step

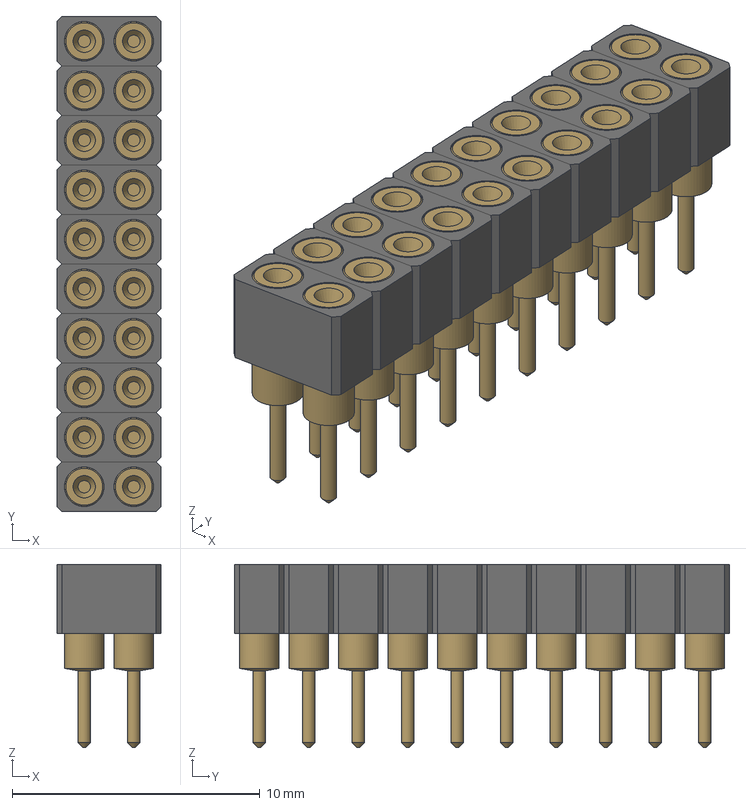
[picture p125: CAD file, 2025-04-20]
kiCad-solids/Connectors/Header_female_2x10_2mm.step
4.20 x 20.0 x 7.40 mm
