Merophy/enzyme/kiCad-solids/Connectors/Header_male_2x6_2mm.step

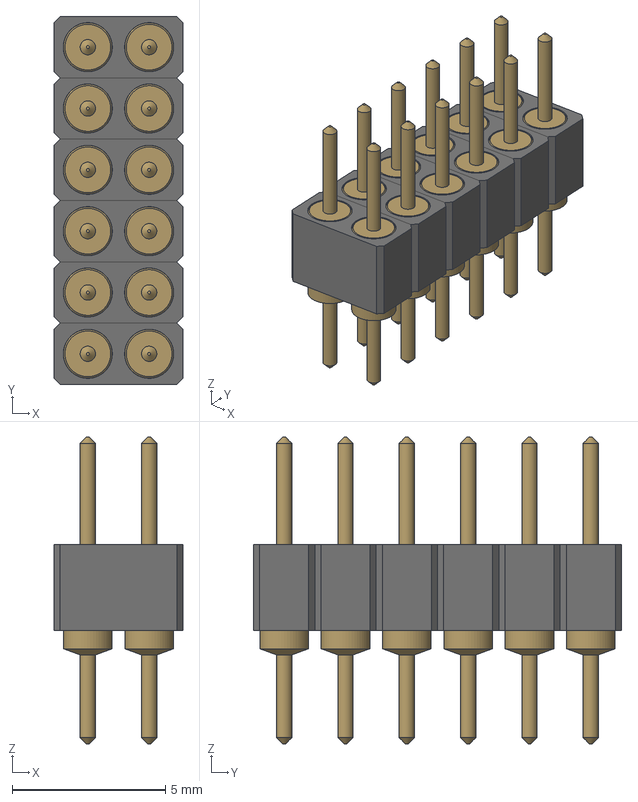
[picture p126: CAD file, 2025-04-20]
kiCad-solids/Connectors/Header_male_2x6_2mm.step
4.20 x 12.0 x 10.0 mm
