Merophy/enzyme/kiCad-solids/Connectors/Header_female_2x6_2mm.step

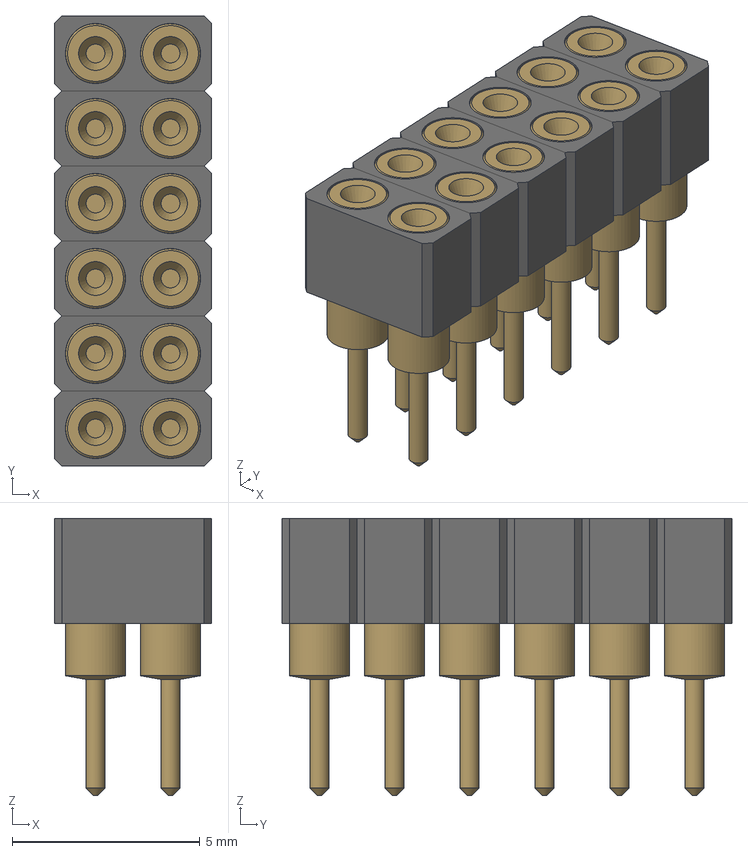
[picture p127: CAD file, 2025-04-20]
kiCad-solids/Connectors/Header_female_2x6_2mm.step
4.20 x 12.0 x 7.40 mm
