Merophy/enzyme/kiCad-solids/Connectors/Header_male_2x10_2mm.step

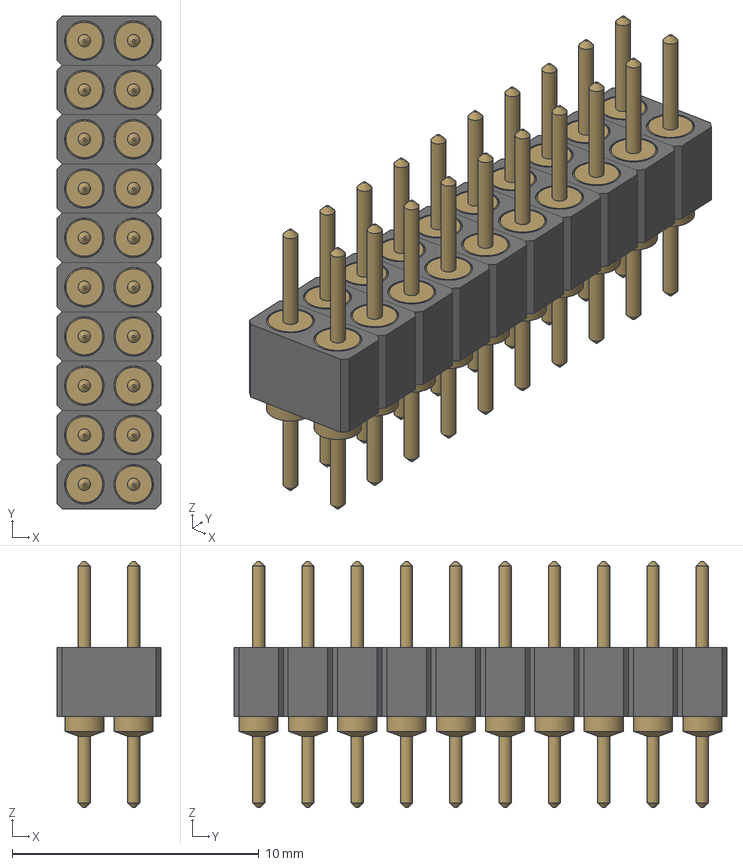
[picture p128: CAD file, 2025-04-20]
kiCad-solids/Connectors/Header_male_2x10_2mm.step
4.20 x 20.0 x 10.0 mm
