Merophy/enzyme/kiCad-solids/Connectors/GT-BTP16003-0180B-014B.step

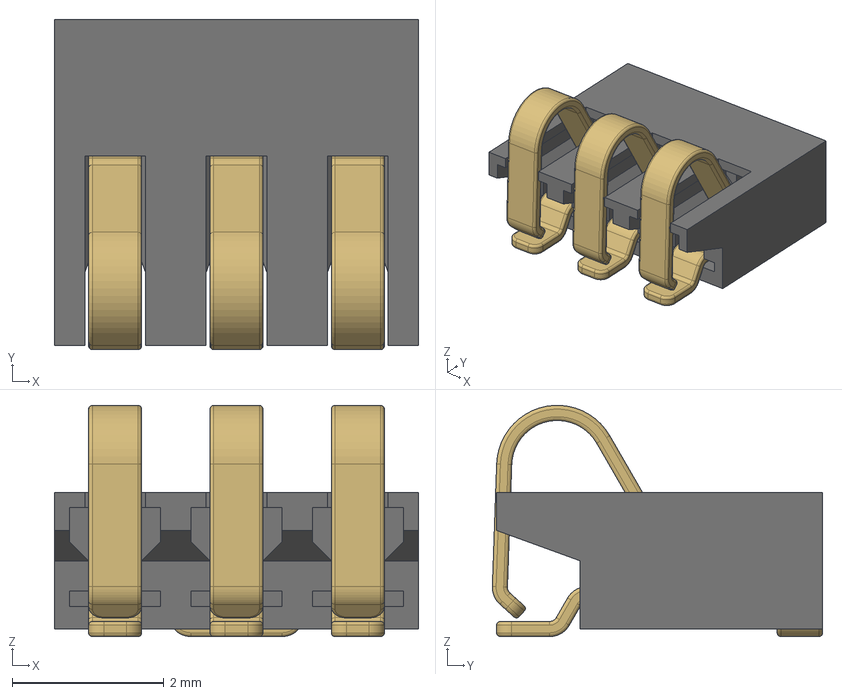
[picture p129: CAD file, 2025-03-19]
kiCad-solids/Connectors/GT-BTP16003-0180B-014B.step
4.80 x 4.36 x 3.05 mm
