Merophy/enzyme/kiCad-solids/Connectors/Cable_12AWG.step

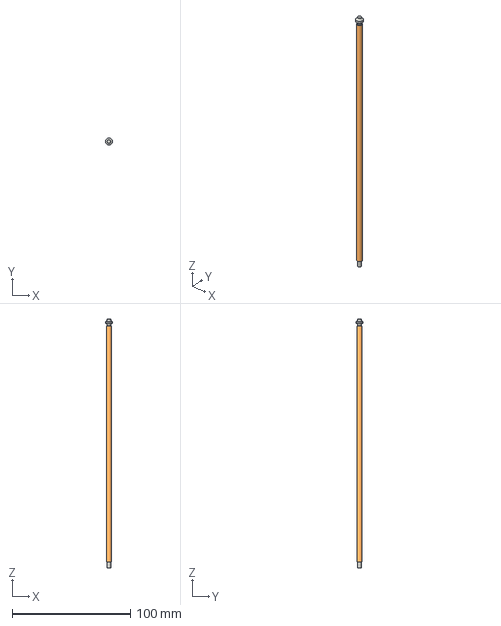
[picture p130: CAD file, 2025-02-25]
kiCad-solids/Connectors/Cable_12AWG.step
5.99 x 6.00 x 211.0 mm
