Merophy/enzyme/kiCad-solids/Connectors/Cable_24AWG.step

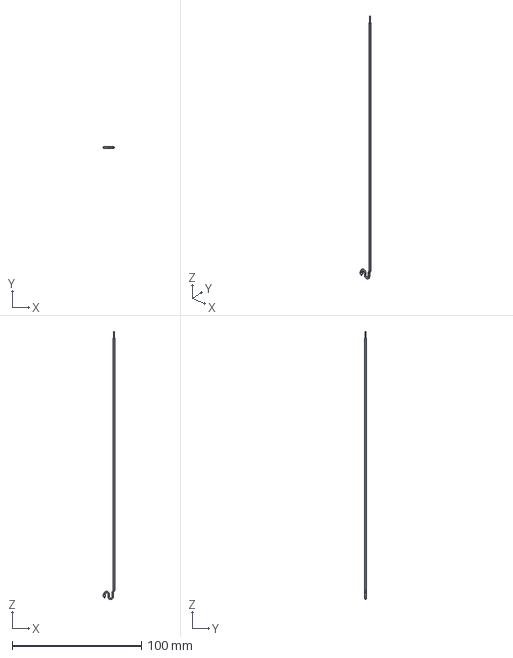
[picture p131: CAD file, 2025-02-25]
kiCad-solids/Connectors/Cable_24AWG.step
8.95 x 1.90 x 207.2 mm
