Merophy/enzyme/kiCad-solids/Connectors/GT-CEDVB-08P-01.step

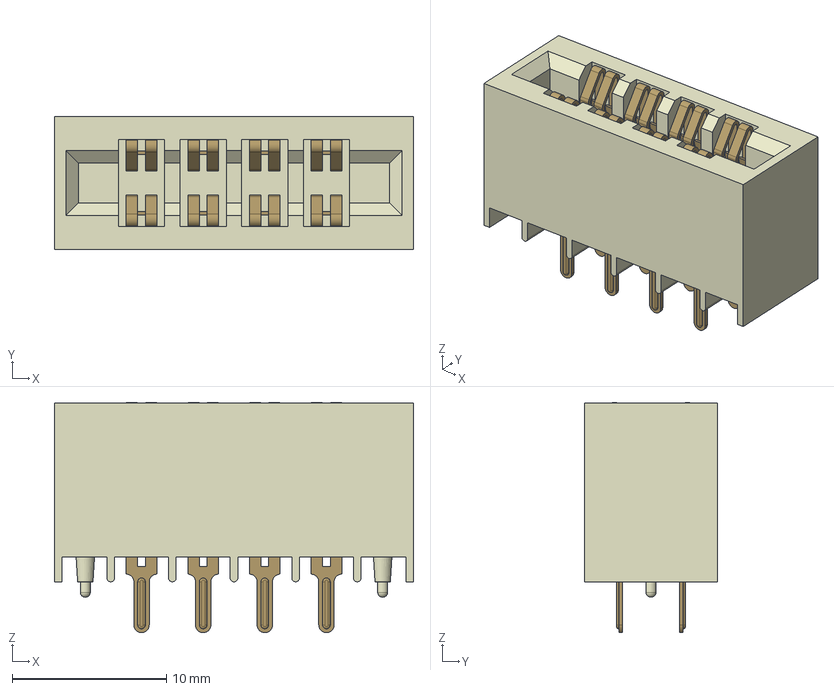
[picture p132: CAD file, 2025-02-14]
kiCad-solids/Connectors/GT-CEDVB-08P-01.step
23.3 x 8.60 x 15.0 mm
