Merophy/enzyme/kiCad-solids/Connectors/Cable_12AWG_SideSolder.step

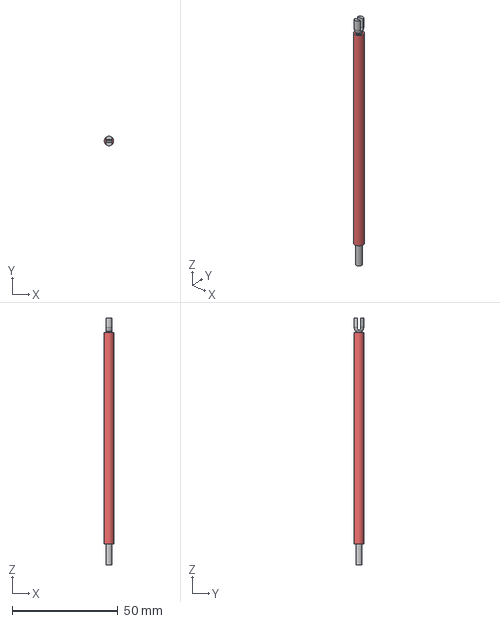
[picture p133: CAD file, 2024-12-03]
kiCad-solids/Connectors/Cable_12AWG_SideSolder.step
4.50 x 4.60 x 116.8 mm
