Merophy/enzyme/kiCad-solids/Connectors/Bullet_Female_4mm_Solder.step

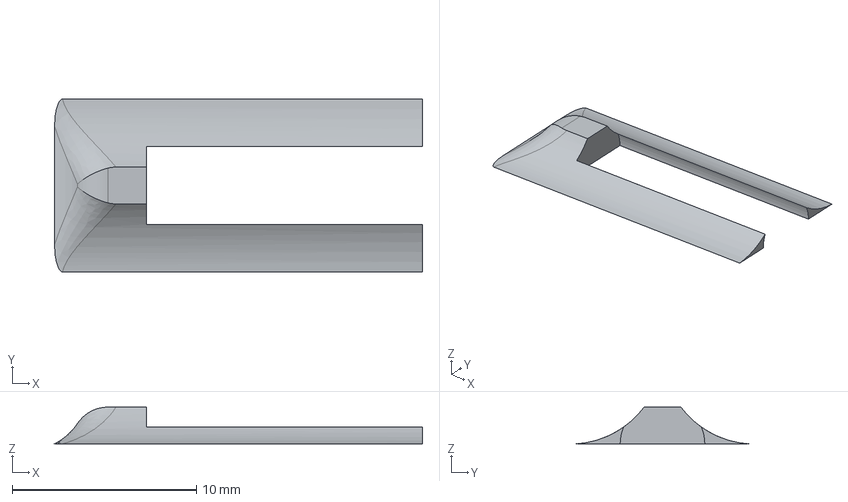
[picture p134: CAD file, 2024-12-03]
kiCad-solids/Connectors/Bullet_Female_4mm_Solder.step
20.0 x 9.40 x 2.00 mm
