Merophy/enzyme/kiCad-solids/Connectors/Bullet_Male_2mm.step

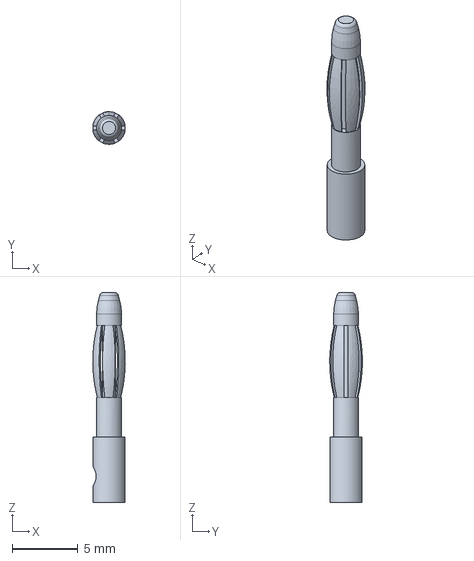
[picture p135: CAD file, 2024-11-18]
kiCad-solids/Connectors/Bullet_Male_2mm.step
2.48 x 2.49 x 16.0 mm
