Merophy/enzyme/kiCad-solids/Connectors/Bullet_Female_2mm.step

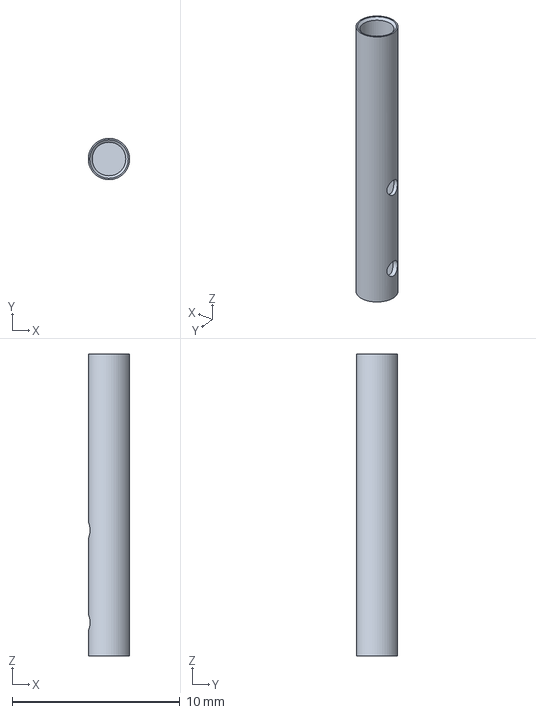
[picture p136: CAD file, 2024-11-18]
kiCad-solids/Connectors/Bullet_Female_2mm.step
2.47 x 2.47 x 18.0 mm
