Merophy/enzyme/kiCad-solids/Connectors/Bullet_Male_5mm.step

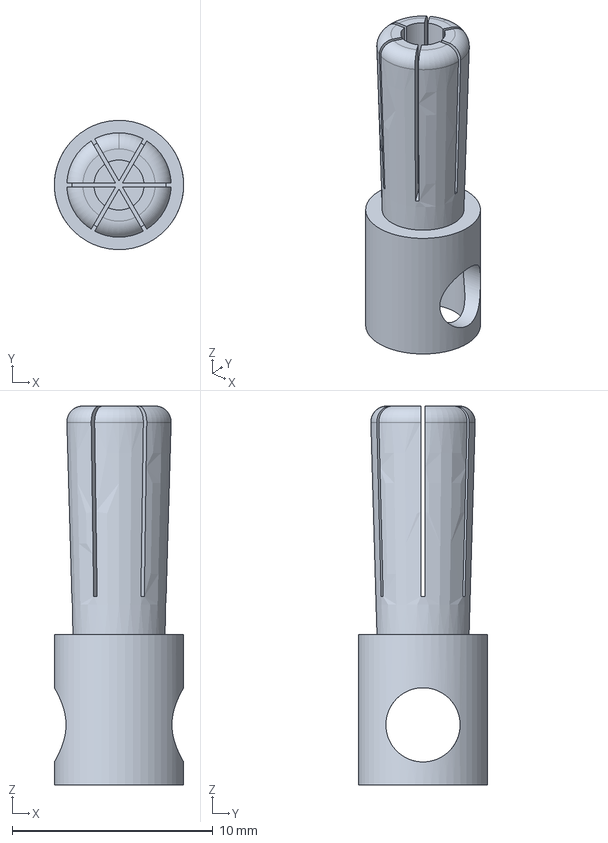
[picture p137: CAD file, 2024-11-18]
kiCad-solids/Connectors/Bullet_Male_5mm.step
6.45 x 6.45 x 18.9 mm
