Merophy/enzyme/kiCad-solids/Connectors/Bullet_Female_5mm.step

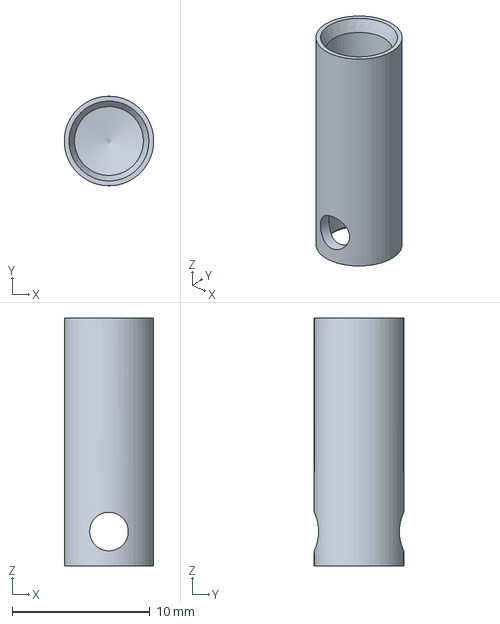
[picture p138: CAD file, 2024-11-18]
kiCad-solids/Connectors/Bullet_Female_5mm.step
6.49 x 6.50 x 18.0 mm
