Merophy/enzyme/kiCad-solids/Connectors/Bullet_Male_4mm.step

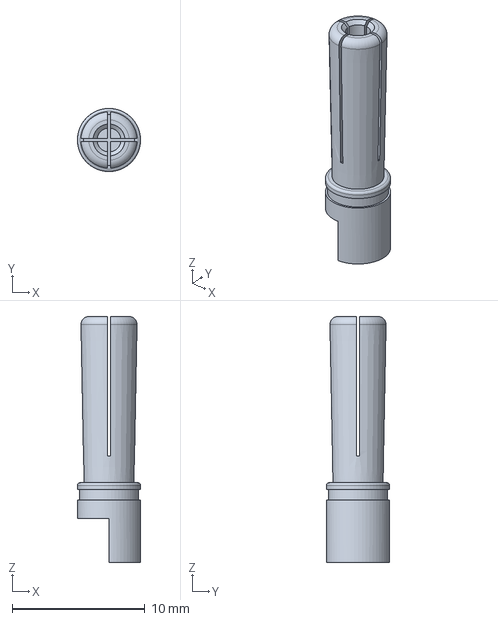
[picture p139: CAD file, 2024-11-18]
kiCad-solids/Connectors/Bullet_Male_4mm.step
4.75 x 4.75 x 18.5 mm
