Merophy/enzyme/kiCad-solids/Connectors/Bullet_Female_4mm.step

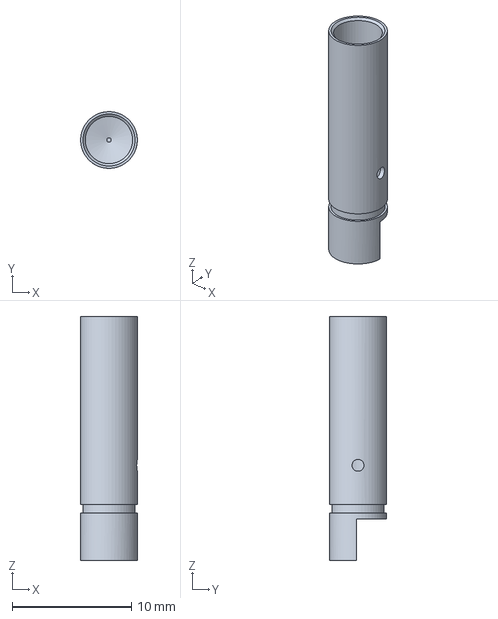
[picture p140: CAD file, 2024-11-18]
kiCad-solids/Connectors/Bullet_Female_4mm.step
4.77 x 4.77 x 20.5 mm
