Merophy/enzyme/kiCad-solids/Connectors/968-9VBattery.STEP

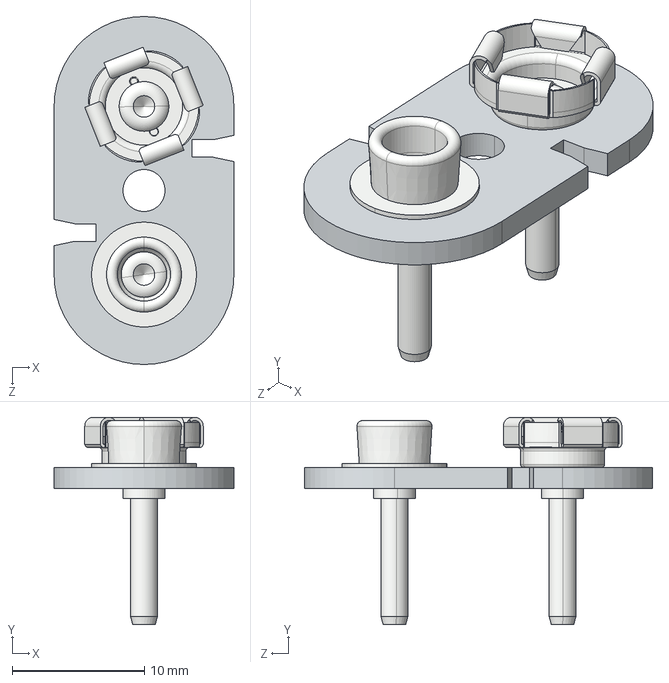
[picture p141: CAD file, 2024-03-21]
kiCad-solids/Connectors/968-9VBattery.STEP
13.6 x 15.7 x 26.3 mm
