Merophy/enzyme/kiCad-solids/Connectors/USB-C-1054500101.step

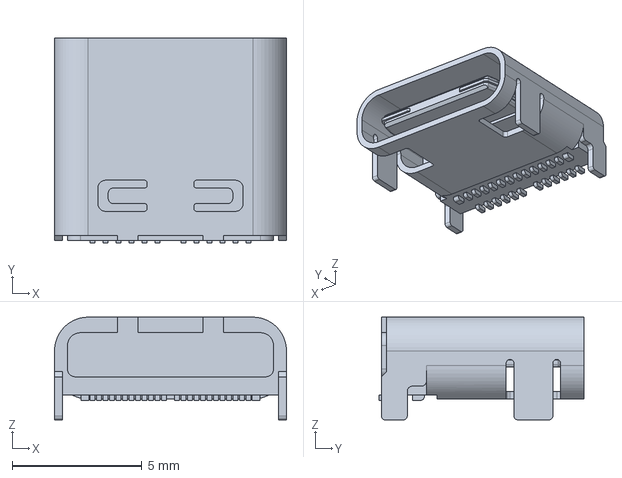
[picture p142: CAD file, 2022-10-01]
kiCad-solids/Connectors/USB-C-1054500101.step
8.94 x 7.90 x 3.96 mm
