Merophy/enzyme/kiCad-solids/Connectors/UFL-734120110.step

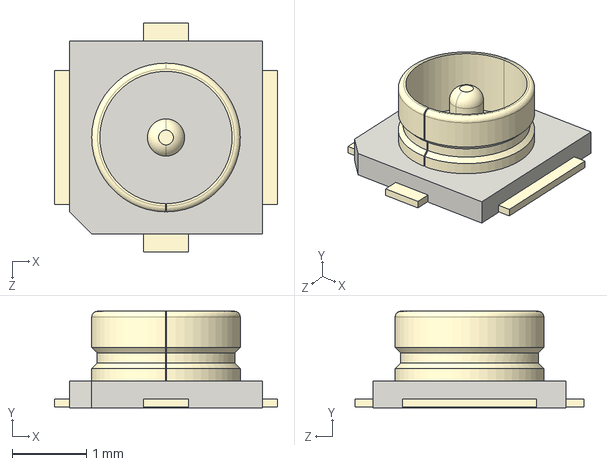
[picture p143: CAD file, 2022-10-01]
kiCad-solids/Connectors/UFL-734120110.step
3.00 x 1.30 x 3.08 mm
