Merophy/enzyme/(list of files, cad)

Other CAD files:
kiCad-solids/Connectors/5011902017.step
kiCad-solids/Connectors/5011904017.stp
kiCad-solids/Connectors/5015714007.stp
kiCad-solids/Connectors/502578-0500_WithCableAsm.step
kiCad-solids/Connectors/5025840470.stp
kiCad-solids/Connectors/5025840560.iges
kiCad-solids/Connectors/5025840560.step
kiCad-solids/Connectors/5025850570.step
kiCad-solids/Connectors/5031750500.step
kiCad-solids/Connectors/5031750500.stp
kiCad-solids/Connectors/5055680671.step
kiCad-solids/Connectors/524651071.step
kiCad-solids/Connectors/524651671.step
kiCad-solids/Connectors/533071071.step
kiCad-solids/Connectors/9774080360R.step
kiCad-solids/Connectors/9774100360R.step
kiCad-solids/Connectors/M2.5_5mm_Round_Standoff.dxf
kiCad-solids/Connectors/M2_8mm_Round_Standoff.step
kiCad-solids/Connectors/M3_1.5mm_Round_Standoff.step
kiCad-solids/Connectors/T34080080-0685.step
kiCad-solids/Connectors/TR34052060.step
kiCad-solids/Connectors/TS30000.step
kiCad-solids/Electromechanic/5027740891.stp
kiCad-solids/Mechanic/capScrewM3x5mm.step
