Merophy/enzyme/(commit log)

2022-02-04 created capacitor libraries
2022-02-14 created diode lib | added diodes: LED_A, LED_R
2022-02-15 added diodes: LED_Y
2022-02-17 added ICs: STM32F405RGTx, TCAN330
2022-02-17 created inductor lib | added diodes: 40V-1A Schottky; added ICs: DRV8301, TCAN 330, STM32F405RGTx; added resistors: 18K
2022-02-19 created connector lib | added connectors: 0524651071, 0524651671, 0533071071, 0533071671
2022-02-20 added connectors: SOICBite
2022-03-01 edited footprints of caps and res'| added resistor, capacitor and LED 3D models
    [LED-0603-1608.step, R-1206-3216.step]
2022-03-03 added packages: SOT-23-5, TSOT-23-8
    [SOT-23-5.step]
2022-03-04 added packages: HTSSOP-56-EP, SOT-23, SOT-363
    [SOT-23.step, TSSOP-56-EP.step]
2022-03-05 added packages: TSSOP-14
    [TSSOP-14.step]
2022-03-06 added packages: too many connectors, dual mosfet, lqfp-64
    [524651071.step, 524651671.step, 533071071.step, CSTNE.step, L-13.5x12.5x6.4mm.step, SOT1205.step]
2022-08-24 added components for Nixie v2
    [QFN-28.STEP, RP2040_QFN.STEP]
2022-08-24 added LED driver
2022-08-27 added footprints for nixie project
    [QFN-16.step, Tactile_4x4.step, WSON8-6x5.step]
2022-08-27 added led driver IC
2022-10-01 added some RF components
    [C-0402-1005.step, C-0603-1608.step, C-0805-2012.step, C-1206-3216.step, L-0402.step, L-0603.step, MS621FE.step, SOD-128.step]
2022-12-30 merged the last Avy-related libs and the nixie-panel libs
    [LED-0805-2512.step]
2023-10-01 changes related to PDB of the housekeeper
    [5025840470.step, 5025840470.stp, R-15-7.6mm.step, R-PDSO-G8.step, T34080080-0685.step, TS30000.step, capScrewM3x5mm.step]
2023-10-01 dublicated step file, fixed
    [5025840470.step, 5025840470.stp]
2024-03-21 added an MCU and an IMU
    [968-9VBattery.STEP, 9VDuracellBattery.step]
2024-11-18 cleaned the old format libraries
    [Bullet_Female_2mm.step, Bullet_Female_4mm.step, Bullet_Female_5mm.step, Bullet_Male_2mm.step, Bullet_Male_4mm.step, Bullet_Male_5mm.step]
2024-11-19 added molex clik-mate connector
    [502578-0500_WithCableAsm.step, 5025840560.iges, 5025840560.step, 5025850570.step]
2024-12-03 added Bullet_4mm_RA_footprint
    [Bullet_Female_4mm_Solder.step, Cable_12AWG_SideSolder.step]
2024-12-12 added M3 standoffs, Flipped SMD LED, added and modified some transistors
    [9774080360R.step, 9774100360R.step, LED-1206_btm.step, LED-1206_top_R.step]
2025-01-16 Added new Clik-mate connector and M3 Welding Connector
    [M3 x 0.5mm Thread 5mm.STEP, TR34052060.step]
2025-01-31 updated M3 holes and added some mechanical parts
    [M3 x 0.5mm Thread 12mm.STEP, Same_Sky_CPE-420.step]
2025-02-04 added AT115 ESC
    [ESC_AT115A_Coloured.step]
2025-02-08 added M3 power terminal
2025-02-14 added a board edge connector, some ESCs, and a fan
    [ESC_FLAME_80A_Coloured.step, GT-CEDVB-08P-01.step, fan_40_40_28_coloured.step]
2025-02-16 added several connectors and modified Flame-80A ESC
    [M2_8mm_Round_Standoff.step]
2025-02-17 added Board Edge footprint
2025-02-19 added several fasteners, a polarized cap, cleaned the mechanic library, and some modifications
    [M2 x 0.4mm Thread 5mm.STEP, M3 x 0.5mm Thread 30mm.STEP, M3 x 0.5mm Thread 35mm.STEP, M3_1.5mm_Round_Standoff.step]
2025-02-25 added one 24 and one 12AWG cables
    [Cable_12AWG.step, Cable_24AWG.step]
2025-03-19 added programmable LEDs
    [GT-BTP16003-0180B-014B.step, WS2812-0807.STEP, WS2812-2020.STEP]
2025-03-19 added the board edge connector's symbol
2025-03-19 added several power components
2025-03-25 Created new libraries: DualFlat, Bar; added several power ICs
    [DFN-8.step, SOT-89.step, TDSON-8.step]
2025-04-17 added several connectors, polarized capacitors
    [5031750500.step, 5031750500.stp]
2025-04-20 added several header pins and a polar cap
    [CP-d8-p3.50.step, Header_female_2x10_2mm.step, Header_female_2x6_2mm.step, Header_male_2x10_2mm.step, Header_male_2x6_2mm.step]
2025-04-30 added sereval mechanical parts, standoffs and functional modules
    [502578-0500_WithCableAsm.step, 5025840470.stp, 5025840560.iges, 5025840560.step, 5025850570.step, 5031750500.step, 5031750500.stp, 524651071.step]
2025-04-30 fixing the mulfunction caused by a too large file
    [502578-0500_WithCableAsm.step, 5025840470.stp, 5025840560.iges, 5025840560.step, 5025850570.step, 5031750500.step, 5031750500.stp, 524651071.step]
2025-05-12 added STM32H7 and several related components
2025-05-27 Added STLink_v3, battery holder, sdCard
    [5027740891.stp, CR1220_Holder.step, RS08U111Z001.STEP]
2025-05-27 modified several resistors and connectors
2025-07-24 added power LEDs for navigation lights
    [LED-2835.step]
2025-07-25 Power LED packege flaw fixed
2025-07-30 Pin mismatch on RED power led, fixed
2025-07-31 added several m3 joints
    [M3_LowHead.step, SMTSO3060.step, SMTSO3220.step]
2025-08-08 fixed the mistake on a screw and relevant screw hole
2025-08-16 added a pressure sensor, MS4525DO
    [MS4525DO.step]
2026-01-02 first update after splittin Kirke's brain
    [R-0603-1609.step]
2026-01-05 modified most of the libraries to have multiple reference for 3d models
    [C-0402-1005.step, C-0805-2012.step, C-1206-3216.step, C-1210.STEP, R-0402-1005.step, R-0805-1608.step]
2026-01-16 added GHS and Molex connectors, several ICs packages
    [5011904017.stp, 5015714007.stp, 5055680671.step, BM11B-GHS-TBT.step, QFN-32.STEP, RHL0024A.stp, RTE0016C.stp, SM04B-GHS-TB.stp]
2026-09-24 Add IGC037S12S1, LMG1210 and SMTSO42100CTJ
    - IGC037S12S1 (Infineon CoolGaN 120V G3): GaN HEMT symbol, TSON-6
    footprint from datasheet land pattern, Infineon STEP model recoloured
    - LMG1210 (TI 200V half-bridge GaN driver): symbol laid out per the
    functional block diagram, QFN-19-2EP footprint (RVR0019A, two
    exposed pads, split paste), TI STEP model recoloured (black body,
    tin leads)
    - SMTSO42100CTJ (Sinhoo 4.2x8.74x10 SMT standoff): symbol,
    M4_10mm_Round_ThruHole footprint, detailed STEP model
    Symbol libraries kept in KiCad 9 format; additions only.
    [RVR0019A.stp, SMTSO42100.step, TSON-6.step]
2026-09-24 Add BAS516-Q, fix SMTSO42100 datasheet link
    - BAS516-Q (Nexperia high-speed switching diode, 100V 250mA, AEC-Q101):
    symbol (standard diode), SOD-523 footprint per Nexperia sod523_fr
    with cathode bar on silkscreen, STEP model with cathode band
    - SMTSO42100: point Datasheet at the direct PDF; the lcsc.com/datasheet
    URL now serves a viewer page that KiCad cannot open
    [SOD-523.step]
2026-09-25 Add 1mR shunt, 2.2R, 100nF-LV, 220nF; widen LMG1210
    - 1mR: Milliohm HoJLR0612-1W-1mR-1% (C45926612) with new R-0612
    wide-terminal footprint (pads per datasheet, no silkscreen graphics)
    and STEP model
    - 2.2R: Vishay CRCW04022R20FKED (C482139), 0402
    - 100nF-LV: Samsung CL05B104KO5NNNC 16V (C1525), 0402
    - 220nF: Samsung CL05B224KO5NNNC 16V (C16772), 0402
    - LMG1210: two more grid units between the high-side and low-side
    pin groups for decoupling-cap room
    [R-0612-1632.step]
2026-10-06 Add 1.27mm 2x4/2x5 SMD headers and LTC7000-1
    - Header_1.27mm_Female_2x4: LAILAN LAIL-PM1.27-4PX2-T (C54973808);
    footprint from LCSC HDR-SMD_8P-P1.27-V-M-R2-C4-LS5.0, STEP drawn
    from the product photos (insulator height assumed 4.3mm)
    - Header_1.27mm_Male_2x5: XFCN PZ127VS-12-10-H10-A38 (C2935458);
    pads per XFCN drawing, LCSC STEP lifted 0.4mm, pins recoloured gold,
    EasyEDA logo hidden
    - LTC7000-1: ADI 135V protected high-side NMOS driver (C690076);
    symbol per block diagram, new MSE16-12-EP footprint (MSOP-16 with
    pins 2/4/13/15 removed, ADI pad layout, 0.30mm pads), LCSC STEP
    rotated 90deg and recoloured
    Silkscreen: pin-1 arrows only. Symbol libraries remain KiCad 9 format.
    C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
    [Header_female_2x4_1.27mm_SMD.step, Header_male_2x5_1.27mm_SMD.step, MSE16-12.step]
2026-10-07 Add 100pF-HV and C-0603 footprint; detailed 1mR shunt model
    - 100pF-HV: Yageo CC0603JRNPO0BN101, 100V NP0 0603 (C107033)
    - C-0603: new footprint (pads as R-0603, no silkscreen graphics);
    also fixes the existing 22uF-LV symbol, which referenced it
    - R-0612-1632.step: redrawn after the product photos (black epoxy top
    with R001 marking, tin side terminals, alloy layer, green underside)
    [R-0612-1632.step]
2026-10-07 Add 2x5 female header; tight self-centring 1.27mm header footprints
    - Header_1.27mm_Female_2x5: LAILAN LAIL-PM1.27-5PX2-T (C54973807),
    mates with Header_1.27mm_Male_2x5; LCSC STEP lifted 0.2mm,
    recoloured, embossed logo hidden
    - All three 1.27mm headers: pads = lead width + 0.1mm, heel 0.5mm
    under the body, ~0.3mm toe fillet, for accurate self-alignment of
    the board-to-board connectors
    - Header_1.27mm_Female_2x4: moved to the LAILAN series cross-section
    (lead span 4.8mm) instead of LCSC's male-header land pattern; STEP
    updated to the series body (5.48 x 3.0 x 4.5mm)
    [Header_female_2x4_1.27mm_SMD.step, Header_female_2x5_1.27mm_SMD.step]
2026-10-07 LTC7000-1: use ADI's MSE16(12) STEP model with exposed pad
    The LCSC model had no exposed pad. ADI's 05-08-1871 model is already
    oriented like the footprint (rotation 90 -> 0); recoloured to black
    body, tin leads and pad, geometry unchanged.
    [MSE16-12.step]
2026-10-07 SMTSO standoffs: JLCPCB Part # field and direct datasheet PDFs
    - SMTSO30120, SMTSO3060, SMTSO3080, SMTSO3220: rename "LCSC Part #" to
    "JLCPCB Part #" like the rest of the library
    - Datasheet links now point at the direct wmsc.lcsc.com PDFs; the old
    lcsc.com/datasheet viewer pages do not open from KiCad
    - SMTSO30120 linked SMTSO3080's datasheet; now links its own
2026-10-07 Add XC7Z020-CLG484 Zynq-7020 symbol, footprint and 3D model
    - Symbol XC7Z020-CLG484 (9 units: PL banks 13/33/34/35, PS MIO 500/501,
    PS DDR 502, Config/JTAG/XADC, Power), pins from AMD xc7z020clg484pkg.txt
    - New CoF_BallGridArray library: CLG484_19x19mm, 0.8 mm pitch, 0.40 mm NSMD
    pads with 0.50 mm mask per UG865 Table A-1
    - CLG484.step per UG865 Figure 4-3 (19x19 mm, A 1.47 mm, 0.50 mm balls)
    [CLG484.step]
2026-10-08 Add W25Q128JVE, INA241A1/A5; normalise field names; rebuild TSOT-23-8
    - W25Q128JVE (W25Q128JVEIQ, C2456297) with new WSON-8-EP_8x6mm footprint
    (Winbond package code E) and WSON8-8x6 model
    - INA241A1 / INA241A5 (C19712054 / C7425524) with new SOT-23-THIN-8_DDF
    footprint (TI DDF0008A land pattern) and model; pin 4 stacked on GND
    - W25Q128JVP: Winbond datasheet PDF, WSON 6x5 footprint filter
    - Field names normalised across all symbol libraries: MFR. Part #,
    JLCPCB Part #, Digikey Part #, Mouser Part #, VDS
    - TSOT-23-8: same pads, house format, pin-1 arrow only, new 1.2 mm model
    (old model floated 0.5 mm above the pads)
    [SOT-23-THIN-8_DDF.step, WSON8-8x6.step]
2026-10-09 Add MPM54304-0003, KSZ9031RNX, 17x3x2.8 copper bar; fix 20x2.5 bar
    - MPM54304-0003 (MPM54304GMN-0003, C3189336): quad buck module, -0003 =
    divider outputs, buck 3 & 4 paralleled; new CoF_LandGridArray
    LGA-33_7x7mm per MPS recommended land pattern, LGA-33 model
    - KSZ9031RNX (KSZ9031RNXIC-TR, C478094): gigabit RGMII PHY; new
    CoF_QuadFlat QFN-48-EP_7x7mm per Microchip C04-3124 (5.05 mm ePad),
    VQFN-48 model; pin names cross-checked against LCSC
    - Bar_17x3x2.8mm (STEIPU STHW4-DU-TS1702X830, C18548297): pad 0.3 mm
    larger than the bar on every side, no silkscreen or courtyard so bars
    can sit side by side; model shaped after the product photo
    - Bar_20x2.5x0.8mm: in BOM, datasheet now the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
    [Copper_17x3x2.8mm.step, Copper_20x2.5x0.8mm.step, LGA-33_7x7mm.step, QFN-48-EP_7x7mm.step]
2026-10-09 Add USB3320C, TCAN1044AV-Q1, ASE-33.333MHz, 1uF-HV-0805
    - USB3320C (USB3320C-EZK-TR, C132156): USB 2.0 ULPI PHY; new CoF_QuadFlat
    QFN-32-EP_5x5mm per Microchip 32QFN-3304-5x5B land pattern, QFN-32 model;
    pin names cross-checked against LCSC
    - TCAN1044AV-Q1 (TCAN1044AVDRBRQ1, C3234119): CAN FD transceiver with VIO,
    built from the TCAN330 symbol; new CoF_DualFlat VSON-8-EP_3x3mm_DRB per
    TI DRB0008J, VSON-8 model
    - ASE-33.333MHz (ASE-33.333MHZ-LC-T, C1987270): 3.3 V CMOS oscillator in
    CoE_Clock (kept in its KiCad 6 syntax); new CoF_Crystal
    Oscillator_SMD_3.2x2.5mm per the Abracon land pattern, photo-based model
    - Capacitors: 1uF-HV-0805 (CC0805KKX7R0BB105, C5370002) added; 1uF-HV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
    [Oscillator_SMD_3.2x2.5mm.step, QFN-32-EP_5x5mm.step, VSON-8-EP_3x3mm_DRB.step]
2026-10-09 Kelvin 0612 shunt; IN+ on top for INA amps; add SN74LVC1G3157
    - R-0612 / 1mR: 4-terminal shunt. Pads 3/4 are 0.20/0.45 mm Kelvin sense
    vias (JLCPCB no-extra-cost size) inside pads 1/2, annular ring 0.10 mm
    from the inner pad edge; net_tie_pad_groups 1-3 / 2-4; paste split off
    the vias; bottom tented. 1mR symbol gains sense pins 3/4.
    - INA241A1, INA241A5, INA293A4, INA199A1: IN+ moved above IN-
    - SN74LVC1G3157 (SN74LVC1G3157DCKR, C38663): SPDT analog switch
    - SOT-363: same pads (TI DCK0006A), house format, pin-1 arrow only, new
    SC-70-6 model (old one pointed at a KiCad 6 path)
    [SOT-363.step]
2026-10-13 Add LTC7000, CSD19538Q2, AGM18N10AP, LM5148, 5.1R-HP
    - LTC7000 (LTC7000EMSE#TRPBF, C690074): full MSE16 pinout with RUN, OVLO,
    ISET, IMON; new CoF_SmallOutline MSE16-EP (ADI 05-08-1667) and model
    - CSD19538Q2 (C2838636): 100 V NexFET; new CoF_DualFlat
    WSON-6-2EP_2x2mm_DQK with separate drain and source pads, model
    - AGM18N10AP (C7509649): 100 V 17 mOhm MOSFET; new CoF_DualFlat
    PDFN-8_3.3x3.3mm (drain copper all pad 5), model
    - LM5148 (LM5148RGYR, C7470701): 80 V sync buck controller; new
    CoF_QuadFlat VQFN-24-EP_3.5x5.5mm_RGY, lead pads per TI RGY0024E,
    EP copper 2.1x4.1 with paste inside 2.05x3.1 (exposed-pad variant to be
    confirmed with TI); NC pins and EP stacked on AGND
    - 5.1R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
2026-10-14 Add LM5060; clean up VSSOP10_3x3mm
    - LM5060 (LM5060MMX/NOPB, C2676940): high-side protection controller
    - VSSOP10_3x3mm: same pads (TI DGS0010A), house format, pin-1 arrow only,
    own MSOP-10 model (old one pointed at a KiCad 9 stock path)
2026-10-16 Add PowerRegulation parts: LM5013, TPS563201, MWSA0503S inductor, CoE_Power +6.5V
    Symbols: LM5013 (SO PowerPAD-8), TPS563201 (SOT-23-6), 3.3uH Sunlord
    MWSA0503S-3R3MT, 2.2nF and 3.3nF 0402/50V, 13.7K/17.4K/3.09K/54.9K/62K/75K
    0402 1%, new CoE_Power library with +6.5V. PMEG10030 now carries its
    SOD-128 footprint and the orderable PMEG10030ELPX; 10uH gets the real
    Sunlord ratings.
    Footprints: new L-5.4-5.2 (Sunlord land pattern), SOT-23-6 rebuilt with
    TI DDC0006A pads and a pin-1 mark only, silkscreen outlines removed from
    L-7.1-6.6 and Texas_R-PDSO-G8_TP. Dedicated molded-inductor STEP models
    for 5.4x5.2x2.8 and 7.0x6.6x2.8 mm.
2026-10-16 Add LMR38020, TPS564247 (SOT-563), 1210 and 5x5 2.2uH/4.7uH inductors, +16V
    Symbols: LMR38020 (80 V synchronous buck, DDA), TPS564247 (4 A, 1.2 MHz
    FCCM, SOT-563), 4.7uH and 2.2uH_HP Sunlord MWSA0503S, 2.2uH-1210 cjiang
    FTC322510S, 100nF-HV (100 V 0603), resistors 11.5K/220K/30K/294K/45.3K/
    6.65K, +16V in CoE_Power. Resistor values only used by superseded
    iterations (13.7K, 17.4K, 3.09K, 54.9K, 62K, 75K) removed.
    Footprints: SOT-563 per TI DRL0006A with a pin-1 mark only, L-3.2-2.5 per
    the cjiang land pattern; STEP models for both.
2026-10-22 Add Tork FPGA/low-voltage parts: TPS62827A, TPS7A94, BLM31SN500, 0201 caps
    Symbols
    - CoE_IntegratedCircuit: TPS62826, TPS62827A, TPS7A94, TPS3808G33, TLV75512
    - CoE_Capacitor: 1nF-0201, 1.2nF, 15pF, 4.7uF-0603, 10uF-LV, 100uF, 330uF
    - CoE_Resistor: 3.32K-TF (0.1 % thin film), 12.1K, 8.06K, 715R; drop unused 11.5K
    - CoE_Inductor: 0.47uH (DFE252012F-R47M), 50R-12A (BLM31SN500SN1L)
    - CoE_Crystal: 24MHz, 25MHz
    - CoE_Power: +0.5Vref replaces the unused +16V
    - CoE_Filters (new): NFE31PT101
    Footprints and coloured STEP models
    - C-0201, CP-3528, VSON-6 1.5x1.5 DMQ, WSON-10-EP 3x3 DSC, FL-3.2-1.6,
    L-1206, L-2.5-2.0, QFN-36-EP 6x6; L-5.4-5.2 and SOT-23-6 updated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
2026-10-22 Add Tork comms parts: JXD1-0001NL magjack, TF-01A microSD, TXS02612, SN74LVC2G07, 75R
    - JXD1-0001NL (Pulse, C5723156): gigabit RJ45 magjack with separate chip-side
    centre-tap capacitors (KSZ9031RNX section 12.0), symbol, footprint from the
    Pulse recommended PWB layout, coloured 3D model
    - TF-01A (Hroparts, C91145) microSD socket and TXS02612RTWR (C140276) SDIO
    level translator with the WQFN-24 4x4 RTW footprint and model
    - SN74LVC2G07DCKR (C7849) open-drain LED buffer, 75R 0402 (C25133)
    - HX5008NL magnetics (C962544) and RJHSE-5381 RJ45 (C599446) kept as
    catalogue parts (no longer used on Tork)
2026-10-22 Add servo-input and connector parts: SN74LVC1G17, MM5Z5V1T1G, 2.2K-HP, Molex 501190-2017
    - SN74LVC1G17DBVR (C7836) Schmitt buffer, SOT-23-5
    - MM5Z5V1T1G (C146754) 5.1 V zener, SOD-523
    - 2.2K-HP 0805 150 V (C17520) series fuse resistor
    - Molex 501190-2017 Pico-Clasp 2x10 (C505338): symbol, footprint after the
    501190-4017 series geometry, coloured 3D model
2026-10-24 Add 1EDN7116U TDI gate driver, BAT46WJ, 47K 0.1% 0603; final-review library updates
    - 1EDN7116U symbol, PG-TSNP-7-11 footprint (datasheet Rev 2.0 Figure 30 land
    and stencil) and coloured STEP model
    - BAT46WJ 100 V bootstrap Schottky with SOD-323F footprint, 47K-0.1%
    (RT0603BRD0747KL) for the TDI input pairs
    - Final-review parts: 2.2R-2512 (1 W), 1.5K, SMTSO4260 with M4_6mm footprint
    and STEP, R-2512, CP_Elec_10x10 (pad 2 = +), SMCJ51A, 62K-HP, 200K-HP,
    220K/30K 0.1%, 330R, 47R, 56K, 4.7uF-0805, 47uF-80V, 10nF-100V,
    24MHz-30R, TMP1075 with WSON-8 DSG
    - 2.2R -> UNI-ROYAL C25101, INA241A1 -> INA241A1QDDFRQ1,
    5.1R-HP -> ERJ-P06J5R1V, USBLC6-2SC6 MPN field
    - LMG1210 hidden VSS pins se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
2026-10-24 Add BZX384-B5V1, SOD-323, 15R-0603, 63.4K and the +5V5 power symbol
    Parts for the Zener-regulated high-side bootstrap of the 1EDN7116U drivers
    (datasheet Rev 2.0 Figure 4) fed from a dedicated +5V5 rail:
    - BZX384-B5V1 (5.1 V +/-2 %, SOD-323) with a SOD-323 footprint and STEP
    - 15R 0603 (Rboot), 63.4K 0402 (TPS563201 feedback), CoE_Power:+5V5
2026-10-24 Add TPS70950, MBR1H100SFT3G, BZX384-B5V6, 0.5R and LDO-supply passives; remove Zener-version parts
    - TPS70950 (5.0 V 150 mA 30 V LDO, TI DRVR pinout) + CoF_DualFlat:WSON-6-1EP_2x2mm_P0.65mm
    - MBR1H100SFT3G (100 V 1 A Schottky) + CoF_Diode:SOD-123F (onsemi 498 recommended land)
    - BZX384-B5V6 (5.6 V 2 % clamp), 4.7uF-25V (CBOOT), 4.7R-0603 (Rboot), 75K (6.5 V buck FB),
    0.5R (per-GaN gate resistor, Infineon EVAL_MTR_48V150A_GAN values)
    - 1EDN7116U: OUT_SNK and BST pins passive, so the paralleled outputs pass ERC
    - Removed the unused Zener-version parts: BAT46WJ, BZX384-B5V1, 15R-0603, 63.4K, +5V5,
    and the SOD-323F footprint and model that only BAT46WJ used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
2026-10-25 1EDN7116U VDD/VSS on the left, 10R-0603 Rboot; remove 4.7R-0603 and 75K
    - 1EDN7116U symbol: VDD and VSS moved to the left side, 3 grid steps (3.81 mm) from IN+ / IN-
    (VDD +6.35, IN+ +2.54, IN- -2.54, VSS -6.35); right side unchanged, box +/-7.62
    - CoE_Resistor:10R-0603 (0603WAF100JT5E, C22859) for the high-side bootstrap resistor
    - Removed 4.7R-0603 and 75K: no longer used (Rboot is 10 R; the TPS563201 6.5 V buck is gone)
2026-10-29 Redraw JXD1-0001NL and KSZ9031RNX, add SN74AHC04RGY and TPS3808G33DRV, compact ASE oscillator
    - JXD1-0001NL: all pins on the left (TRD1-4, YEL/GRN LEDs, CTC, SHIELD), LED glyphs and RJ45 pictogram
    - KSZ9031RNX: LED1/LED2/LED_MODE/XI/XO/ISET on the right, LDO_O/VSS/P_GND on the bottom
    - SN74AHC04RGY symbol with VQFN-14-EP 3.5x3.5 mm RGY footprint and STEP model
    - TPS3808G33 renamed to TPS3808G33DRV (WSON package)
    - ASE-33.333MHz body compacted
