Merophy/enzyme/(notices)

Notices in the files:
kiCad-solids/Connectors/USB-C-1054500101.step:
FILE_NAME( 'C:/Users/KMIROS~1/AppData/Local/Temp/psolqas_1356_34.stp', '2020-05-05T18:25:18', ( 'License CC BY-ND 4.0' ), ( 'CADENAS' ), ' ', 'PARTsolutions', ' ' );
